88431844/myMicroByte/reports/battery_2026-10-20/电池选购表.md

# v0.10 后盖电池候选（2026-10-20）

淘宝已登录，已查看以下商品详情。后盖电池框52×30 mm，建议电池含保护板、包边的成品包络≤51×29×3.3 mm。下表尺寸顺序均为长×宽×厚。价格为查看时页面显示，不含运费变化或个性化优惠变化。

| 商品图片 | 商家／规格 | 容量 | 商家尺寸依据（mm） | 页面价格 | 商品链接与判断 |
|---|---|---|---|---|---|
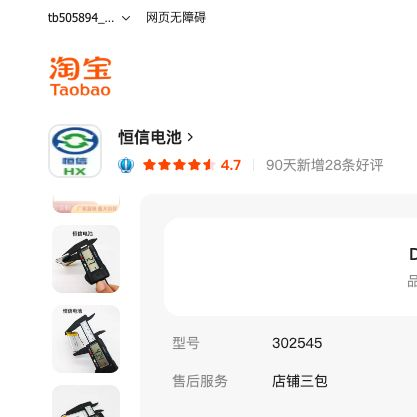
[picture p1: reports/battery_2026-10-20/hengxin.png]
恒信
|  | 恒信电池／302545 | 320 mAh | 标称45×25×3；三张卡尺图约43.4×24.8×2.7 | ¥3.50，页面运费¥6 | [淘宝商品](https://item.taobao.com/item.htm?id=611922672957)。尺寸优先候选；图示样品不代表每批交货尺寸，需确认保护板处最大厚度。 |
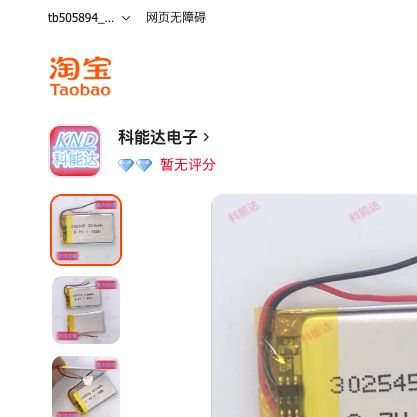
[picture p2: reports/battery_2026-10-20/knd.png]
科能达
|  | 科能达电子／302545 | 320 mAh | 45±0.5 ×25±0.5 ×3.0±0.2；文字说明为带保护板成品 | ¥4.50，页面运费¥6 | [淘宝商品](https://item.taobao.com/item.htm?id=607992859684)。尺寸公差写得较清楚；标题包含其他型号，下单需明确302545。 |
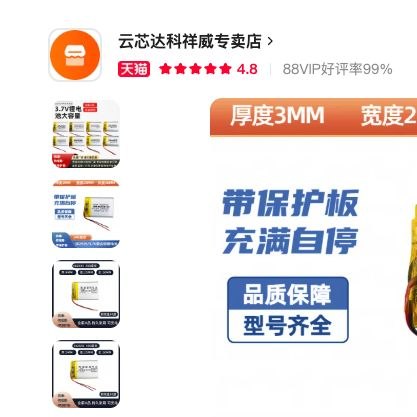
[picture p3: reports/battery_2026-10-20/yunxinda.png]
云芯达
|  | 云芯达科祥威专卖店／302535-240毫安 | 240 mAh | 已选规格图片标36×25×3，带保护板；不是直接按型号推断35 mm长 | ¥9.40，页面免运费 | [淘宝／天猫商品](https://detail.tmall.com/item.htm?id=1014787417174)。空间余量更大、容量较小；只选302535-240毫安。 |

## 选购判断

按机械尺寸优先考虑302545；当前尚不能保证整机电气兼容。恒信和科能达详情均标注最大充、放电1C，即320 mA。其保护板允许2A/3A不等于电芯允许持续输出相同电流。需核对掌机充电设定及ESP32、屏幕、喇叭工作时的峰值电流。云芯达所选240 mAh规格的充放电上限未确认。

PCB参考模型的BAT座标识为HC-1.25-2PWT、2针1.25 mm间距；应核对配套插头外形及正负极，不仅按“1.25插头”名称购买。成品线头、保护板突起不可挤进壳体夹缝。

可复制给卖家的询问（尚未发送）：

> 我要用于ESP32掌机，需要单节3.7V、4.2V充满的锂聚合物电池。请确认含保护板、包边、焊点的最大成品尺寸不超过51×29×3.3 mm，并提供保护板处厚度、持续/峰值放电电流及允许充电电流。需要与HC-1.25-2PWT板端座配套的两针插头，正负极按我提供的PCB接口照片匹配。302545型号能否满足？

本表为尺寸候选清单，不是实测续航或容量认证。未下单、未加入购物车、未联系卖家。
