88431844/myMicroByte/项目文件索引.md

# 项目文件索引

整理日期：2026-10-22。以下均为项目目录内文件，按类型和版本路径排列。

新增移入的装配视图在 `reports/assembly_exports/`，早期在线依赖预览在 `output/assembly-guide-v03-legacy/`。新版交互页面含内嵌模型与脚本。

## 外壳模型与交换文件（31）

- [output/myMicrobyte_FreeCAD_v01_试装包/myMicrobyte_enclosure_v01.FCStd](output/myMicrobyte_FreeCAD_v01_%E8%AF%95%E8%A3%85%E5%8C%85/myMicrobyte_enclosure_v01.FCStd)
- [output/myMicrobyte_FreeCAD_v01_试装包/myMicrobyte_enclosure_v01.step](output/myMicrobyte_FreeCAD_v01_%E8%AF%95%E8%A3%85%E5%8C%85/myMicrobyte_enclosure_v01.step)
- [output/myMicrobyte_FreeCAD_v01_试装包/myMicrobyte_fit_coupons.FCStd](output/myMicrobyte_FreeCAD_v01_%E8%AF%95%E8%A3%85%E5%8C%85/myMicrobyte_fit_coupons.FCStd)
- [output/myMicrobyte_FreeCAD_v01_试装包/myMicrobyte_fit_coupons.step](output/myMicrobyte_FreeCAD_v01_%E8%AF%95%E8%A3%85%E5%8C%85/myMicrobyte_fit_coupons.step)
- [output/myMicrobyte_blackPLA_preview.FCStd](output/myMicrobyte_blackPLA_preview.FCStd)
- [output/myMicrobyte_enclosure_v01.FCStd](output/myMicrobyte_enclosure_v01.FCStd)
- [output/myMicrobyte_enclosure_v01.step](output/myMicrobyte_enclosure_v01.step)
- [output/myMicrobyte_fit_coupons.FCStd](output/myMicrobyte_fit_coupons.FCStd)
- [output/myMicrobyte_fit_coupons.step](output/myMicrobyte_fit_coupons.step)
- [output/v02/myMicrobyte_enclosure_v02.FCStd](output/v02/myMicrobyte_enclosure_v02.FCStd)
- [output/v02/myMicrobyte_enclosure_v02.step](output/v02/myMicrobyte_enclosure_v02.step)
- [output/v03/myMicrobyte_enclosure_v03.FCStd](output/v03/myMicrobyte_enclosure_v03.FCStd)
- [output/v03/myMicrobyte_enclosure_v03.step](output/v03/myMicrobyte_enclosure_v03.step)
- [output/v04/myMicrobyte_enclosure_v04.FCStd](output/v04/myMicrobyte_enclosure_v04.FCStd)
- [output/v04/myMicrobyte_enclosure_v04.step](output/v04/myMicrobyte_enclosure_v04.step)
- [output/v05/myMicrobyte_enclosure_v05.FCStd](output/v05/myMicrobyte_enclosure_v05.FCStd)
- [output/v05/myMicrobyte_enclosure_v05.step](output/v05/myMicrobyte_enclosure_v05.step)
- [output/v06/myMicrobyte_enclosure_v06.FCStd](output/v06/myMicrobyte_enclosure_v06.FCStd)
- [output/v06/myMicrobyte_enclosure_v06.step](output/v06/myMicrobyte_enclosure_v06.step)
- [output/v07/myMicrobyte_enclosure_v07.FCStd](output/v07/myMicrobyte_enclosure_v07.FCStd)
- [output/v07/myMicrobyte_enclosure_v07.step](output/v07/myMicrobyte_enclosure_v07.step)
- [output/v08/myMicrobyte_enclosure_v08.FCStd](output/v08/myMicrobyte_enclosure_v08.FCStd)
- [output/v08/myMicrobyte_v08_A_raised.step](output/v08/myMicrobyte_v08_A_raised.step)
- [output/v08/myMicrobyte_v08_B_flat.step](output/v08/myMicrobyte_v08_B_flat.step)
- [output/v08_trials/myMicrobyte_v08_trials.FCStd](output/v08_trials/myMicrobyte_v08_trials.FCStd)
- [output/v09/myMicrobyte_enclosure_v09.FCStd](output/v09/myMicrobyte_enclosure_v09.FCStd)
- [output/v09/myMicrobyte_enclosure_v09.step](output/v09/myMicrobyte_enclosure_v09.step)
- [output/v10/myMicrobyte_enclosure_v10.FCStd](output/v10/myMicrobyte_enclosure_v10.FCStd)
- [output/v10/myMicrobyte_enclosure_v10.step](output/v10/myMicrobyte_enclosure_v10.step)
- [reference/pcb-current.step](reference/pcb-current.step)
- [reports/battery_expansion/enlarged_frame_study.FCStd](reports/battery_expansion/enlarged_frame_study.FCStd)

## STL 打印模型（127）

- [output/Cap_A_print.stl](output/Cap_A_print.stl)
- [output/Cap_B_print.stl](output/Cap_B_print.stl)
- [output/Cap_DOWN_print.stl](output/Cap_DOWN_print.stl)
- [output/Cap_LEFT_print.stl](output/Cap_LEFT_print.stl)
- [output/Cap_MENU_print.stl](output/Cap_MENU_print.stl)
- [output/Cap_RIGHT_print.stl](output/Cap_RIGHT_print.stl)
- [output/Cap_SELECT_print.stl](output/Cap_SELECT_print.stl)
- [output/Cap_START_print.stl](output/Cap_START_print.stl)
- [output/Cap_UP_print.stl](output/Cap_UP_print.stl)
- [output/Fit_ButtonGuide.stl](output/Fit_ButtonGuide.stl)
- [output/Fit_FrontReceiver.stl](output/Fit_FrontReceiver.stl)
- [output/Fit_RearTongue.stl](output/Fit_RearTongue.stl)
- [output/Fit_ScrewPilot.stl](output/Fit_ScrewPilot.stl)
- [output/FrontShell_print.stl](output/FrontShell_print.stl)
- [output/RearShell_print.stl](output/RearShell_print.stl)
- [output/myMicrobyte_FreeCAD_v01_试装包/Cap_A_print.stl](output/myMicrobyte_FreeCAD_v01_%E8%AF%95%E8%A3%85%E5%8C%85/Cap_A_print.stl)
- [output/myMicrobyte_FreeCAD_v01_试装包/Cap_B_print.stl](output/myMicrobyte_FreeCAD_v01_%E8%AF%95%E8%A3%85%E5%8C%85/Cap_B_print.stl)
- [output/myMicrobyte_FreeCAD_v01_试装包/Cap_DOWN_print.stl](output/myMicrobyte_FreeCAD_v01_%E8%AF%95%E8%A3%85%E5%8C%85/Cap_DOWN_print.stl)
- [output/myMicrobyte_FreeCAD_v01_试装包/Cap_LEFT_print.stl](output/myMicrobyte_FreeCAD_v01_%E8%AF%95%E8%A3%85%E5%8C%85/Cap_LEFT_print.stl)
- [output/myMicrobyte_FreeCAD_v01_试装包/Cap_MENU_print.stl](output/myMicrobyte_FreeCAD_v01_%E8%AF%95%E8%A3%85%E5%8C%85/Cap_MENU_print.stl)
- [output/myMicrobyte_FreeCAD_v01_试装包/Cap_RIGHT_print.stl](output/myMicrobyte_FreeCAD_v01_%E8%AF%95%E8%A3%85%E5%8C%85/Cap_RIGHT_print.stl)
- [output/myMicrobyte_FreeCAD_v01_试装包/Cap_SELECT_print.stl](output/myMicrobyte_FreeCAD_v01_%E8%AF%95%E8%A3%85%E5%8C%85/Cap_SELECT_print.stl)
- [output/myMicrobyte_FreeCAD_v01_试装包/Cap_START_print.stl](output/myMicrobyte_FreeCAD_v01_%E8%AF%95%E8%A3%85%E5%8C%85/Cap_START_print.stl)
- [output/myMicrobyte_FreeCAD_v01_试装包/Cap_UP_print.stl](output/myMicrobyte_FreeCAD_v01_%E8%AF%95%E8%A3%85%E5%8C%85/Cap_UP_print.stl)
- [output/myMicrobyte_FreeCAD_v01_试装包/Fit_ButtonGuide.stl](output/myMicrobyte_FreeCAD_v01_%E8%AF%95%E8%A3%85%E5%8C%85/Fit_ButtonGuide.stl)
- [output/myMicrobyte_FreeCAD_v01_试装包/Fit_FrontReceiver.stl](output/myMicrobyte_FreeCAD_v01_%E8%AF%95%E8%A3%85%E5%8C%85/Fit_FrontReceiver.stl)
- [output/myMicrobyte_FreeCAD_v01_试装包/Fit_RearTongue.stl](output/myMicrobyte_FreeCAD_v01_%E8%AF%95%E8%A3%85%E5%8C%85/Fit_RearTongue.stl)
- [output/myMicrobyte_FreeCAD_v01_试装包/Fit_ScrewPilot.stl](output/myMicrobyte_FreeCAD_v01_%E8%AF%95%E8%A3%85%E5%8C%85/Fit_ScrewPilot.stl)
- [output/myMicrobyte_FreeCAD_v01_试装包/FrontShell_print.stl](output/myMicrobyte_FreeCAD_v01_%E8%AF%95%E8%A3%85%E5%8C%85/FrontShell_print.stl)
- [output/myMicrobyte_FreeCAD_v01_试装包/RearShell_print.stl](output/myMicrobyte_FreeCAD_v01_%E8%AF%95%E8%A3%85%E5%8C%85/RearShell_print.stl)
- [output/v02/Cap_A_print.stl](output/v02/Cap_A_print.stl)
- [output/v02/Cap_B_print.stl](output/v02/Cap_B_print.stl)
- [output/v02/Cap_DOWN_print.stl](output/v02/Cap_DOWN_print.stl)
- [output/v02/Cap_LEFT_print.stl](output/v02/Cap_LEFT_print.stl)
- [output/v02/Cap_MENU_print.stl](output/v02/Cap_MENU_print.stl)
- [output/v02/Cap_RIGHT_print.stl](output/v02/Cap_RIGHT_print.stl)
- [output/v02/Cap_SELECT_print.stl](output/v02/Cap_SELECT_print.stl)
- [output/v02/Cap_START_print.stl](output/v02/Cap_START_print.stl)
- [output/v02/Cap_UP_print.stl](output/v02/Cap_UP_print.stl)
- [output/v02/FrontShell_print.stl](output/v02/FrontShell_print.stl)
- [output/v02/RearShell_print.stl](output/v02/RearShell_print.stl)
- [output/v03/Cap_A_print.stl](output/v03/Cap_A_print.stl)
- [output/v03/Cap_B_print.stl](output/v03/Cap_B_print.stl)
- [output/v03/Cap_DOWN_print.stl](output/v03/Cap_DOWN_print.stl)
- [output/v03/Cap_LEFT_print.stl](output/v03/Cap_LEFT_print.stl)
- [output/v03/Cap_MENU_print.stl](output/v03/Cap_MENU_print.stl)
- [output/v03/Cap_RIGHT_print.stl](output/v03/Cap_RIGHT_print.stl)
- [output/v03/Cap_SELECT_print.stl](output/v03/Cap_SELECT_print.stl)
- [output/v03/Cap_START_print.stl](output/v03/Cap_START_print.stl)
- [output/v03/Cap_UP_print.stl](output/v03/Cap_UP_print.stl)
- [output/v03/FrontShell_print.stl](output/v03/FrontShell_print.stl)
- [output/v03/PowerSlider_print.stl](output/v03/PowerSlider_print.stl)
- [output/v03/RearShell_print.stl](output/v03/RearShell_print.stl)
- [output/v04/FrontShell_print.stl](output/v04/FrontShell_print.stl)
- [output/v04/PowerSlider_print.stl](output/v04/PowerSlider_print.stl)
- [output/v04/RearShell_print.stl](output/v04/RearShell_print.stl)
- [output/v05/FrontShell_print.stl](output/v05/FrontShell_print.stl)
- [output/v05/PowerSlider_print.stl](output/v05/PowerSlider_print.stl)
- [output/v05/RearShell_print.stl](output/v05/RearShell_print.stl)
- [output/v06/AcousticLid_print.stl](output/v06/AcousticLid_print.stl)
- [output/v06/FrontShell_print.stl](output/v06/FrontShell_print.stl)
- [output/v06/PowerSlider_print.stl](output/v06/PowerSlider_print.stl)
- [output/v06/RearShell_print.stl](output/v06/RearShell_print.stl)
- [output/v07/AcousticLid_print.stl](output/v07/AcousticLid_print.stl)
- [output/v07/FrontShell_print.stl](output/v07/FrontShell_print.stl)
- [output/v07/PowerSlider_print.stl](output/v07/PowerSlider_print.stl)
- [output/v07/RearShell_print.stl](output/v07/RearShell_print.stl)
- [output/v08/AcousticLid_print.stl](output/v08/AcousticLid_print.stl)
- [output/v08/FrontShell_A_raised_print.stl](output/v08/FrontShell_A_raised_print.stl)
- [output/v08/FrontShell_B_flat_print.stl](output/v08/FrontShell_B_flat_print.stl)
- [output/v08/PowerSlider_print.stl](output/v08/PowerSlider_print.stl)
- [output/v08/RearShell_print.stl](output/v08/RearShell_print.stl)
- [output/v08_trials/F1_print.stl](output/v08_trials/F1_print.stl)
- [output/v08_trials/F2_print.stl](output/v08_trials/F2_print.stl)
- [output/v08_trials/F3_print.stl](output/v08_trials/F3_print.stl)
- [output/v08_trials/F4_print.stl](output/v08_trials/F4_print.stl)
- [output/v08_trials/L1_print.stl](output/v08_trials/L1_print.stl)
- [output/v08_trials/L2_print.stl](output/v08_trials/L2_print.stl)
- [output/v08_trials/R1_print.stl](output/v08_trials/R1_print.stl)
- [output/v08_trials/R2_print.stl](output/v08_trials/R2_print.stl)
- [output/v08_trials/S1_print.stl](output/v08_trials/S1_print.stl)
- [output/v08_trials/S2_print.stl](output/v08_trials/S2_print.stl)
- [output/v08_trials/S3_print.stl](output/v08_trials/S3_print.stl)
- [output/v09/FrontShell_print.stl](output/v09/FrontShell_print.stl)
- [output/v09/PowerSlider_print.stl](output/v09/PowerSlider_print.stl)
- [output/v09/RearShell_print.stl](output/v09/RearShell_print.stl)
- [output/v09/SliderKeeper_print.stl](output/v09/SliderKeeper_print.stl)
- [output/v10/FrontShell_print.stl](output/v10/FrontShell_print.stl)
- [output/v10/PowerSlider_print.stl](output/v10/PowerSlider_print.stl)
- [output/v10/RearShell_print.stl](output/v10/RearShell_print.stl)
- [printing/A1_black_PLA_v08_trials/F1_print.stl](printing/A1_black_PLA_v08_trials/F1_print.stl)
- [printing/A1_black_PLA_v08_trials/F2_print.stl](printing/A1_black_PLA_v08_trials/F2_print.stl)
- [printing/A1_black_PLA_v08_trials/F3_print.stl](printing/A1_black_PLA_v08_trials/F3_print.stl)
- [printing/A1_black_PLA_v08_trials/F4_print.stl](printing/A1_black_PLA_v08_trials/F4_print.stl)
- [printing/A1_black_PLA_v08_trials/L1_print.stl](printing/A1_black_PLA_v08_trials/L1_print.stl)
- [printing/A1_black_PLA_v08_trials/L2_print.stl](printing/A1_black_PLA_v08_trials/L2_print.stl)
- [printing/A1_black_PLA_v08_trials/R1_print.stl](printing/A1_black_PLA_v08_trials/R1_print.stl)
- [printing/A1_black_PLA_v08_trials/R2_print.stl](printing/A1_black_PLA_v08_trials/R2_print.stl)
- [printing/A1_black_PLA_v08_trials/S1_print.stl](printing/A1_black_PLA_v08_trials/S1_print.stl)
- [printing/A1_black_PLA_v08_trials/S2_print.stl](printing/A1_black_PLA_v08_trials/S2_print.stl)
- [printing/A1_black_PLA_v08_trials/S3_print.stl](printing/A1_black_PLA_v08_trials/S3_print.stl)
- [printing/A1_black_PLA_v10/FrontShell_print.stl](printing/A1_black_PLA_v10/FrontShell_print.stl)
- [printing/A1_black_PLA_v10/PowerSlider_print.stl](printing/A1_black_PLA_v10/PowerSlider_print.stl)
- [printing/A1_black_PLA_v10/RearShell_print.stl](printing/A1_black_PLA_v10/RearShell_print.stl)
- [printing/A1_black_PLA_v10_4sets/FrontShell_set1.stl](printing/A1_black_PLA_v10_4sets/FrontShell_set1.stl)
- [printing/A1_black_PLA_v10_4sets/FrontShell_set2.stl](printing/A1_black_PLA_v10_4sets/FrontShell_set2.stl)
- [printing/A1_black_PLA_v10_4sets/FrontShell_set3.stl](printing/A1_black_PLA_v10_4sets/FrontShell_set3.stl)
- [printing/A1_black_PLA_v10_4sets/FrontShell_set4.stl](printing/A1_black_PLA_v10_4sets/FrontShell_set4.stl)
- [printing/A1_black_PLA_v10_4sets/PowerSlider_set1.stl](printing/A1_black_PLA_v10_4sets/PowerSlider_set1.stl)
- [printing/A1_black_PLA_v10_4sets/PowerSlider_set2.stl](printing/A1_black_PLA_v10_4sets/PowerSlider_set2.stl)
- [printing/A1_black_PLA_v10_4sets/PowerSlider_set3.stl](printing/A1_black_PLA_v10_4sets/PowerSlider_set3.stl)
- [printing/A1_black_PLA_v10_4sets/PowerSlider_set4.stl](printing/A1_black_PLA_v10_4sets/PowerSlider_set4.stl)
- [printing/A1_black_PLA_v10_4sets/RearShell_set1.stl](printing/A1_black_PLA_v10_4sets/RearShell_set1.stl)
- [printing/A1_black_PLA_v10_4sets/RearShell_set2.stl](printing/A1_black_PLA_v10_4sets/RearShell_set2.stl)
- [printing/A1_black_PLA_v10_4sets/RearShell_set3.stl](printing/A1_black_PLA_v10_4sets/RearShell_set3.stl)
- [printing/A1_black_PLA_v10_4sets/RearShell_set4.stl](printing/A1_black_PLA_v10_4sets/RearShell_set4.stl)
- [printing/A1_black_green_blue_PLA_v07/AcousticLid_print.stl](printing/A1_black_green_blue_PLA_v07/AcousticLid_print.stl)
- [printing/A1_black_green_blue_PLA_v07/FrontShell_print.stl](printing/A1_black_green_blue_PLA_v07/FrontShell_print.stl)
- [printing/A1_black_green_blue_PLA_v07/PowerSlider_black_1.stl](printing/A1_black_green_blue_PLA_v07/PowerSlider_black_1.stl)
- [printing/A1_black_green_blue_PLA_v07/PowerSlider_black_2.stl](printing/A1_black_green_blue_PLA_v07/PowerSlider_black_2.stl)
- [printing/A1_black_green_blue_PLA_v07/PowerSlider_blue_1.stl](printing/A1_black_green_blue_PLA_v07/PowerSlider_blue_1.stl)
- [printing/A1_black_green_blue_PLA_v07/PowerSlider_blue_2.stl](printing/A1_black_green_blue_PLA_v07/PowerSlider_blue_2.stl)
- [printing/A1_black_green_blue_PLA_v07/PowerSlider_green_1.stl](printing/A1_black_green_blue_PLA_v07/PowerSlider_green_1.stl)
- [printing/A1_black_green_blue_PLA_v07/PowerSlider_green_2.stl](printing/A1_black_green_blue_PLA_v07/PowerSlider_green_2.stl)
- [printing/A1_black_green_blue_PLA_v07/RearShell_print.stl](printing/A1_black_green_blue_PLA_v07/RearShell_print.stl)
- [printing/A1_blue_PLA_expanded_rear_2/RearExpanded_1.stl](printing/A1_blue_PLA_expanded_rear_2/RearExpanded_1.stl)
- [printing/A1_blue_PLA_expanded_rear_2/RearExpanded_2.stl](printing/A1_blue_PLA_expanded_rear_2/RearExpanded_2.stl)

## 拓竹打印工程与切片（14）

- [printing/A1_black_PLA/myMicrobyte_A1_black_PLA_sliced.3mf](printing/A1_black_PLA/myMicrobyte_A1_black_PLA_sliced.3mf)
- [printing/A1_black_PLA_v02/myMicrobyte_v02_A1_black_PLA_sliced.3mf](printing/A1_black_PLA_v02/myMicrobyte_v02_A1_black_PLA_sliced.3mf)
- [printing/A1_black_PLA_v03/myMicrobyte_v03_A1_black_PLA_sliced.3mf](printing/A1_black_PLA_v03/myMicrobyte_v03_A1_black_PLA_sliced.3mf)
- [printing/A1_black_PLA_v04/myMicrobyte_v04_A1_black_PLA_sliced.3mf](printing/A1_black_PLA_v04/myMicrobyte_v04_A1_black_PLA_sliced.3mf)
- [printing/A1_black_PLA_v08_trials/myMicrobyte_v08_trials_black.3mf](printing/A1_black_PLA_v08_trials/myMicrobyte_v08_trials_black.3mf)
- [printing/A1_black_PLA_v08_trials/myMicrobyte_v08_trials_black.gcode.3mf](printing/A1_black_PLA_v08_trials/myMicrobyte_v08_trials_black.gcode.3mf)
- [printing/A1_black_PLA_v10/myMicrobyte_v10_black.3mf](printing/A1_black_PLA_v10/myMicrobyte_v10_black.3mf)
- [printing/A1_black_PLA_v10/myMicrobyte_v10_black.gcode.3mf](printing/A1_black_PLA_v10/myMicrobyte_v10_black.gcode.3mf)
- [printing/A1_black_PLA_v10_4sets/myMicrobyte_v10_4sets_black.3mf](printing/A1_black_PLA_v10_4sets/myMicrobyte_v10_4sets_black.3mf)
- [printing/A1_black_PLA_v10_4sets/myMicrobyte_v10_4sets_black.gcode.3mf](printing/A1_black_PLA_v10_4sets/myMicrobyte_v10_4sets_black.gcode.3mf)
- [printing/A1_black_green_blue_PLA_v07/myMicrobyte_v07_A1_black_green_blue.3mf](printing/A1_black_green_blue_PLA_v07/myMicrobyte_v07_A1_black_green_blue.3mf)
- [printing/A1_black_green_blue_PLA_v07/myMicrobyte_v07_A1_black_green_blue.gcode.3mf](printing/A1_black_green_blue_PLA_v07/myMicrobyte_v07_A1_black_green_blue.gcode.3mf)
- [printing/A1_blue_PLA_expanded_rear_2/myMicrobyte_expanded_rear_2_blue.3mf](printing/A1_blue_PLA_expanded_rear_2/myMicrobyte_expanded_rear_2_blue.3mf)
- [printing/A1_blue_PLA_expanded_rear_2/myMicrobyte_expanded_rear_2_blue.gcode.3mf](printing/A1_blue_PLA_expanded_rear_2/myMicrobyte_expanded_rear_2_blue.gcode.3mf)

## 3D 交互装配与爆炸图页面（9）

- [output/assembly-guide/index.html](output/assembly-guide/index.html)
- [output/assembly-guide-v03-legacy/index.html](output/assembly-guide-v03-legacy/index.html)
- [output/assembly-guide-v04/index.html](output/assembly-guide-v04/index.html)
- [output/assembly-guide-v05/index.html](output/assembly-guide-v05/index.html)
- [output/assembly-guide-v06/index.html](output/assembly-guide-v06/index.html)
- [output/assembly-guide-v07/index.html](output/assembly-guide-v07/index.html)
- [output/assembly-guide-v08/index.html](output/assembly-guide-v08/index.html)
- [output/assembly-guide-v09/index.html](output/assembly-guide-v09/index.html)
- [output/assembly-guide-v10/index.html](output/assembly-guide-v10/index.html)

## 图片与对比图（253）

- [output/myMicrobyte_FreeCAD_v01_试装包/reports/assembly.png](output/myMicrobyte_FreeCAD_v01_%E8%AF%95%E8%A3%85%E5%8C%85/reports/assembly.png)
- [output/myMicrobyte_FreeCAD_v01_试装包/reports/freecad_preview.png](output/myMicrobyte_FreeCAD_v01_%E8%AF%95%E8%A3%85%E5%8C%85/reports/freecad_preview.png)
- [output/myMicrobyte_FreeCAD_v01_试装包/reports/front_inside.png](output/myMicrobyte_FreeCAD_v01_%E8%AF%95%E8%A3%85%E5%8C%85/reports/front_inside.png)
- [output/myMicrobyte_FreeCAD_v01_试装包/reports/rear_inside.png](output/myMicrobyte_FreeCAD_v01_%E8%AF%95%E8%A3%85%E5%8C%85/reports/rear_inside.png)
- [output/v08/v08_acoustic_slider_details.png](output/v08/v08_acoustic_slider_details.png)
- [output/v08/v08_exploded_comparison.png](output/v08/v08_exploded_comparison.png)
- [output/v08/v08_front_comparison.png](output/v08/v08_front_comparison.png)
- [output/v09/v09_assembly_review.png](output/v09/v09_assembly_review.png)
- [output/v09/v09_rear_slider_review.png](output/v09/v09_rear_slider_review.png)
- [output/v09/v09_screen_review.png](output/v09/v09_screen_review.png)
- [output/v10/v10_assembly_review.png](output/v10/v10_assembly_review.png)
- [output/v10/v10_gba_slider_review.png](output/v10/v10_gba_slider_review.png)
- [reference/eda_backup/IMAGE/464badd25d2691be.webp](reference/eda_backup/IMAGE/464badd25d2691be.webp)
- [reference/eda_backup/IMAGE/5a8d8aaf7cc2b85a.webp](reference/eda_backup/IMAGE/5a8d8aaf7cc2b85a.webp)
- [reference/filaments_20261017/loaded_slots.jpg](reference/filaments_20261017/loaded_slots.jpg)
- [reference/filaments_20261017/stock.jpg](reference/filaments_20261017/stock.jpg)
- [reference/user_dimensions/LCD_1p9mm.png](reference/user_dimensions/LCD_1p9mm.png)
- [reference/user_dimensions/Speaker_1510.png](reference/user_dimensions/Speaker_1510.png)
- [reference/v03_feedback/MSK12C02_dimensions.png](reference/v03_feedback/MSK12C02_dimensions.png)
- [reference/v04_feedback/lcd_dimensions.png](reference/v04_feedback/lcd_dimensions.png)
- [reference/v04_feedback/photo_01.jpg](reference/v04_feedback/photo_01.jpg)
- [reference/v04_feedback/photo_02.jpg](reference/v04_feedback/photo_02.jpg)
- [reference/v04_feedback/photo_03.jpg](reference/v04_feedback/photo_03.jpg)
- [reference/v04_feedback/photo_04.jpg](reference/v04_feedback/photo_04.jpg)
- [reference/v04_feedback/photo_05.jpg](reference/v04_feedback/photo_05.jpg)
- [reference/v04_feedback/photo_06.jpg](reference/v04_feedback/photo_06.jpg)
- [reference/v04_feedback/photo_07.jpg](reference/v04_feedback/photo_07.jpg)
- [reference/v04_feedback/photo_08.jpg](reference/v04_feedback/photo_08.jpg)
- [reference/v04_feedback/photo_09.jpg](reference/v04_feedback/photo_09.jpg)
- [reference/v04_feedback/photo_10.jpg](reference/v04_feedback/photo_10.jpg)
- [reference/v04_feedback/photo_11.jpg](reference/v04_feedback/photo_11.jpg)
- [reference/v04_feedback/photo_12.jpg](reference/v04_feedback/photo_12.jpg)
- [reference/v04_feedback/photo_13.jpg](reference/v04_feedback/photo_13.jpg)
- [reference/v04_feedback/photo_14.jpg](reference/v04_feedback/photo_14.jpg)
- [reference/v05_feedback/attachment_01.jpg](reference/v05_feedback/attachment_01.jpg)
- [reference/v05_feedback/attachment_02.jpg](reference/v05_feedback/attachment_02.jpg)
- [reference/v05_feedback/attachment_03.jpg](reference/v05_feedback/attachment_03.jpg)
- [reference/v05_feedback/attachment_04.jpg](reference/v05_feedback/attachment_04.jpg)
- [reference/v05_feedback/attachment_05.jpg](reference/v05_feedback/attachment_05.jpg)
- [reference/v05_feedback/attachment_06.jpg](reference/v05_feedback/attachment_06.jpg)
- [reference/v05_feedback/attachment_07.jpg](reference/v05_feedback/attachment_07.jpg)
- [reference/v05_feedback/attachment_08.jpg](reference/v05_feedback/attachment_08.jpg)
- [reference/v05_feedback/attachment_09.jpg](reference/v05_feedback/attachment_09.jpg)
- [reference/v05_feedback/contact_sheet.jpg](reference/v05_feedback/contact_sheet.jpg)
- [reference/v08_feedback/photo_01.jpg](reference/v08_feedback/photo_01.jpg)
- [reference/v08_feedback/photo_02.jpg](reference/v08_feedback/photo_02.jpg)
- [reference/v08_feedback/photo_03.jpg](reference/v08_feedback/photo_03.jpg)
- [reference/v08_feedback/photo_04.jpg](reference/v08_feedback/photo_04.jpg)
- [reference/v08_feedback/photo_05.jpg](reference/v08_feedback/photo_05.jpg)
- [reference/v08_feedback/photo_06.jpg](reference/v08_feedback/photo_06.jpg)
- [reference/v09_feedback/IMG_8476.jpg](reference/v09_feedback/IMG_8476.jpg)
- [reference/v09_feedback/IMG_8477.jpg](reference/v09_feedback/IMG_8477.jpg)
- [reference/v09_feedback/IMG_8478.jpg](reference/v09_feedback/IMG_8478.jpg)
- [reference/v09_feedback/IMG_8479.jpg](reference/v09_feedback/IMG_8479.jpg)
- [reference/v09_feedback/IMG_8480.jpg](reference/v09_feedback/IMG_8480.jpg)
- [reference/v09_feedback/contact_sheet.jpg](reference/v09_feedback/contact_sheet.jpg)
- [reference/v09_feedback/weak_slider_tabs.png](reference/v09_feedback/weak_slider_tabs.png)
- [reference/v10_gba/gba_slider_removed.png](reference/v10_gba/gba_slider_removed.png)
- [reference/v10_gba/gba_slider_seated.png](reference/v10_gba/gba_slider_seated.png)
- [reports/Bambu_A1_preview.png](reports/Bambu_A1_preview.png)
- [reports/assembly.png](reports/assembly.png)
- [reports/assembly_exports/v03/myMicrobyte-v03-装配视图.png](reports/assembly_exports/v03/myMicrobyte-v03-%E8%A3%85%E9%85%8D%E8%A7%86%E5%9B%BE.png)
- [reports/assembly_exports/v06/myMicrobyte-v06-装配视图 (1).png](reports/assembly_exports/v06/myMicrobyte-v06-%E8%A3%85%E9%85%8D%E8%A7%86%E5%9B%BE%20%281%29.png)
- [reports/assembly_exports/v06/myMicrobyte-v06-装配视图 (2).png](reports/assembly_exports/v06/myMicrobyte-v06-%E8%A3%85%E9%85%8D%E8%A7%86%E5%9B%BE%20%282%29.png)
- [reports/assembly_exports/v06/myMicrobyte-v06-装配视图 (3).png](reports/assembly_exports/v06/myMicrobyte-v06-%E8%A3%85%E9%85%8D%E8%A7%86%E5%9B%BE%20%283%29.png)
- [reports/assembly_exports/v06/myMicrobyte-v06-装配视图 (4).png](reports/assembly_exports/v06/myMicrobyte-v06-%E8%A3%85%E9%85%8D%E8%A7%86%E5%9B%BE%20%284%29.png)
- [reports/assembly_exports/v06/myMicrobyte-v06-装配视图.png](reports/assembly_exports/v06/myMicrobyte-v06-%E8%A3%85%E9%85%8D%E8%A7%86%E5%9B%BE.png)
- [reports/assembly_exports/v07/myMicrobyte-v07-装配视图 (1).png](reports/assembly_exports/v07/myMicrobyte-v07-%E8%A3%85%E9%85%8D%E8%A7%86%E5%9B%BE%20%281%29.png)
- [reports/assembly_exports/v07/myMicrobyte-v07-装配视图 (2).png](reports/assembly_exports/v07/myMicrobyte-v07-%E8%A3%85%E9%85%8D%E8%A7%86%E5%9B%BE%20%282%29.png)
- [reports/assembly_exports/v07/myMicrobyte-v07-装配视图 (3).png](reports/assembly_exports/v07/myMicrobyte-v07-%E8%A3%85%E9%85%8D%E8%A7%86%E5%9B%BE%20%283%29.png)
- [reports/assembly_exports/v07/myMicrobyte-v07-装配视图 (4).png](reports/assembly_exports/v07/myMicrobyte-v07-%E8%A3%85%E9%85%8D%E8%A7%86%E5%9B%BE%20%284%29.png)
- [reports/assembly_exports/v07/myMicrobyte-v07-装配视图 (5).png](reports/assembly_exports/v07/myMicrobyte-v07-%E8%A3%85%E9%85%8D%E8%A7%86%E5%9B%BE%20%285%29.png)
- [reports/assembly_exports/v07/myMicrobyte-v07-装配视图 (6).png](reports/assembly_exports/v07/myMicrobyte-v07-%E8%A3%85%E9%85%8D%E8%A7%86%E5%9B%BE%20%286%29.png)
- [reports/assembly_exports/v07/myMicrobyte-v07-装配视图 (7).png](reports/assembly_exports/v07/myMicrobyte-v07-%E8%A3%85%E9%85%8D%E8%A7%86%E5%9B%BE%20%287%29.png)
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
- [reports/assembly_exports/v10/myMicrobyte-v10-装配视图 (8).png](reports/assembly_exports/v10/myMicrobyte-v10-%E8%A3%85%E9%85%8D%E8%A7%86%E5%9B%BE%20%288%29.png)
- [reports/assembly_exports/v10/myMicrobyte-v10-装配视图 (9).png](reports/assembly_exports/v10/myMicrobyte-v10-%E8%A3%85%E9%85%8D%E8%A7%86%E5%9B%BE%20%289%29.png)
- [reports/assembly_exports/v10/myMicrobyte-v10-装配视图.png](reports/assembly_exports/v10/myMicrobyte-v10-%E8%A3%85%E9%85%8D%E8%A7%86%E5%9B%BE.png)
- [reports/battery_2026-10-20/hengxin.png](reports/battery_2026-10-20/hengxin.png)
- [reports/battery_2026-10-20/knd.png](reports/battery_2026-10-20/knd.png)
- [reports/battery_2026-10-20/yunxinda.png](reports/battery_2026-10-20/yunxinda.png)
- [reports/battery_expansion/taobao_400_length.png](reports/battery_expansion/taobao_400_length.png)
- [reports/battery_expansion/taobao_400_width.png](reports/battery_expansion/taobao_400_width.png)
- [reports/battery_expansion/taobao_400_with_plug.png](reports/battery_expansion/taobao_400_with_plug.png)
- [reports/battery_expansion/taobao_500.png](reports/battery_expansion/taobao_500.png)
- [reports/battery_expansion/电池扩容前后对比.pdf](reports/battery_expansion/%E7%94%B5%E6%B1%A0%E6%89%A9%E5%AE%B9%E5%89%8D%E5%90%8E%E5%AF%B9%E6%AF%94.pdf)
- [reports/battery_expansion/电池扩容前后对比.png](reports/battery_expansion/%E7%94%B5%E6%B1%A0%E6%89%A9%E5%AE%B9%E5%89%8D%E5%90%8E%E5%AF%B9%E6%AF%94.png)
- [reports/blackPLA_assembly.png](reports/blackPLA_assembly.png)
- [reports/blackPLA_exploded.png](reports/blackPLA_exploded.png)
- [reports/expanded_rear_2/plate_1.png](reports/expanded_rear_2/plate_1.png)
- [reports/expanded_rear_2/print_started.png](reports/expanded_rear_2/print_started.png)
- [reports/expanded_rear_2/send_mapping.png](reports/expanded_rear_2/send_mapping.png)
- [reports/expanded_rear_2/send_mapping_large.png](reports/expanded_rear_2/send_mapping_large.png)
- [reports/expanded_rear_2/top_1.png](reports/expanded_rear_2/top_1.png)
- [reports/freecad_preview.png](reports/freecad_preview.png)
- [reports/front_inside.png](reports/front_inside.png)
- [reports/plate_1.png](reports/plate_1.png)
- [reports/rear_inside.png](reports/rear_inside.png)
- [reports/top_1.png](reports/top_1.png)
- [reports/v02/blackPLA_assembly.png](reports/v02/blackPLA_assembly.png)
- [reports/v02/blackPLA_exploded.png](reports/v02/blackPLA_exploded.png)
- [reports/v02/layout_annotated.png](reports/v02/layout_annotated.png)
- [reports/v02/plate_1.png](reports/v02/plate_1.png)
- [reports/v02/print_started_status.png](reports/v02/print_started_status.png)
- [reports/v02/rear_frame.png](reports/v02/rear_frame.png)
- [reports/v02/rear_layout.png](reports/v02/rear_layout.png)
- [reports/v02/top_1.png](reports/v02/top_1.png)
- [reports/v03/A1_v03_completed.png](reports/v03/A1_v03_completed.png)
- [reports/v03/A1_v03_job_started.png](reports/v03/A1_v03_job_started.png)
- [reports/v03/A1_v03_printing.png](reports/v03/A1_v03_printing.png)
- [reports/v03/assembly-guide-desktop.png](reports/v03/assembly-guide-desktop.png)
- [reports/v03/assembly-guide-ready.png](reports/v03/assembly-guide-ready.png)
- [reports/v03/blackPLA_assembly.png](reports/v03/blackPLA_assembly.png)
- [reports/v03/blackPLA_exploded.png](reports/v03/blackPLA_exploded.png)
- [reports/v03/plate_1.png](reports/v03/plate_1.png)
- [reports/v03/rear_frame.png](reports/v03/rear_frame.png)
- [reports/v03/rear_layout.png](reports/v03/rear_layout.png)
- [reports/v03/top_1.png](reports/v03/top_1.png)
- [reports/v04/A1_v04_completed.png](reports/v04/A1_v04_completed.png)
- [reports/v04/A1_v04_completed_status.png](reports/v04/A1_v04_completed_status.png)
- [reports/v04/A1_v04_job_started.png](reports/v04/A1_v04_job_started.png)
- [reports/v04/A1_v04_printing.png](reports/v04/A1_v04_printing.png)
- [reports/v04/assembly-guide-ready.png](reports/v04/assembly-guide-ready.png)
- [reports/v04/blackPLA_assembly.png](reports/v04/blackPLA_assembly.png)
- [reports/v04/blackPLA_exploded.png](reports/v04/blackPLA_exploded.png)
- [reports/v04/rear_frame.png](reports/v04/rear_frame.png)
- [reports/v04/rear_layout.png](reports/v04/rear_layout.png)
- [reports/v04/slicer/Metadata/plate_1.png](reports/v04/slicer/Metadata/plate_1.png)
- [reports/v04/slicer/Metadata/plate_1_small.png](reports/v04/slicer/Metadata/plate_1_small.png)
- [reports/v04/slicer/Metadata/top_1.png](reports/v04/slicer/Metadata/top_1.png)
- [reports/v05/blackPLA_assembly.png](reports/v05/blackPLA_assembly.png)
- [reports/v05/blackPLA_exploded.png](reports/v05/blackPLA_exploded.png)
- [reports/v05/preview_RUN_closed.png](reports/v05/preview_RUN_closed.png)
- [reports/v05/rear_frame.png](reports/v05/rear_frame.png)
- [reports/v05/rear_layout.png](reports/v05/rear_layout.png)
- [reports/v06/acoustic_exploded_ui.png](reports/v06/acoustic_exploded_ui.png)
- [reports/v06/blackPLA_assembly.png](reports/v06/blackPLA_assembly.png)
- [reports/v06/blackPLA_exploded.png](reports/v06/blackPLA_exploded.png)
- [reports/v06/color_black.png](reports/v06/color_black.png)
- [reports/v06/color_comparison.png](reports/v06/color_comparison.png)
- [reports/v06/color_cream.png](reports/v06/color_cream.png)
- [reports/v06/color_gb.png](reports/v06/color_gb.png)
- [reports/v06/color_mint.png](reports/v06/color_mint.png)
- [reports/v06/color_orange.png](reports/v06/color_orange.png)
- [reports/v06/cream_exploded_ui.png](reports/v06/cream_exploded_ui.png)
- [reports/v06/rear_frame.png](reports/v06/rear_frame.png)
- [reports/v06/rear_layout.png](reports/v06/rear_layout.png)
- [reports/v07/A1_bed_clear.png](reports/v07/A1_bed_clear.png)
- [reports/v07/A1_v07_send_mapping.png](reports/v07/A1_v07_send_mapping.png)
- [reports/v07/A1_v07_send_mapping_crop.png](reports/v07/A1_v07_send_mapping_crop.png)
- [reports/v07/A1_v07_sliced.png](reports/v07/A1_v07_sliced.png)
- [reports/v07/A1_v07_started.png](reports/v07/A1_v07_started.png)
- [reports/v07/acoustic_sliced_layers.png](reports/v07/acoustic_sliced_layers.png)
- [reports/v07/color_black_green.png](reports/v07/color_black_green.png)
- [reports/v07/color_blue_green.png](reports/v07/color_blue_green.png)
- [reports/v07/color_clear_back.png](reports/v07/color_clear_back.png)
- [reports/v07/color_gray_black.png](reports/v07/color_gray_black.png)
- [reports/v07/color_green_blue.png](reports/v07/color_green_blue.png)
- [reports/v07/color_red_yellow.png](reports/v07/color_red_yellow.png)
- [reports/v07/color_silver_red.png](reports/v07/color_silver_red.png)
- [reports/v07/color_white_gray.png](reports/v07/color_white_gray.png)
- [reports/v07/color_yellow_red.png](reports/v07/color_yellow_red.png)
- [reports/v07/dry_acoustic_exploded_ui.png](reports/v07/dry_acoustic_exploded_ui.png)
- [reports/v07/stock_color_comparison.png](reports/v07/stock_color_comparison.png)
- [reports/v07/stock_color_comparison_printing.png](reports/v07/stock_color_comparison_printing.png)
- [reports/v07/stock_exploded_ui.png](reports/v07/stock_exploded_ui.png)
- [reports/v08/acoustic_exploded.png](reports/v08/acoustic_exploded.png)
- [reports/v08/desk_sound_path.png](reports/v08/desk_sound_path.png)
- [reports/v08/front_A_assembled.png](reports/v08/front_A_assembled.png)
- [reports/v08/front_A_exploded.png](reports/v08/front_A_exploded.png)
- [reports/v08/front_A_height.png](reports/v08/front_A_height.png)
- [reports/v08/front_B_assembled.png](reports/v08/front_B_assembled.png)
- [reports/v08/front_B_exploded.png](reports/v08/front_B_exploded.png)
- [reports/v08/front_B_height.png](reports/v08/front_B_height.png)
- [reports/v08/interactive_page_final.png](reports/v08/interactive_page_final.png)
- [reports/v08/slider_closeup.png](reports/v08/slider_closeup.png)
- [reports/v08_trials/A1_bed_clear.png](reports/v08_trials/A1_bed_clear.png)
- [reports/v08_trials/A1_first_layer.png](reports/v08_trials/A1_first_layer.png)
- [reports/v08_trials/A1_job_started.png](reports/v08_trials/A1_job_started.png)
- [reports/v08_trials/A1_plate_preview.png](reports/v08_trials/A1_plate_preview.png)
- [reports/v08_trials/A1_send_mapping.png](reports/v08_trials/A1_send_mapping.png)
- [reports/v08_trials/A1_send_mapping_crop.png](reports/v08_trials/A1_send_mapping_crop.png)
- [reports/v08_trials/engraved_ids_toolpaths.png](reports/v08_trials/engraved_ids_toolpaths.png)
- [reports/v08_trials/keeper_acoustic_toolpaths.png](reports/v08_trials/keeper_acoustic_toolpaths.png)
- [reports/v08_trials/plate_1.png](reports/v08_trials/plate_1.png)
- [reports/v08_trials/plate_id_map.png](reports/v08_trials/plate_id_map.png)
- [reports/v08_trials/top_1.png](reports/v08_trials/top_1.png)
- [reports/v09/front_assembled.png](reports/v09/front_assembled.png)
- [reports/v09/front_inside.png](reports/v09/front_inside.png)
- [reports/v09/interactive_black_exploded.png](reports/v09/interactive_black_exploded.png)
- [reports/v09/interactive_final.png](reports/v09/interactive_final.png)
- [reports/v09/keeper_install.png](reports/v09/keeper_install.png)
- [reports/v09/keeper_seated.png](reports/v09/keeper_seated.png)
- [reports/v09/rear_exterior.png](reports/v09/rear_exterior.png)
- [reports/v09/screen_clearance_section.png](reports/v09/screen_clearance_section.png)
- [reports/v09/speaker_exploded.png](reports/v09/speaker_exploded.png)
- [reports/v09/whole_exploded.png](reports/v09/whole_exploded.png)
- [reports/v10/A1_bed_clear.png](reports/v10/A1_bed_clear.png)
- [reports/v10/A1_v10_send_mapping.png](reports/v10/A1_v10_send_mapping.png)
- [reports/v10/A1_v10_send_mapping_crop.png](reports/v10/A1_v10_send_mapping_crop.png)
- [reports/v10/A1_v10_sliced.png](reports/v10/A1_v10_sliced.png)
- [reports/v10/A1_v10_started.png](reports/v10/A1_v10_started.png)
- [reports/v10/front_roof_closed.png](reports/v10/front_roof_closed.png)
- [reports/v10/front_roof_install.png](reports/v10/front_roof_install.png)
- [reports/v10/guide_transparent.png](reports/v10/guide_transparent.png)
- [reports/v10/interactive_final.png](reports/v10/interactive_final.png)
- [reports/v10/plate_1.png](reports/v10/plate_1.png)
- [reports/v10/slider_drop_in.png](reports/v10/slider_drop_in.png)
- [reports/v10/slider_guide_section.png](reports/v10/slider_guide_section.png)
- [reports/v10/slider_inner.png](reports/v10/slider_inner.png)
- [reports/v10/slider_max.png](reports/v10/slider_max.png)
- [reports/v10/slider_min.png](reports/v10/slider_min.png)
- [reports/v10/slider_outer.png](reports/v10/slider_outer.png)
- [reports/v10/slider_seated.png](reports/v10/slider_seated.png)
- [reports/v10/top_1.png](reports/v10/top_1.png)
- [reports/v10/whole_assembled.png](reports/v10/whole_assembled.png)
- [reports/v10/whole_exploded.png](reports/v10/whole_exploded.png)
- [reports/v10_4sets/A1_4sets_started.png](reports/v10_4sets/A1_4sets_started.png)
- [reports/v10_4sets/ams_refill_A3_A4.png](reports/v10_4sets/ams_refill_A3_A4.png)
- [reports/v10_4sets/ams_refill_crop.png](reports/v10_4sets/ams_refill_crop.png)
- [reports/v10_4sets/ams_refill_raw.png](reports/v10_4sets/ams_refill_raw.png)
- [reports/v10_4sets/bed_clear.png](reports/v10_4sets/bed_clear.png)
- [reports/v10_4sets/plate_1.png](reports/v10_4sets/plate_1.png)
- [reports/v10_4sets/plate_sliced.png](reports/v10_4sets/plate_sliced.png)
- [reports/v10_4sets/send_mapping.png](reports/v10_4sets/send_mapping.png)
- [reports/v10_4sets/top_1.png](reports/v10_4sets/top_1.png)

## 说明、校核与参数文件（148）

- [output/README_试装说明.md](output/README_%E8%AF%95%E8%A3%85%E8%AF%B4%E6%98%8E.md)
- [output/assembly-guide/使用说明.md](output/assembly-guide/%E4%BD%BF%E7%94%A8%E8%AF%B4%E6%98%8E.md)
- [output/myMicrobyte_FreeCAD_v01_试装包/README_试装说明.md](output/myMicrobyte_FreeCAD_v01_%E8%AF%95%E8%A3%85%E5%8C%85/README_%E8%AF%95%E8%A3%85%E8%AF%B4%E6%98%8E.md)
- [output/myMicrobyte_FreeCAD_v01_试装包/reports/export_validation.json](output/myMicrobyte_FreeCAD_v01_%E8%AF%95%E8%A3%85%E5%8C%85/reports/export_validation.json)
- [output/myMicrobyte_FreeCAD_v01_试装包/reports/fit_check.json](output/myMicrobyte_FreeCAD_v01_%E8%AF%95%E8%A3%85%E5%8C%85/reports/fit_check.json)
- [output/myMicrobyte_FreeCAD_v01_试装包/reports/motion_and_coupons.json](output/myMicrobyte_FreeCAD_v01_%E8%AF%95%E8%A3%85%E5%8C%85/reports/motion_and_coupons.json)
- [output/v02/README_v02.md](output/v02/README_v02.md)
- [output/v03/README_v03.md](output/v03/README_v03.md)
- [output/v04/README_v04.md](output/v04/README_v04.md)
- [output/v05/README_v05.md](output/v05/README_v05.md)
- [output/v06/README_v06.md](output/v06/README_v06.md)
- [output/v07/README_v07.md](output/v07/README_v07.md)
- [output/v08/README_v08.md](output/v08/README_v08.md)
- [output/v08_trials/configurations.json](output/v08_trials/configurations.json)
- [output/v08_trials/试装说明与记录表.md](output/v08_trials/%E8%AF%95%E8%A3%85%E8%AF%B4%E6%98%8E%E4%B8%8E%E8%AE%B0%E5%BD%95%E8%A1%A8.md)
- [output/v09/README_v09.md](output/v09/README_v09.md)
- [output/v10/README_v10.md](output/v10/README_v10.md)
- [printing/A1_black_PLA/filament.json](printing/A1_black_PLA/filament.json)
- [printing/A1_black_PLA/machine.json](printing/A1_black_PLA/machine.json)
- [printing/A1_black_PLA/process.json](printing/A1_black_PLA/process.json)
- [printing/A1_black_PLA/resolved_settings.json](printing/A1_black_PLA/resolved_settings.json)
- [printing/A1_black_PLA/result.json](printing/A1_black_PLA/result.json)
- [printing/A1_black_PLA/打印说明.md](printing/A1_black_PLA/%E6%89%93%E5%8D%B0%E8%AF%B4%E6%98%8E.md)
- [printing/A1_black_PLA_v02/filament.json](printing/A1_black_PLA_v02/filament.json)
- [printing/A1_black_PLA_v02/machine.json](printing/A1_black_PLA_v02/machine.json)
- [printing/A1_black_PLA_v02/process.json](printing/A1_black_PLA_v02/process.json)
- [printing/A1_black_PLA_v02/resolved_settings.json](printing/A1_black_PLA_v02/resolved_settings.json)
- [printing/A1_black_PLA_v02/result.json](printing/A1_black_PLA_v02/result.json)
- [printing/A1_black_PLA_v02/打印说明_v02.md](printing/A1_black_PLA_v02/%E6%89%93%E5%8D%B0%E8%AF%B4%E6%98%8E_v02.md)
- [printing/A1_black_PLA_v03/filament.json](printing/A1_black_PLA_v03/filament.json)
- [printing/A1_black_PLA_v03/machine.json](printing/A1_black_PLA_v03/machine.json)
- [printing/A1_black_PLA_v03/print_followup_state.json](printing/A1_black_PLA_v03/print_followup_state.json)
- [printing/A1_black_PLA_v03/process.json](printing/A1_black_PLA_v03/process.json)
- [printing/A1_black_PLA_v03/resolved_settings.json](printing/A1_black_PLA_v03/resolved_settings.json)
- [printing/A1_black_PLA_v03/result.json](printing/A1_black_PLA_v03/result.json)
- [printing/A1_black_PLA_v03/打印跟进.md](printing/A1_black_PLA_v03/%E6%89%93%E5%8D%B0%E8%B7%9F%E8%BF%9B.md)
- [printing/A1_black_PLA_v04/filament.json](printing/A1_black_PLA_v04/filament.json)
- [printing/A1_black_PLA_v04/machine.json](printing/A1_black_PLA_v04/machine.json)
- [printing/A1_black_PLA_v04/print_followup_state.json](printing/A1_black_PLA_v04/print_followup_state.json)
- [printing/A1_black_PLA_v04/process.json](printing/A1_black_PLA_v04/process.json)
- [printing/A1_black_PLA_v04/resolved_settings.json](printing/A1_black_PLA_v04/resolved_settings.json)
- [printing/A1_black_PLA_v04/result.json](printing/A1_black_PLA_v04/result.json)
- [printing/A1_black_PLA_v04/打印跟进.md](printing/A1_black_PLA_v04/%E6%89%93%E5%8D%B0%E8%B7%9F%E8%BF%9B.md)
- [printing/A1_black_PLA_v08_trials/command.json](printing/A1_black_PLA_v08_trials/command.json)
- [printing/A1_black_PLA_v08_trials/filament.json](printing/A1_black_PLA_v08_trials/filament.json)
- [printing/A1_black_PLA_v08_trials/machine.json](printing/A1_black_PLA_v08_trials/machine.json)
- [printing/A1_black_PLA_v08_trials/print_followup_state.json](printing/A1_black_PLA_v08_trials/print_followup_state.json)
- [printing/A1_black_PLA_v08_trials/process.json](printing/A1_black_PLA_v08_trials/process.json)
- [printing/A1_black_PLA_v08_trials/resolved_settings.json](printing/A1_black_PLA_v08_trials/resolved_settings.json)
- [printing/A1_black_PLA_v08_trials/result.json](printing/A1_black_PLA_v08_trials/result.json)
- [printing/A1_black_PLA_v10/command.json](printing/A1_black_PLA_v10/command.json)
- [printing/A1_black_PLA_v10/filament.json](printing/A1_black_PLA_v10/filament.json)
- [printing/A1_black_PLA_v10/machine.json](printing/A1_black_PLA_v10/machine.json)
- [printing/A1_black_PLA_v10/print_followup_state.json](printing/A1_black_PLA_v10/print_followup_state.json)
- [printing/A1_black_PLA_v10/process.json](printing/A1_black_PLA_v10/process.json)
- [printing/A1_black_PLA_v10/resolved_settings.json](printing/A1_black_PLA_v10/resolved_settings.json)
- [printing/A1_black_PLA_v10/result.json](printing/A1_black_PLA_v10/result.json)
- [printing/A1_black_PLA_v10_4sets/README.md](printing/A1_black_PLA_v10_4sets/README.md)
- [printing/A1_black_PLA_v10_4sets/command.json](printing/A1_black_PLA_v10_4sets/command.json)
- [printing/A1_black_PLA_v10_4sets/filament.json](printing/A1_black_PLA_v10_4sets/filament.json)
- [printing/A1_black_PLA_v10_4sets/machine.json](printing/A1_black_PLA_v10_4sets/machine.json)
- [printing/A1_black_PLA_v10_4sets/print_followup_state.json](printing/A1_black_PLA_v10_4sets/print_followup_state.json)
- [printing/A1_black_PLA_v10_4sets/process.json](printing/A1_black_PLA_v10_4sets/process.json)
- [printing/A1_black_PLA_v10_4sets/resolved_settings.json](printing/A1_black_PLA_v10_4sets/resolved_settings.json)
- [printing/A1_black_PLA_v10_4sets/result.json](printing/A1_black_PLA_v10_4sets/result.json)
- [printing/A1_black_green_blue_PLA_v07/command.json](printing/A1_black_green_blue_PLA_v07/command.json)
- [printing/A1_black_green_blue_PLA_v07/filament_black.json](printing/A1_black_green_blue_PLA_v07/filament_black.json)
- [printing/A1_black_green_blue_PLA_v07/filament_blue.json](printing/A1_black_green_blue_PLA_v07/filament_blue.json)
- [printing/A1_black_green_blue_PLA_v07/filament_green.json](printing/A1_black_green_blue_PLA_v07/filament_green.json)
- [printing/A1_black_green_blue_PLA_v07/machine.json](printing/A1_black_green_blue_PLA_v07/machine.json)
- [printing/A1_black_green_blue_PLA_v07/objects.json](printing/A1_black_green_blue_PLA_v07/objects.json)
- [printing/A1_black_green_blue_PLA_v07/print_followup_state.json](printing/A1_black_green_blue_PLA_v07/print_followup_state.json)
- [printing/A1_black_green_blue_PLA_v07/process.json](printing/A1_black_green_blue_PLA_v07/process.json)
- [printing/A1_black_green_blue_PLA_v07/resolved_settings.json](printing/A1_black_green_blue_PLA_v07/resolved_settings.json)
- [printing/A1_black_green_blue_PLA_v07/result.json](printing/A1_black_green_blue_PLA_v07/result.json)
- [printing/A1_black_green_blue_PLA_v07/打印跟进.md](printing/A1_black_green_blue_PLA_v07/%E6%89%93%E5%8D%B0%E8%B7%9F%E8%BF%9B.md)
- [printing/A1_blue_PLA_expanded_rear_2/README.md](printing/A1_blue_PLA_expanded_rear_2/README.md)
- [printing/A1_blue_PLA_expanded_rear_2/command.json](printing/A1_blue_PLA_expanded_rear_2/command.json)
- [printing/A1_blue_PLA_expanded_rear_2/filament.json](printing/A1_blue_PLA_expanded_rear_2/filament.json)
- [printing/A1_blue_PLA_expanded_rear_2/machine.json](printing/A1_blue_PLA_expanded_rear_2/machine.json)
- [printing/A1_blue_PLA_expanded_rear_2/print_followup_state.json](printing/A1_blue_PLA_expanded_rear_2/print_followup_state.json)
- [printing/A1_blue_PLA_expanded_rear_2/process.json](printing/A1_blue_PLA_expanded_rear_2/process.json)
- [printing/A1_blue_PLA_expanded_rear_2/resolved_settings.json](printing/A1_blue_PLA_expanded_rear_2/resolved_settings.json)
- [printing/A1_blue_PLA_expanded_rear_2/result.json](printing/A1_blue_PLA_expanded_rear_2/result.json)
- [reference/eda_backup/project2.json](reference/eda_backup/project2.json)
- [reference/gerber/FlyingProbeTesting.json](reference/gerber/FlyingProbeTesting.json)
- [reference/v05_feedback/README.md](reference/v05_feedback/README.md)
- [reference/v09_feedback/README.md](reference/v09_feedback/README.md)
- [reference/v10_gba/research.md](reference/v10_gba/research.md)
- [reports/acoustic-study/feasibility.json](reports/acoustic-study/feasibility.json)
- [reports/assembly_exports/v03/myMicrobyte-v03-装配调整.json](reports/assembly_exports/v03/myMicrobyte-v03-%E8%A3%85%E9%85%8D%E8%B0%83%E6%95%B4.json)
- [reports/battery_2026-10-20/sources.json](reports/battery_2026-10-20/sources.json)
- [reports/battery_2026-10-20/电池选购表.md](reports/battery_2026-10-20/%E7%94%B5%E6%B1%A0%E9%80%89%E8%B4%AD%E8%A1%A8.md)
- [reports/battery_expansion/space_check.json](reports/battery_expansion/space_check.json)
- [reports/battery_expansion/电池扩容与插头选购.md](reports/battery_expansion/%E7%94%B5%E6%B1%A0%E6%89%A9%E5%AE%B9%E4%B8%8E%E6%8F%92%E5%A4%B4%E9%80%89%E8%B4%AD.md)
- [reports/expanded_rear_2/model_validation.json](reports/expanded_rear_2/model_validation.json)
- [reports/expanded_rear_2/slice_validation.json](reports/expanded_rear_2/slice_validation.json)
- [reports/export_validation.json](reports/export_validation.json)
- [reports/fit_check.json](reports/fit_check.json)
- [reports/motion_and_coupons.json](reports/motion_and_coupons.json)
- [reports/print_project_validation.json](reports/print_project_validation.json)
- [reports/step_audit.json](reports/step_audit.json)
- [reports/v02/export_validation_v02.json](reports/v02/export_validation_v02.json)
- [reports/v02/fit_check_v02.json](reports/v02/fit_check_v02.json)
- [reports/v02/print_project_validation_v02.json](reports/v02/print_project_validation_v02.json)
- [reports/v03/assembly-guide-test-record.json](reports/v03/assembly-guide-test-record.json)
- [reports/v03/assembly-guide-validation.md](reports/v03/assembly-guide-validation.md)
- [reports/v03/completion_audit.md](reports/v03/completion_audit.md)
- [reports/v03/export_validation_v03.json](reports/v03/export_validation_v03.json)
- [reports/v03/fit_check_v03.json](reports/v03/fit_check_v03.json)
- [reports/v03/print_project_validation_v03.json](reports/v03/print_project_validation_v03.json)
- [reports/v04/completion_audit.json](reports/v04/completion_audit.json)
- [reports/v04/export_validation_v04.json](reports/v04/export_validation_v04.json)
- [reports/v04/fit_check_v04.json](reports/v04/fit_check_v04.json)
- [reports/v04/print_project_validation_v04.json](reports/v04/print_project_validation_v04.json)
- [reports/v05/completion_audit.json](reports/v05/completion_audit.json)
- [reports/v05/export_validation_v05.json](reports/v05/export_validation_v05.json)
- [reports/v05/fit_check_v05.json](reports/v05/fit_check_v05.json)
- [reports/v05/tolerance_validation_v05.json](reports/v05/tolerance_validation_v05.json)
- [reports/v06/completion_audit.json](reports/v06/completion_audit.json)
- [reports/v06/export_validation_v06.json](reports/v06/export_validation_v06.json)
- [reports/v06/fit_check_v06.json](reports/v06/fit_check_v06.json)
- [reports/v06/tolerance_validation_v06.json](reports/v06/tolerance_validation_v06.json)
- [reports/v07/acoustic_motion_v07.json](reports/v07/acoustic_motion_v07.json)
- [reports/v07/acoustic_toolpath_check.json](reports/v07/acoustic_toolpath_check.json)
- [reports/v07/completion_audit.json](reports/v07/completion_audit.json)
- [reports/v07/export_validation_v07.json](reports/v07/export_validation_v07.json)
- [reports/v07/filament_inventory.json](reports/v07/filament_inventory.json)
- [reports/v07/fit_check_v07.json](reports/v07/fit_check_v07.json)
- [reports/v07/print_project_validation_v07.json](reports/v07/print_project_validation_v07.json)
- [reports/v08/acoustic_motion_v08.json](reports/v08/acoustic_motion_v08.json)
- [reports/v08/export_validation_v08.json](reports/v08/export_validation_v08.json)
- [reports/v08/fit_check_v08.json](reports/v08/fit_check_v08.json)
- [reports/v08/preview-server.json](reports/v08/preview-server.json)
- [reports/v08/review_status.json](reports/v08/review_status.json)
- [reports/v08/slider_install_validation.json](reports/v08/slider_install_validation.json)
- [reports/v08_trials/print_project_validation.json](reports/v08_trials/print_project_validation.json)
- [reports/v08_trials/trial_geometry_validation.json](reports/v08_trials/trial_geometry_validation.json)
- [reports/v09/export_validation_v09.json](reports/v09/export_validation_v09.json)
- [reports/v09/fit_check_v09.json](reports/v09/fit_check_v09.json)
- [reports/v09/preview-server.json](reports/v09/preview-server.json)
- [reports/v09/review_status.json](reports/v09/review_status.json)
- [reports/v10/export_validation_v10.json](reports/v10/export_validation_v10.json)
- [reports/v10/fit_check_v10.json](reports/v10/fit_check_v10.json)
- [reports/v10/preview-server.json](reports/v10/preview-server.json)
- [reports/v10/print_project_validation.json](reports/v10/print_project_validation.json)
- [reports/v10/review_status.json](reports/v10/review_status.json)
- [reports/v10_4sets/print_project_validation.json](reports/v10_4sets/print_project_validation.json)
