88431844/myMicroByte/output/README_试装说明.md

# myMicrobyte 外壳 v0.1 — FreeCAD 试装版

此版本用于核对装配和小批试打印。实物电池、屏幕安装高度、扬声器及线材插头尺寸尚未提供，相关占位和接口开口仍须校准。

## 文件

- `myMicrobyte_enclosure_v01.FCStd`：FreeCAD 1.1.4 原生模型，含尺寸参数表、Part 原生基本体/布尔建模树、前后壳、九个独立按键帽和 PCB 参考。
- `myMicrobyte_enclosure_v01.step`：11 个可打印零件的装配 STEP，不含 PCB、屏幕、电池占位。
- `RearShell_print.stl`：后壳，已按背面朝下、内腔朝上放置。
- `FrontShell_print.stl`：前壳，已按外观面朝下、内腔朝上放置。
- `Cap_*_print.stl`：九个按键帽，已按手指接触面朝下放置，凸缘悬空部分需少量支撑。

## 已确定的机械基准

| 项目 | 尺寸（mm） |
|---|---:|
| PCB 外形 | 80 × 40，R3 |
| PCB 板厚 | 1.60005（EDA 标称，需考虑实物公差） |
| PCB 固定孔 | 四个 Ø2.5 非金属化孔 |
| 固定孔中心 | 距相邻板边各 2.54 |
| 壳体外形 | 85 × 45 × 24.5 |
| 壳体外圆角 | R5.5 |
| 侧壁 / 后底 / 前面板 | 2 / 2 / 1.6 |
| PCB 单边间隙 | 0.5 |
| 两壳分缝 | 0.2 |
| 定位止口单边间隙 | 0.2 |
| 屏幕窗口 | 28.52 × 28.52 |
| 按键帽直径 / 导孔直径 | 5.4 / 5.9 |
| 按键防脱凸缘直径 | 6.8 |
| 螺柱直径 | 6 |
| 后壳螺丝通孔 / 前壳预孔 | Ø2.3 / Ø1.7 |

屏幕窗口按 PCB 封装标注的 27.72 × 27.72 显示区域增加每边 0.4 mm。板的按键位于底面，外壳正视坐标使用 X=40−PCB_X，Y=PCB_Y−20，已正确翻到物理正面。按键名称取自当前 STEP 中的设计标注。

## 装配堆叠与假定

以后壳最底面为 Z=0：底板 Z0～2；PCB 元件面 Z15，按键/屏幕面 Z16.60005；前面板内侧 Z22.9，外侧 Z24.5；按键最高 Z25.1。

电池暂按 **50 × 30 × 6 mm**，放在 PCB 下方 Z3～9。它只是占位，未设置依赖未知电池型号的固定卡扣。实际电池须用合适软垫/可移除胶固定，避免接触焊点；导线和插头必须计入尺寸。

LCD 暂按 PCB 封装外形 **31.52 × 33.72 mm**，从按键侧 PCB 表面起 **5 mm** 高，占位不是精确屏幕 STEP。可用的屏幕堆叠高度约 6.3 mm；当前玻璃面到前面板内侧还有 1.3 mm 的假定距离，需要按实际焊接高度调整。

九个按键帽采用推杆、防脱凸缘和圆形导向柱。推杆与绑定开关模型约留 0.16～0.35 mm 间隙；实际开关高度、行程及打印误差需试装校准。优先试打印一个按键帽与局部导孔。没有增加依赖未知屏幕高度的压紧卡扣。

USB 开口 12.4 × 6.5 mm；TF 侧开口 17.4 × 5.5 mm；右侧拨杆开口沿侧壁 10.2 × 6 mm。它们根据封装及可信模型定位，但仍须试插实际 USB 线、TF 卡并确认拨杆可触及。后壳有四条声音出孔；扬声器型号未知，尚无专用固定座。LED 导光和防尘屏幕盖片尚未设计。

固定方案暂定从后壳拧入四颗 **M2 塑料用自攻螺钉，约 20 mm 长**，穿过 PCB 孔并进入前壳预孔。需按实际头部尺寸、螺纹和打印材料选型；Ø1.7 预孔不是标准金属 M2 内螺纹，也未使用热熔螺母。拧紧程度以固定板和闭合壳体为准，避免使 PCB 弯曲。

装配顺序：将按键帽从前壳内部穿入；安装焊好屏幕的 PCB；安放电池、扬声器和导线；对齐止口；从后面拧紧四个螺钉。先不装电池检查所有按键自由回弹，再检查线材是否被夹住。

## 模型来源与验证范围

参考当前已登录立创 EDA 项目的源文件和 2026-10-15 导出的 STEP，并使用现有打样 Gerber 核对板外形与钻孔。原始参考保存在工作区 `reference/` 中。

STEP 的多项绑定模型存在异常单位/缩放（包括 USB、连接器、多项电阻、LED 和部分 IC）；已从装配参考中剔除，完整名单见 `reports/fit_check.json`。保留 PCB、九个开关、ESP32 模块、TF 卡座、拨杆及其他尺寸可信元件；USB 使用保守长方体占位。没有把异常巨大模型缩小后当作精确实物模型。

前后壳及九个帽均为有效的单一实体。与保留 PCB 模型、假定 LCD/电池/USB 占位以及两壳之间，未检测到正体积干涉。该结果不覆盖被剔除模型的实物、插头外壳、焊锡、导线、按键按下状态和电池实际尺寸。

原生文件重新打开并重计算通过，11 个 STL 均检查为闭合网格；改变壁厚参数后的重计算也通过。详见 `reports/export_validation.json`。所有长度按 mm 解释；参数表 B 列填写不带单位的数值。

## 打印与修改

建议先用 PLA/PETG 做试装，0.2 mm 层高、至少四圈外壁；前后壳使用上述已摆放 STL，接口桥接位置视打印机情况加支撑。按键帽最好用更小层高并启用凸缘支撑。切片后检查螺丝孔、止口和窗口边缘，不要用统一缩放补偿某个局部间隙。

在 FreeCAD 双击“尺寸参数（mm） / Parameters”编辑 B 列，重计算后再导出 STL。壁厚、板边间隙、帽直径和导孔间隙有原生表达式关联。改变整个装配厚度时，需要同时协调 PCB 高度、前面板内侧高度和三个按键 Z 参数；参考 PCB 高度与侧面接口高度随 PCB 基准更新。显示窗口和 LCD 占位单独调整。已有 STEP/STL 不会在编辑原生文件后自动更新。

下一版必须提供：电池长宽厚（含保护板/出线）、PCB 按键面到屏幕玻璃面的高度、扬声器长宽厚或直径厚度，并确认是否接受独立圆形按键帽。

## 小型试打印件与按键运动检查

新增 `myMicrobyte_fit_coupons.FCStd`、对应 STEP 和四个 `Fit_*.stl`。它们从当前外壳的实际几何中截取，不改变完整外壳：`Fit_ButtonGuide.stl` 是 10 × 10 mm 的前面板导孔试片，可搭配已有 `Cap_A_print.stl` 检查滑动及防脱；`Fit_ScrewPilot.stl` 是实际 Ø1.7 预孔螺柱；`Fit_RearTongue.stl` 和 `Fit_FrontReceiver.stl` 是相配的 15 mm 长直线止口片。止口片的两个长外侧面应对齐后试合，按设计保留 0.2 mm 分缝。试片只能验证打印尺寸与手感，不能替代完整板的实物试装。独立螺柱用于验证孔径，不能用于测试整壳螺柱连接强度。

九个按键帽在向下 0～0.8 mm 的连续运动扫掠范围内，与前后壳、相邻静止帽、LCD 占位以及保留的其他固定 PCB 元件模型均没有正体积干涉。此检查排除对应的可动开关；不能证明实际触发行程、触发力或回弹可靠性。

电池占位顶面 Z9，最低覆盖其区域的参考占位底面 Z11.4，模型垂直间隙为 2.4 mm。按同一 50 × 30 mm 位置且保留 0.5 mm 顶部余量，电池厚度上限约 7.9 mm；该上限只覆盖保留模型及假定占位，未计入被剔除的实物、焊点和导线。完整报告见 `reports/motion_and_coupons.json`。
