88431844/myMicroByte/output/v10/README_v10.md

# myMicrobyte v0.10 / GBA 式电源拨帽

使用本机 FreeCAD 建模。2026-10-18/19。用户审阅后已授权打印；2026-10-19 已发送到拓竹 A1，任务 myMicrobyte_v10_black。前盖、后盖、拨帽同盘，A4 黑色 PLA，0.16 mm 层高，预计耗材 23.18 g。设备已接收，目前进入动态流量校准，尚未确认首层或打印完成。打印工程与实际发送的切片文件见 ../../printing/A1_black_PLA_v10/。

## 查看与文件

- 交互装配页：../assembly-guide-v10/index.html；本地服务地址见 ../../reports/v10/preview-server.json。
- v10_gba_slider_review.png：拨帽内外侧、前盖落下、合盖近景。
- v10_assembly_review.png：整机合拢与爆炸图。
- ../../reports/v10/slider_guide_section.png：实际CAD剖面与间隙。
- myMicrobyte_enclosure_v10.FCStd：可编辑原生布尔树及尺寸记录。
- myMicrobyte_enclosure_v10.step：三件打印实体。
- FrontShell_print.stl、RearShell_print.stl、PowerSlider_print.stl：按打印方向导出的候选网格。

## 结构

借鉴用户GBA照片及iFixit步骤8所示的独立拨帽/开关摆臂装配关系，按当前MSK-12C02与PCB空间重新设计。不是原厂GBA零件的照尺寸复制。

取消v0.9独立压条及其短插脚/插槽，改为后盖敞口导轨与前盖一体限位面。前后盖均需配套使用v0.10；新拨帽不能视为与旧壳无条件兼容。

- 内挡边长14.0、高4.2、厚1.6 mm；此前长10.4、厚1.3 mm。
- 中央通高叉槽宽1.8 mm；开关图纸拨杆截面1.3×1.1 mm。叉口后方连接根部厚1.6 mm，颈部高3.0 mm。没有需要掰开的细长弹片。
- 前盖一体限位面厚1.7 mm，随合盖落下，限制挡边上浮。后盖下导轨顶端Z7.05，避开开关固定本体。
- 导轨左右各0.20 mm、顶部和底部各0.20 mm名义间隙。总间隙0.40 mm/轴，需以PLA实际试装验证，不宣称零晃动。
- 外侧导轨局部向外加厚0.55 mm，留下至少约1.0 mm外挡墙；壳体最大宽度85.55 mm。拨帽拇指面另突出壳体。
- 机械预留滑动范围−0.55～+3.05 mm，共3.6 mm。两端为实体止挡；这不是已确认的开关电气行程。
- 外侧五条圆角防滑纹，纹路朝上打印。内挡边着底，通槽在前几层形成两脚，颈部连接；正式切片需看小桥接和首层粘附。

装配：后盖平放 → 喇叭、电池、PCB就位 → 拨帽纹路朝外、从上方放下、叉口套住白拨杆 → 合前盖 → 交叉轻拧螺丝。合盖前拨帽仍可取出，应保持平放；合盖后由壳体限制脱出。无需胶、无需剪断横杠、无需额外压条。

本版保留v0.9前盖F3按键孔、29.72 mm显示窗、整圈玻璃限位、约1.05 mm名义玻璃上方留空，以及平整后盖、喇叭自带胶椭圆座、开放矩形围壁。电池框仍为52×30 mm，建议成品包络≤51×29×3.3 mm。前盖正面朝上打印。

## 验证结果与局限

三个打印件均有效单实体。STL封闭、无非流形边/自交，网格体积误差小于0.01%。原生文档重开重算后生成真实网格预览。

检查PCB及电子元件、LCD公差包络、喇叭、电池、接口和壳体间的交叠；37个滑动位置另叠加X/Z各±0.15 mm偏移，共333个间隙姿态；49个拨帽垂直装入位置、33个前盖合拢位置与33个喇叭装入位置。全行程检查向上/下0.5 mm、内外0.6 mm的阻挡，以及两端超程0.3 mm止挡，均有实体阻挡重叠。刚体几何检查无未解释碰撞。详见fit_check_v10.json与export_validation_v10.json。

这些是几何检查，不是PLA强度、疲劳、摩擦或屏幕受压实测。实际开关两档位置、打印毛边/收缩、装配手感仍需验证；不应靠外壳强行推动超过电气开关自身的端点。屏幕原胶层厚度和排线仍按此前假定。恢复平整后盖仍可能在桌面上堵声；开放围壁不是密闭调谐音腔。

交互页提供“拨帽单件”“拨帽装入”“合盖限位”“导轨剖视”；行程条带动白拨杆作示意，不代表实测电气开关状态。局部视图裁去远处壳体，未改动原生模型。网页偏移/备注只用于沟通，不会重建CAD或更新打印件。

## 来源与生成

参考：[iFixit GBA按钮更换步骤8](https://zh.ifixit.com/Guide/Nintendo+Game+Boy+Advance+%E6%8C%89%E9%92%AE%E6%9B%B4%E6%8D%A2/2011#s401485)，以及用户两张清晰照片。来源证据与推断范围记录在 ../../reference/v10_gba/research.md。

脚本：freecad/update_enclosure_v10.py、save_v10_view_metadata.py、export_v10_preview.py、draw_v10_slider_section.py、make_v10_review_images.py，以及output/assembly-guide-v10/build.py。脚本为几何生成来源；表格是尺寸记录，网页不是CAD参数编辑器。
