88431844/myMicroByte/reference/v10_gba/research.md

# GBA 电源拨帽参考

本轮用户提供两张拆机照片，已保存在本目录。2026-10-18/19 浏览核实 iFixit《Nintendo Game Boy Advance 按钮更换》步骤8：
https://zh.ifixit.com/Guide/Nintendo+Game+Boy+Advance+%E6%8C%89%E9%92%AE%E6%9B%B4%E6%8D%A2/2011#s401485

该步骤明确说明可拆下电源开关盖板，重新装配时应正确安装在开关机构摆臂上。用户照片可见独立的长内挡边、中央叉口以及装在板边开关处的状态。网站图片当时未成功加载，机械外形判断主要基于用户清晰照片；文字用于确认拆装关系。

采用的设计原则：外部拇指面传力至中央叉口；内侧长挡边在外壳导轨中滑动；前后壳合拢后限制拨帽脱出。这个结构分析及FDM尺寸是本项目的工程设计，不是任天堂原厂尺寸。未将3D打印PLA视为原厂注塑材料。

MSK-12C02尺寸继续使用用户之前给出的图纸 reference/v03_feedback/MSK12C02_dimensions.png，未另行搜索。图纸拨杆截面1.3×1.1 mm、伸出约1.5 mm；本版通高叉槽1.8 mm。3.6 mm是外壳的机械预留范围，不是从该图纸确证的开关电气行程。
