88431844/myMicroByte/reference/v09_feedback/README.md

# 本轮实物参考

按照片内容对应用户图号：

1. weak_slider_tabs.png：红箭头指出拨帽两条细弹片。
2. IMG_8478.jpg：对比两件后盖外表面。
3. IMG_8476.jpg：喜欢的凸框前盖、按键孔和正面朝上打印效果（对应F3）。
4. IMG_8480.jpg：期望恢复的平整后盖。
5. IMG_8477.jpg：前盖内侧屏幕定位框参考。
6. IMG_8479.jpg：喇叭座、矩形围壁和需取消的三个爪。

HEIC原件位于用户Downloads，本目录JPEG仅用于查看，不修改原件。
