88431844/myMicroByte/reference/v05_feedback/README.md

# v0.5 实物反馈

照片按本次上传附件顺序保留。用户正文的图片编号与附件呈现顺序存在差异，按内容对照：

1. attachment_01：装 PCB 后 Type-C 一侧接缝。
2. attachment_02：TF 开口暴露 PCB 边缘。
3. attachment_03：屏幕下陷、按钮较平。
4. attachment_04：前盖内侧屏幕定位框、热熔螺母、十字键中心开口。
5. attachment_05：后盖橡皮泥试装空间与电池框。
6. attachment_06：拨帽、后盖横杠和装入路径。
7. attachment_07：装 PCB 后合缝与按钮高度。
8. attachment_08：空壳可正常合缝。
9. attachment_09：正面十字键细节。

本轮要求：先交付可交互的 3D 爆炸预览，再由用户确认打印。不沿用旧版自动打印授权。

补充：用户确认 RUN 灯光无法透出，要求去掉前盖左下角观察孔。v0.5 删除该孔和内侧漏斗。
