88431844/myMicroByte/output/v02/README_v02.md

# myMicrobyte 外壳 v0.2 — 屏幕、1510 喇叭与电池框

此版按用户提供的屏幕和扬声器图纸更新。电池按可用空间选型，放在后壳**内侧**、PCB 下方，用胶粘在平整底面上；四周低矮矩形框用于定位。外壳外形仍为 85×45×24.5 mm。v0.1 文件保留，试打印应使用本目录或标有 v02 的 3MF。

## 电池选型与定位框

推荐电池**成品总外形不超过 56×36×6 mm**，包含保护板、包边及标签；不代表某种标称电芯型号，也不能据此确定容量。长边沿 PCB 的 80 mm 方向。电池中心在装配坐标 X=-4，Y=0，底面为 Z=2.3（后壳底板2 mm，加0.3 mm胶层）。

定位框内净空为 **57×37 mm**，单边余量0.5 mm，框壁1.2 mm，高2.4 mm；外形59.4×39.4 mm。它只约束平面位置，不压紧电池，不设置上方扣钩，使用可移除、适合电池包材的薄胶片粘接。

在所比较的平面布局中，将喇叭长边沿 PCB 短边布置在侧边，能保留约56×36 mm的连续电池轮廓。若喇叭直接放在 TF 正下方，矩形电池面积明显减小。这里的“可用空间”已扣除四个螺柱、壳壁、定位框及喇叭座间隙，并非将80×40 mm板面积直接作为电池尺寸。

当前6 mm电池到ESP32参考模型约3.38 mm、到USB占位约3.10 mm、到喇叭端子/插头保守包络约1.20 mm。**6.5 mm只是当前包络和0.7 mm余量下的条件性厚度上限，建议按6 mm选型**。端子与实物插头厚度没有可靠STEP，实际选定电池后仍须核对；电池出线没有作为选型边界，也没有锁定出线方向。

## 屏幕

按图1的31.52×33.72 mm LCM，厚1.9±0.1 mm，胶层标称0.1 mm，PCB面到玻璃标称2.0 mm。验证时额外计入0.1 mm安装叠高，使用2.2 mm最坏包络；窗口内圈底面Z=19.20005，距该最坏玻璃面0.4 mm，距标称面0.6 mm。

窗口为28.52×28.52 mm，保留原PCB对显示有效区域的定位。新增向内延伸的遮光内圈。现有约5 mm高按键开关决定了前壳高度，因此屏幕较深；此次没有通过整体降低前壳造成按键挤压，也不使用窗口压住玻璃。

## 喇叭与端子

采用图2的 **1510，15×10×3.5 mm，8Ω/1W**；图下方“1810”是下一项产品标题，没有按18×10 mm建模。平面尺寸正公差0.2 mm、厚度正公差0.3 mm计入包络。

喇叭中心X=33、Y=4.5，长边沿Y，位于TF一侧的侧边区域；振膜朝向后壳外侧。后壳新增五条出声槽和胶粘支承环。支承环只承接喇叭边缘，中央13×8 mm胶囊形开口避开振膜；座内净空15.8×10.8 mm，定位框壁1.2 mm，框高3.2 mm。预留0.3 mm薄泡棉胶层，不能让胶覆盖振膜。

喇叭出线朝TF/喇叭端子方向，设置出线缺口；另一端对图纸未标尺寸的小凸耳设置避让槽，按3×2.5×1 mm保守包络检查，需要用实物确认。图示50±3 mm喇叭线的平面路线加端部余量估算约42 mm；实际插头、压接和上下弯折仍需试装。

从当前PCB源文件核对：BAT原点为X=35.428、Y=8.702，SPEAKER为X=-11.689、Y=15.433；TF原点X≈4.851、Y≈10.261；Type-C原点X≈0、Y≈-15.925。上述XY是装配坐标（从后壳内侧看），不是元件外壳中心。

BAT和SPEAKER的封装XY用于建立保守端子/插头包络，向PCB背面预留5.5 mm深度，未使用异常缩放STEP冒充精确模型。BAT插接方向附近的后壳螺柱上部增加局部避让，孔周剩余壁需试打印确认。喇叭最坏包络与BAT包络之间约2.9 mm，电池定位框与喇叭座之间约0.7 mm。

## 文件与验证

- `myMicrobyte_enclosure_v02.FCStd`：原生参数表、布尔特征树、11个可打印零件、PCB及尺寸参考；可编辑。
- `myMicrobyte_enclosure_v02.step`：前后壳及九个帽的装配STEP。
- `RearShell_print.stl`：底面向下、内腔向上。
- `FrontShell_print.stl`：外观面向下、内腔与屏幕内圈向上。
- `Cap_*_print.stl`：手指面向下，凸缘下需支撑。
- 工作区 `printing/A1_black_PLA_v02/myMicrobyte_v02_A1_black_PLA_sliced.3mf`：A1、0.4 mm、黑色PLA的试打印项目。
- 工作区 `reports/v02/`：装配图、内侧布局图、带PCB投影的说明图与检查报告。

11件均为有效单一实体，导出的STL为闭合网格。前后壳、保留的PCB模型、屏幕公差包络、喇叭公差包络、电池包络和端子占位之间没有正体积干涉；九帽0～0.8 mm连续运动扫掠检查通过，排除对应可变形开关，不能替代实际触发行程和回弹试验。

固定方式沿用v0.1的四颗M2塑料自攻螺钉方案，约20 mm长度须按实物螺钉选择。先空壳试装PCB和按键，再装喇叭、电池及线材，检查接头可插拔、按键回弹和PCB没有弯曲。当前没有启动打印机。
