88431844/myMicroByte/output/v03/README_v03.md

# myMicrobyte v0.3 试装版

根据 v0.2 实物试装照片修改，使用本机 FreeCAD 建模。最终打印件为前盖、后盖、九个弧面按键帽、一个侧边电源拨帽，共 12 件。

## 本版尺寸

- 主体 85 × 45 × 21.9 mm；原版 24.5 mm，减薄 2.6 mm。PCB 背面高度由 15 降至 13 mm；后壳底板由 2 降至 1.6 mm。
- 电池选用用户指定的 503550，标称 50 × 35 × 5 mm。按用户要求保留原定位框内净空 57 × 37 mm，给保护板和包边留空间；0.3 mm 胶层。选购成品外形不超过 56 × 36 × 5 mm；商家的实际成品尺寸尚未提供。
- 电池到 ESP32 参考模型约 2.78 mm；到 USB 保守包络 2.5 mm；到喇叭端子及插头保守包络最小 0.6 mm。这些端子的真实插头尺寸仍须实物核对。
- 屏幕玻璃标称距 PCB 正面 2.0 mm。中央面板下沉，窗口边缘高出玻璃 1.6 mm；最坏玻璃包络到面板底仍保留 0.4 mm。左右按键区保持较高，避免压住约 5 mm 高轻触开关。
- 弧面帽高出按键面板 1.8 mm；中央球冠高 0.8 mm。每个帽增加两个长条定位耳，前盖内有匹配导槽。帽触头按每个参考开关的高度单独定位，初始间隙 0.03 mm；装上 PCB 后限制脱出，定位耳不依赖 PLA 弹性卡扣。
- TF 窄口 11.6 × 1.9 mm，按 11 mm 宽 microSD 卡留横向余量；外侧有 0.8 mm 深外扩倒角。开口只切后壳及后壳止口，前盖提供上边缘。
- Type-C 窄口 10.4 × 4.6 mm，比原 9.4 × 3.6 mm 保守金属接口包络总尺寸大约 1 mm；外扩倒角位于后盖，前盖不再留 Type-C 缺口。电缆塑料外壳外形没有实测。

## 电源拨帽

独立 GB 风格拨帽，外侧防滑纹、内部捕获凸缘及叉槽。用户的 MSK-12C02 图给出拨杆 1.3 × 1.1 mm、伸出 1.5 mm；本版叉槽为 1.8 × 1.5 mm。由前后盖合拢后捕获，沿 PCB 短边方向滑动。

图纸没有明确标注电气开关的总行程，导轨提供 2.3 mm 可用运动范围；扣除 0.5 mm 叉槽总间隙可容纳约 1.8 mm 拨杆行程。需要在空壳试装时确认两个电气档位都能到位，不能仅以预览中的运动认定已验证电气切换。参考 STEP 的开关本体及白色拨杆外形已用于检查；其尺寸与用户图有少量差别，按图尺寸加装配余量处理。

## 螺丝与热熔螺母

- 使用四颗用户已有的 **M2×5** 机牙螺丝，头径约 4 mm、头厚约 0.8 mm。
- 前盖使用四个 **M2×2×3** 热熔螺母：M2 内螺纹、长度 2 mm、外径 3 mm、螺距 0.4 mm。
- 前盖热熔预孔直径 2.8 mm、深 2.15 mm，入口有导入面，并留有螺丝尖端余量。螺母从 PCB 侧装入，先热熔再装 PCB。
- 后盖四个柱内有直径 4.6 mm 的深沉孔，孔底距 PCB 背面 1.4 mm。5 mm 螺丝经过 1.4 mm 承力台阶和约 1.6 mm PCB，剩约 2 mm 与螺母啮合。
- M2×10 不用于本版相同沉孔，避免螺丝过长顶到前盖。

## 打印与装配

打印项目：`printing/A1_black_PLA_v03/myMicrobyte_v03_A1_black_PLA_sliced.3mf`。A1、0.4 mm 标准喷嘴、黑色 Generic PLA、纹理 PEI、0.2 mm 层高、4 圈墙、20% 螺旋体填充、普通自动支撑（仅打印板）、自动 4 mm 裙边。12 件排在同一盘，CLI 估计模型打印约 65 分钟、26.92 g，设备校准和准备会增加时间。

后盖底面向下，前盖外侧向下；中央下沉屏幕区有支撑。弧面按键手指面朝上，使弧面不接触支撑，定位耳下有必要支撑。拨帽外侧朝下，仔细清除叉槽内支撑及毛边。

装配顺序：清理支撑和孔边 → 热熔四个螺母 → 帽从前盖内侧装入导槽 → 对准 PCB 检查九键行程 → 拨帽叉槽对准白色拨杆 → 装喇叭和电池 → 合盖 → 四颗 M2×5 均匀拧紧。不要用螺丝强拉未对齐的前后盖。

## 验证与文件

FreeCAD 原生文件重新打开、重算通过；12 个打印实体均有效且各含一个实体；STL 闭合，体积与 CAD 误差低于 1%。前后壳、PCB 保留模型、LCD 最坏包络、电池、喇叭和端子包络未发现正体积干涉。九帽连续 0～0.6 mm 保守扫掠及拨帽连续 0～2.3 mm 保守扫掠通过；对应可变形开关单独排除，固定开关本体另行检查。

热熔螺母齿与预孔的过盈是设计需要，不按普通干涉处理。没有将缺少可靠模型的端子、线材、USB 电缆塑壳声称为精确几何。预览是实际 CAD 网格，网页预览为显示效率进行粗化；打印 STL 保持更细精度。

- `myMicrobyte_enclosure_v03.FCStd`：FreeCAD 源文件、参数表、可编辑零件与布尔树、PCB 参考。
- `myMicrobyte_enclosure_v03.step`：12 个打印件的装配 STEP。
- `*_print.stl`：已定向打印件。
- `freecad/update_enclosure_v03.py`：建模脚本（重建所需的 v0.2 原生输入及旧版视图模板随包保留）。普通尺寸主要由参数表控制；屋顶轮廓、倒角放样、球冠等构造由脚本生成，改动关联尺寸后应运行脚本重建。
- `reports/v03/`：装配图、分解图、原生/网格/切片检查报告。

本版已于 2026-10-16 用本机 Bambu Studio 和拓竹 A1 的 A4 黑色 PLA 完成单盘试打印。先展示交互预览并等待超过一小时，再按用户授权发送；发送前核实板面清空和设备空闲。设备显示 v0.3 作业 100% 完成、122/122 层，GUI 估计耗材 26.90 g；成品照片与完成状态保存在 `reports/v03/A1_v03_completed.png`。自动跟进已暂停。打印完成不代表已做实物装配；清理支撑后按上面的装配顺序检查。
