88431844/myMicroByte/output/v04/README_v04.md

# myMicrobyte v0.4 薄壳试装版

使用本机 FreeCAD 原生几何内核生成，依据 v0.3 实物反馈修订。主体 85 × 45 × 14.9 mm；静音开关高出前面板约 0.7 mm。相较 v0.3 主体减少 7 mm，其中 PCB 背面支承高度从 13 降到 9 mm。

- 前后盖外缘 R1.8 圆角；九个打印按键帽取消，孔内台阶让开原装静音开关。
- TFT 显示区 27.72 × 27.72 mm，窗口 29.72 × 29.72 mm；玻璃轮廓 31.52 × 33.72 mm，内侧四角限位净空 32.22 × 34.42 mm。最坏玻璃与前盖间隙约 0.20 mm。
- TF 内通道 14.2 × 3.8 mm，Type-C 10.4 × 4.6 mm，均有向外扩口。
- PCB CAD 厚度 1.60005 mm；支柱间预留 1.75 mm，设计接缝 0.1 mm。热熔螺母 M2×2×3、螺丝 M2×5。
- 后盖电池框净空 52 × 27 mm。电池尚未选定，图中仅为 50 × 25 × 3 mm 占位。选型需含包边及保护板，建议成品不超过 51 × 26 × 3.3 mm；胶层预留 0.3 mm。最坏电池与 ESP32 约 0.68 mm、与 Type-C 约 0.40 mm 间隙。
- 喇叭 15 × 10 × 3.5 mm，发声面朝后。电池端子及插头仍按保守 5.5 mm 深度检查，后盖对应螺柱有局部让位。
- 红色充电 LED 后孔 Ø2 mm；RUN 前孔 Ø2 mm 对准背面 LED，但铜层/FR4 可能遮光，实际透光需试装。本设计不要求钻 PCB。

`myMicrobyte_enclosure_v04.FCStd` 为原生 FreeCAD 文档；保留构造布尔树。Parameters 表记录生成参数，批量改尺寸请修改 `freecad/update_enclosure_v04.py` 的 VALUES 后重建，表格不是自动驱动全部特征。

检查见 `reports/v04/fit_check_v04.json`、`export_validation_v04.json`。三件打印网格均封闭、无非流形边或自相交，并贴齐 Z=0。保留元件、保守端子包络、TF 插入路径、拨帽连续行程检查通过；线束弯曲、热熔孔打印公差和 LED 透光需实物试装。

拓竹 A1：0.4 mm 喷嘴、纹理 PEI、黑色 PLA、0.2 mm 层高、4 圈墙、20% gyroid，支撑仅打印平台，自动 4 mm brim；三件同盘。已切片项目在 `printing/A1_black_PLA_v04`。

交互预览：`output/assembly-guide-v04/index.html`（独立离线页面）；页面偏移用于记录调整意图，不会直接改动 CAD 或打印文件。
