88431844/myMicroByte/output/v06/README_v06.md

# myMicrobyte v0.6 音腔与配色预览

使用本机 FreeCAD 内核建模。基于 v0.5 新增喇叭后腔，旧版保留。本版仅供审阅，尚未切片或发送打印。

## 音腔结构

- 后盖一体围壁，外轮廓 13.2 × 20.1 mm，墙厚 1 mm，墙顶 Z=5.9 mm。
- 独立可拆腔盖厚 0.8 mm，连底面定位凸台总厚 1.6 mm；外表面朝打印平台，凸台朝上。
- 两处非打印软密封圈：喇叭发声面边缘与连续承台之间、围壁与腔盖之间，各按压合后 0.3 mm 建模。腔盖用双面密封圈固定，可拆换。
- 靠 USB 一侧留 2.2 mm 宽上开口走线槽。导线放好后需以可移除软密封胶封严。这个槽不是倒相孔。
- 喇叭比 v0.5 向内移 1.6 mm、向 USB 侧移 0.5 mm。名义尺寸 15×10×3.5 mm，最坏包络采用 10.2×15.2×3.9 mm。
- 净后腔体积约 0.412 cm³，按外部包络减去喇叭、凸耳、承台、定位凸台估算，未包含未知的喇叭内部气腔和实际线束。
- 五条出声孔总开口约 41.6 mm²，孔间筋约 1 mm。

这是可进行有盖/无盖对比的结构样件，不是声学仿真结果。尚无 Fs/Vas/Qts 或实测声压，不能保证更响；小密闭腔也可能减弱低频。两处边缘和线槽需要密封，胶不得进入振膜或喇叭透气孔。

## 厚度与装配

整机主体仍为 85 × 45 × 14.4 mm。电池框净空 52 × 30 mm，名义占位 50 × 28 × 3 mm，成品含保护板、包边建议不超过 51 × 29 × 3.3 mm。音腔不扩大电池选型包络。

按顺序贴前密封圈、放喇叭、安排走线、贴腔盖密封圈并压盖、封导线空隙，再装电池、PCB、拨帽、前盖和螺丝。腔盖需要在 PCB 放入之前安装。

已检查四件打印实体及 STL 的闭合、非流形、自交、体积和零平面；静态干涉、喇叭与腔盖装入路径、拨帽运动与装入、TF 进卡路径均通过当前包络检查。腔盖到开关约 0.316 mm、到喇叭最大包络 0.20 mm，音腔到电池端子约 0.552 mm、到电池框 0.60 mm。实际打印毛边、线径与喇叭焊点仍需试装。

v0.5 的短屏幕限位框、PCB 公差、裸静音开关、TF 唇边、拨帽纹路和前盖 RUN 孔封闭状态均保留。详细装配假设见 `../../reports/v06/fit_check_v06.json`。

## 交互页与配色

打开 `../assembly-guide-v06/index.html`，或运行本地服务后访问 http://127.0.0.1:8769/ 。

- “音腔爆炸图”：显示局部五层关系。绿色密封圈为非打印耗材。
- “整机爆炸图”与“合拢模型”：对照整体结构和配色。
- 五套配色：黑色、经典 GB 灰紫、奶油白×酒红、薄荷绿×墨绿、橙色×石墨黑。
- 可独立更改前盖、后盖、拨帽、音腔盖颜色，导出调整 JSON 保存。页面颜色不修改 FreeCAD/STL，也不代表耗材的精确色差或光泽。
- 零件平移只用于表达调整意图，不重建 CAD 或执行干涉检查。
- 多色零件可以换料分批打印；现有单卷黑色 PLA 可做全黑版，不需要多色系统。

## 文件

- `myMicrobyte_enclosure_v06.FCStd`：原生 FreeCAD 装配、布尔构造树与尺寸记录表。
- `myMicrobyte_enclosure_v06.step`：四件打印实体，装配坐标。
- `RearShell_print.stl`、`FrontShell_print.stl`、`PowerSlider_print.stl`、`AcousticLid_print.stl`：打印姿态，Z 最低处已归零。
- `../../reports/v06/color_comparison.png`：五套配色对照。
- `../../freecad/update_enclosure_v06.py`：重建脚本；修改 VALUES 后运行。记录表未表达式驱动所有特征。

未执行打印。需要先审阅本版音腔结构及配色效果。
