88431844/myMicroByte/output/v07/README_v07.md

# myMicrobyte v0.7：现有耗材配色与无胶音腔

本机 FreeCAD 建模，旧版 v0.6 保留。本版已于 2026-10-17 经用户授权切片并发送到拓竹 A1，设备已进入换料准备阶段。用户要求音腔不用胶，已取消两处软密封圈和粘接固定。

## 库存与推荐

依据用户 2026-10-17 的文字库存和两张照片：备用红、黄、银 PLA 各一卷；当前槽 1 蓝 PLA、槽 2 绿 PLA、槽 3 透明 PETG、槽 4 黑 PLA；灰、白、黑 PETG 各两卷，透明 PETG 三卷。库存数量不根据照片重复加算，剩余重量未知。

所有预设内的四件打印件使用同一种材料。音腔盖默认跟随后盖。配色仅为近似显示，银色 PLA 不是真金属，透明 PETG 按 FDM 磨砂透光表现，不承诺玻璃般透明。

| 方案 | 前盖 | 后盖 | 拨帽 | 换卷说明 |
|---|---|---|---|---|
|银黑红 · 推荐|银色 PLA|黑色 PLA|红色 PLA|需换入银色、红色 PLA；黑色沿用槽 4。|
|黑绿 · 无需换卷|黑色 PLA|黑色 PLA|绿色 PLA|当前槽 2 绿色、槽 4 黑色 PLA 即可。|
|蓝黑绿 · 无需换卷|蓝色 PLA|黑色 PLA|绿色 PLA|当前槽 1 蓝色、槽 2 绿色、槽 4 黑色 PLA 即可。|
|黄黑红 · 明亮|黄色 PLA|黑色 PLA|红色 PLA|需换入黄色、红色 PLA；黑色沿用槽 4。|
|红黑黄 · 复古|红色 PLA|黑色 PLA|黄色 PLA|需换入红色、黄色 PLA；黑色沿用槽 4。|
|绿黑蓝 · 无需换卷|绿色 PLA|黑色 PLA|蓝色 PLA|当前槽 1 蓝色、槽 2 绿色、槽 4 黑色 PLA 即可。|
|白灰黑 · 全 PETG|白色 PETG|灰色 PETG|黑色 PETG|需换入白、灰、黑 PETG，并使用对应 PETG 配置。|
|灰黑白 · 全 PETG|灰色 PETG|黑色 PETG|白色 PETG|需换入灰、黑、白 PETG，并使用对应 PETG 配置。|
|黑透白 · 全 PETG|黑色 PETG|透明 PETG|白色 PETG|透明 PETG 在槽 3；另需黑、白 PETG。后盖为磨砂透光示意。|

首推银黑红 PLA（成品感更强），无需换卷可选黑绿 PLA。若优先卡扣韧性和反复拆装，白灰黑或灰黑白 PETG 更合适。PLA 适合先试装，卡扣寿命仍取决于打印质量。混选 PLA/PETG 零件时建议分盘，不在同一个零件中互相叠印；不同材料的收缩、流量和孔位补偿也需要各自试装。

## 不用胶的音腔

- 后盖一体打印围壁，外轮廓 13.2 × 20.1 mm，主墙厚 0.8 mm。弹片后局部让位 0.2 mm，局部壁厚 0.6 mm。
- 喇叭发声面朝后盖，硬边框直接坐在连续承台上；两侧倾斜弹片夹住硬侧壁。名义开口 9.7 mm，适配标注宽度 9.8～10.2 mm，每侧名义让位 0.15 mm、最大约 0.25 mm。
- 音腔盖板厚 0.8 mm，连定位凸台最大厚 1.7 mm。先以约 6° 斜角滑入后方固定挂钩，再压下前边，由两个卡扣捕获。卡扣名义扣合量 0.15 mm、上方活动间隙 0.15 mm。
- 装配/拆卸时，前卡扣约向外让 0.25 mm；喇叭弹片可轻向外让约 0.3 mm。不用胶、不用胶带、不用软圈、不增加金属紧固件。
- 两根线从 2.2 mm 槽引出。线槽保持未密封；实际线径、焊点和走线未获得精确尺寸，仍需实物检查。
- 仍为四件打印件：前盖、后盖、拨帽、音腔盖。卡扣和喇叭弹片均属于后盖。

这是**无胶的非气密试验结构**。硬质承台、拼缝和线槽都会漏气，不能将几何改进等同于声压增加。出声孔较旧设计增加，前后声路径的隔离有改善意图，但是否更响、是否出现杂音、低频是否下降，必须用同一信号与音量对比有盖/无盖。并不保证比原版更响。

只允许弹片接触实际喇叭的硬边框；供应图没有完整边框/背部孔位，装配前需检查，不得夹压振膜或遮住透气孔。如果出现松动、明显应力发白或卡死，应先修改弹片尺寸，不强行装入。

## 装配和验证

先装喇叭与腔盖，再放 PCB。拆腔盖前先取出 PCB，轻拨前卡扣，抬起前边后退出后方挂钩。电池继续沿用用户先前的安装方案；这里的免胶要求适用于音腔结构。

主体尺寸仍为 85 × 45 × 14.4 mm。电池框净空 52 × 30 mm，名义占位 50 × 28 × 3 mm，成品含保护板和包边建议 ≤51 × 29 × 3.3 mm。前盖、拨帽打印几何与 v0.6 相同。

验证包括四件实体/网格、静态刚性干涉、原拨帽及 TF 路径。喇叭弹片对喇叭包络的相交是刻意预压，单独记录，不作为刚体无干涉通过。弹片张开按近似剪切形变检查；腔盖路径按滑动 0.2 mm、旋转 0.5° 步长采样。上述几何检查不等于 FEA、疲劳验证或实测夹持力。

前盖和拨帽与 v0.6 的 STL SHA256 一致；其既有公差验证可沿用。本版未重复执行与本次更改无关的全套前盖公差计算。

## 文件与预览

- `myMicrobyte_enclosure_v07.FCStd`：原生 FreeCAD 模型与布尔树。
- `myMicrobyte_enclosure_v07.step`：四件实体。
- 四个 `*_print.stl`：打印姿态，最低 Z=0；音腔盖外面朝下，拨帽纹路朝上。切片时需检查细弹片和挂钩形成情况，不应让支撑把活动间隙焊死。
- `../assembly-guide-v07/index.html`：离线交互页；当前服务地址 http://127.0.0.1:55215/ 。可切换 9 套库存方案、单独选每个零件耗材、查看音腔爆炸图和挂扣动画。
- `../../reports/v07/`：几何/装配检查、库存表、配色和音腔截图。

页面配色不自动更改打印机槽位或材料参数；零件偏移不重建 CAD 或执行干涉检查。需要修改几何时编辑 `../../freecad/update_enclosure_v07.py` 并重建，尺寸表并非全部特征的表达式驱动源。

当前几何估算后腔剩余空气空间约 0.455 cm³，出声开孔约 41.6 mm²。该数值不包含未知喇叭内部气腔和线束，且腔体不气密。

## 本次打印任务

同盘 9 件：黑色 PLA 前盖、后盖、音腔盖各 1 件；拨帽为黑色、绿色、蓝色 PLA 各 2 件。AMS 映射：黑 A4、绿 A2、蓝 A1。使用 0.4 mm 喷嘴、0.16 mm 层高、4 壁、20% gyroid、Arachne 墙生成、仅热床支撑。模型原有打印姿态保留，拨帽纹路朝上。

最终切片文件：`../../printing/A1_black_green_blue_PLA_v07/myMicrobyte_v07_A1_black_green_blue.gcode.3mf`；可编辑排版项目为同目录 `.3mf` 文件。软件估时 3 小时 16 分 52 秒，总用料 41.33 g（含支撑、清料和擦料塔）。最终状态以同目录 `print_followup_state.json` 和打印机为准；已发送不代表已打印完成。
