88431844/myMicroByte/output/v08/README_v08.md

# myMicrobyte v0.8 设计审阅包

状态：2026-10-17，模型与交互预览完成。本轮未切片、未发送打印，等用户看过 A/B 前盖后选择。以前版本的自动打印授权不延用到本轮新改动。

## 查看文件

- 交互页：`../assembly-guide-v08/index.html`，包含离线 Three.js 与真实 FreeCAD 网格；可直接打开。当前本机服务见 `../../reports/v08/preview-server.json`。
- 外观与高度：`v08_front_comparison.png`
- 双版爆炸图：`v08_exploded_comparison.png`
- 喇叭、桌面声道与拨帽：`v08_acoustic_slider_details.png`
- FreeCAD 原生文件：`myMicrobyte_enclosure_v08.FCStd`。内含两件备选前盖，默认显示 A。一次装配只使用一件前盖。
- STEP：`myMicrobyte_v08_A_raised.step` / `myMicrobyte_v08_B_flat.step`。
- 打印候选网格：`FrontShell_A_raised_print.stl`、`FrontShell_B_flat_print.stl`、`RearShell_print.stl`、`PowerSlider_print.stl`、`AcousticLid_print.stl`。尚未做本轮打印方向与支撑审查。

图片采用银色前盖以便分辨形状，局部用不同颜色区分零件；不代表已改变用户的打印配色。交互页保留库存配色，默认黑壳绿拨帽。

## 设计依据与前盖比较

用户确认取下前盖后，裸板按 MENU/A/B 没有水波纹。新胶层约 1 mm，旧外壳让位基于约 0.1 mm；与旧前盖压住屏幕的现象吻合，但未进行实物受力测量。

两版玻璃均维持 PCB 上方约 1 mm 胶层＋1.9 mm 玻璃厚度，不额外垫高。改为整个玻璃外形贯通让位，去掉覆盖玻璃边缘的压边，只保留侧面短定位结构。开口会露出玻璃的不显示边框；开口尺寸不等于有效显示尺寸。

| 高度（mm） | A 凸框 | B 平面 |
| --- | ---: | ---: |
| 按键区外表面 Z | 14.20 | 14.20 |
| 屏幕框外表面 Z | 15.40 | 14.20 |
| 玻璃顶面 Z | 13.50 | 13.50 |
| 普通静音开关顶面 Z | 15.60 | 15.60 |
| 框高出按键区 | 1.20 | 0 |
| 玻璃低于框顶 | 1.90 | 0.70 |
| 普通按键露出 | 1.40 | 1.40 |

PCB 后平面 Z9.0，名义厚度1.60005。源 PCB 的 A 键稍有旋转和倾斜，因此其实际包络与名义值不同。

- 全玻璃让位开口32.72×34.92，玻璃31.52×33.72，名义侧隙0.6/边。
- 加大玻璃包络并偏移±0.2 XY、+0.2 Z后，两版最小几何距离均0.3。
- 常规按键孔7.4→6.6；A键因模型略旋转采用6.8。十字区中心开口7.2→5.7，继续连通，避免出现悬空的中心小岛。
- 电池框52×30，选型包络建议成品（含包边、保护板）≤51×29×3.3；尚未购买，50×28×3仅为占位。
- 保留前后外缘圆角、TF遮挡眉沿和倒角、Type-C开口、后盖充电LED孔；前盖RUN孔继续取消。

## 拨帽与装入

内侧横边6.8→10.4，叉槽1.95→1.65；机械范围−0.55～+3.05，总3.6。保留外侧防滑纹，导出打印姿态使纹路朝上。

后盖新增两处防脱弹片。装好 PCB 后，轻向外拨弹片约0.3，让拨帽沿敞口导轨落入、套住白色开关拨杆，再释放弹片。前盖合上后进一步限制上浮。不能强行硬压，动画不模拟弹片变形。

几何检查覆盖竖直装入路径、完整滑动行程及导轨横向游隙的两端；每个姿态至少一处挂扣挡住上浮。弹片强度、打印公差、疲劳寿命与开关电气到档需实物验证。

## 声学改动与对比方法

用户实测围壁比无围壁响，但实心盖装上后变小声。可能原因包括较小后腔限制空气运动、喇叭背部透气路径受限，或盖板/线束压到喇叭；目前没有定量声学测量，不能判定唯一原因。

本版保留围壁与纯打印固定，盖板改成9×14.4大开窗固定框，保留挂钩及双卡扣，线槽扩到3.2。可拆框对照，不需要胶或软密封圈。这不是气密或调谐音箱，不承诺声压提升。

后盖增加四个0.9高的圆角矮脚，声孔外侧有0.45深的浅槽并通向侧边。声孔开口总面积约47.7 mm²。主要通过离桌间隙减轻桌面堵孔，错位条纹仅作辅助。

建议下一轮固定同一音源、音量、测量距离，对比：开窗盖/无盖、手持/桌面平放；同时听杂音并检查线束是否挤压。若围壁＋无盖仍较好，可直接不装可拆固定框，并检查侧弹片是否足够稳定。

## 验证与打印前事项

已通过：

- 5件备选/公共打印实体各为有效单实体；STL封闭、无非流形边、无自交，STL/实体体积误差均<0.01%。
- 原生文件重新打开与重算通过。
- 两版外壳与源PCB元件、LCD公差包络、TF插入路径，无未解释的静态穿模。喇叭侧弹片的设计夹持量单独按弹性让位检查。
- 拨帽37个滑动姿态；以0.1步距检查12 mm竖直装入路径，弹片假定向外让0.3；检查导轨横向游隙两端的防脱重叠。
- 音腔盖挂入与落下24个姿态，卡扣假定外让0.25；喇叭侧弹片让位检查通过。
- 交互页A/B切换、合拢/爆炸、音腔有盖/无盖、拨帽行程、步骤说明及图像导出均检查。无浏览器错误，旧版Three.js有一条弃用提示。

以上为刚体几何与近似弹片让位检查，不模拟壳体弯曲、胶层不均或真实弹性。仍需装机黑屏检查、按MENU/A/B测试、螺丝逐步拧紧检查、开关到档与喇叭试听。

A凸框外表面及后盖矮脚改变了落盘接触面，切片前要审查摆放与支撑，避免将大面积可见外表面直接落在支撑上。B平面前盖更容易获得平整的正面打印效果。不要直接复用v0.7 G-code。

## 生成与审计

FreeCAD自带Python执行：

1. `freecad/update_enclosure_v08.py`
2. `freecad/save_v08_view_metadata.py`（系统Python，保存可见性）
3. `freecad/validate_v08_exports.py`
4. `freecad/validate_v08_slider_install.py`
5. `freecad/validate_v08_acoustic_motion.py`
6. `freecad/export_v08_preview.py`
7. `output/assembly-guide-v08/build.py`（系统Python）

审计结果位于 `reports/v08/fit_check_v08.json`、`export_validation_v08.json`、`slider_install_validation.json`、`acoustic_motion_v08.json`。原生文件为可编辑布尔树；全局尺寸重建使用生成脚本，参数表是尺寸记录。

网页中的位置偏移与备注用于表达修改意图，不会自动修改CAD、开孔或STL；没有实时干涉求解。改变前盖方案只切换显示，不会把两件前盖一起装配。
