88431844/myMicroByte/output/v09/README_v09.md

# myMicrobyte v0.9 · 实物反馈修订

2026-10-18。使用本机 FreeCAD 生成原生 CAD、STEP、打印姿态 STL 和真实网格交互页。本轮按用户要求先审阅爆炸图，未切片、未发送打印。

## 查看

- [交互装配页](../assembly-guide-v09/index.html)：整机爆炸、合拢、屏幕限位框、压条装入、喇叭爆炸、拨帽行程及配色。可离线打开；本机服务地址记录在 ../../reports/v09/preview-server.json。
- [整机与外观](v09_assembly_review.png)
- [屏幕框与剖面](v09_screen_review.png)
- [压条、喇叭与平整背面](v09_rear_slider_review.png)
- 原生文件：myMicrobyte_enclosure_v09.FCStd。
- STEP：myMicrobyte_enclosure_v09.step。
- 候选打印件：FrontShell_print.stl、RearShell_print.stl、PowerSlider_print.stl、SliderKeeper_print.stl。四件各打印一件；本轮没有音腔盖。

## 前盖

以用户照片中正面朝上打印的凸框版 F3 为基础。保留常规按键孔6.6 mm、A孔6.8 mm，按键区表面Z14.2，凸框顶面Z15.4（高出按键区1.2 mm），名义按键露出1.4 mm。

显示窗口从全玻璃开口32.72×34.92缩为29.72×29.72 mm，位于既有显示区中心。用户资料显示有效显示27.72×27.72、玻璃31.52×33.72×1.9 mm，因此窗口名义每边比有效显示区多1 mm。窗口遮住部分非显示黑边；保留外侧凸框。

内侧改为1.2 mm壁厚的整圈限位框，净空32.52×34.72，玻璃每边名义留空0.5 mm。下沿保留12 mm宽、0.65 mm高的浅排线让位，框上部连续。屏幕仍由原胶层固定在PCB；这个框只限制横向移动，不硬夹玻璃。

约1 mm原胶层＋1.9 mm玻璃时，玻璃顶面Z13.50005；遮边底面Z14.55，名义竖向留空1.04995 mm。加大并偏移玻璃检查包络后，最小几何间隙0.2 mm。不能用刚体间隙检查替代按键、螺丝和胶层不均造成的变形测试；仍需黑背景实测水波纹和泛白。

前盖打印姿态继续正面朝上、支撑落在内部。STL姿态已设置，正式打印前需重新切片检查，不能复用v0.8 G-code。

## 拨帽和刚性压条

取消原先0.6 mm薄、1.1 mm宽且高约5.65 mm的两条后盖弹片。新增独立刚性压条：横梁1.8×21.3×1.5 mm，两个1.2×2.8×2.25 mm短插脚，直接插入后盖预留槽。无需掰动后盖或压条。前盖有对应让位和上方限位，合盖后压条不能拔出，横梁限制拨帽上浮。

装配顺序：后盖平放→放PCB→放拨帽→放厚压条→合前盖→拧螺丝。压条采用间隙配合，合前盖之前不是独立锁扣，不应倒置摇晃；其最终锁定依赖前盖。

拨帽沿用10.4 mm内横边、1.65 mm叉槽和外侧防滑纹，机械滑动范围−0.55～+3.05 mm，共3.6 mm。导轨总侧隙0.40 mm；短插脚槽每边留0.15 mm。该尺寸是待试装的设计公差，不是已校准的PLA打印公差。

## 后盖与喇叭

按平整后盖实物照片恢复外表面，去掉四个0.9 mm矮脚及外侧浅声道，保留圆角、TF/Type-C开口和充电LED孔。前盖RUN开孔继续取消。电池框净空52×30 mm，成品电池含包边和保护板仍建议≤51×29×3.3 mm。

取消音腔背部固定框、上面一个固定爪、下面两个卡爪和夹喇叭的左右弹片。改为椭圆定位圈（内尺寸10.6×15.6 mm），用喇叭自带环形双面胶贴在连续承台上。胶厚暂按0.2 mm；最大喇叭检查包络包含胶厚增加0.2 mm的余量。定位圈高度到Z4.2，矩形围壁顶面Z6.0，焊片与线束槽保持开放，不盖住喇叭背面。

椭圆圈中心与原出声孔连通，胶圈若连续贴合，可以减少振膜前后气流从周边相互短路。外矩形围壁继续保留，但取消背盖后它是开放围壁，不能视为密闭、具有确定容积的音腔；椭圆圈也会改变局部空气空间。无声压、失真或频响实测，不能保证比上一版更响。

恢复平整后盖意味着失去离桌间隙，平放桌面时声音衰减可能回来。这是按本轮外观选择保留的取舍。

## 已完成检查

- 四件均有效单实体，导出的STL封闭、无自交或非流形边，体积误差小于0.01%；原生文件重新打开并重算后导出交互网格。
- 前后盖、压条、拨帽与源PCB、电子元件、玻璃及电池/喇叭包络检查无未解释穿模。
- 拨帽全行程37个姿态；检查导轨侧隙两端的防上浮重叠。
- 拨帽从上方装入49个姿态、压条装入41个姿态、喇叭及前盖分别33个装入姿态；本轮无需模拟弹片让位。
- TF卡插入包络检查通过。
- 结果：../../reports/v09/fit_check_v09.json、export_validation_v09.json。

这是几何与装入路径验证，不是受力/疲劳/声学验证。屏幕排线实物形态、自带胶厚度、压条手感、按键回弹、盖缝和声音仍需下一轮实物检查。

## 修改与生成

- freecad/update_enclosure_v09.py：FreeCAD原生布尔建模、干涉/路径检查与导出。
- freecad/save_v09_view_metadata.py：原生文件显示信息。
- freecad/export_v09_preview.py、output/assembly-guide-v09/build.py：真实网格交互页面。
- freecad/draw_v09_screen_section.py：CAD截面图。
- freecad/make_v09_review_images.py：审阅图片拼版。

原生文件中的参数表是尺寸记录；全局重建修改生成脚本，局部布尔特征可在FreeCAD中编辑。网页偏移与备注用于交流，不会修改CAD、打印尺寸，也不会实时求解干涉。
