88431844/myMicroByte/output/myMicrobyte_FreeCAD_v01_试装包/reports/rear_inside.png

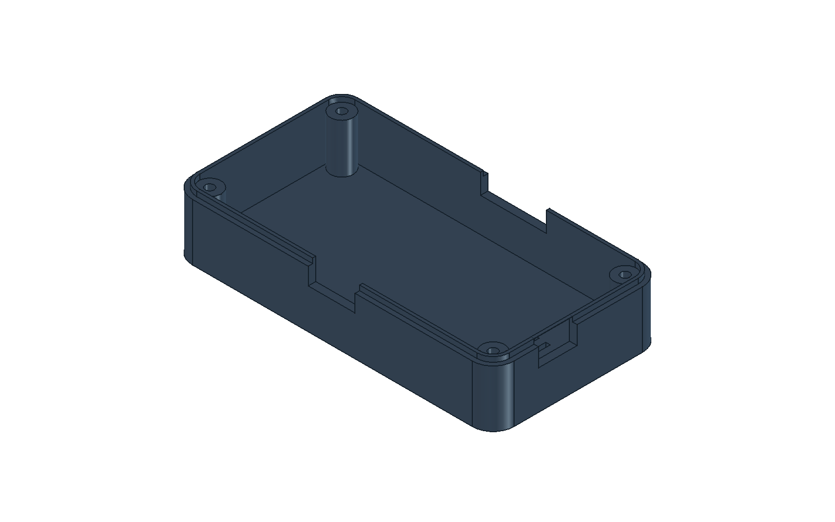
output/myMicrobyte_FreeCAD_v01_试装包/reports/rear_inside.png
