88431844/myMicroByte/output/v10/v10_gba_slider_review.png

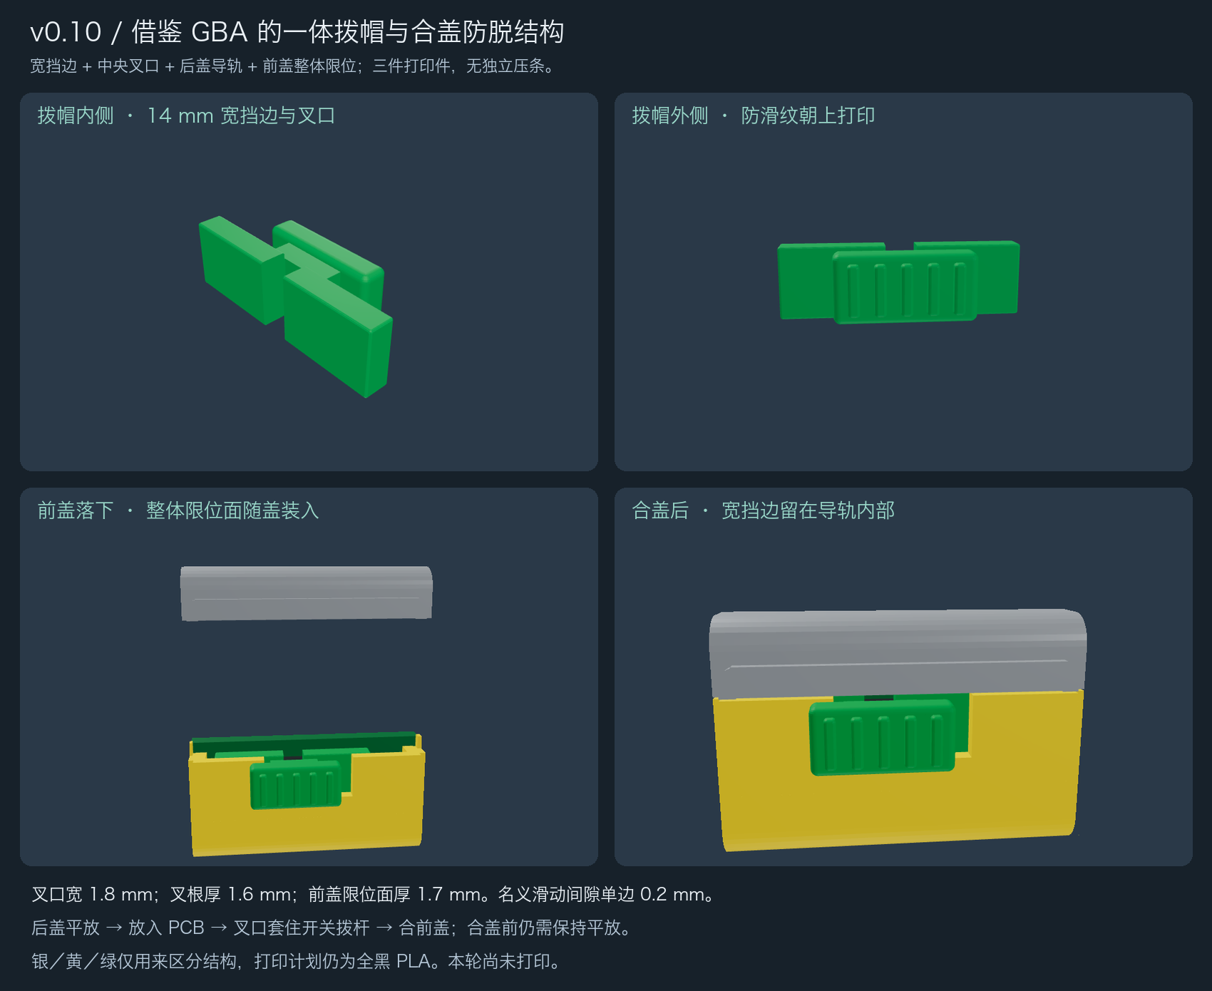
output/v10/v10_gba_slider_review.png
