88431844/myMicroByte/reference/eda_backup/IMAGE/5a8d8aaf7cc2b85a.webp

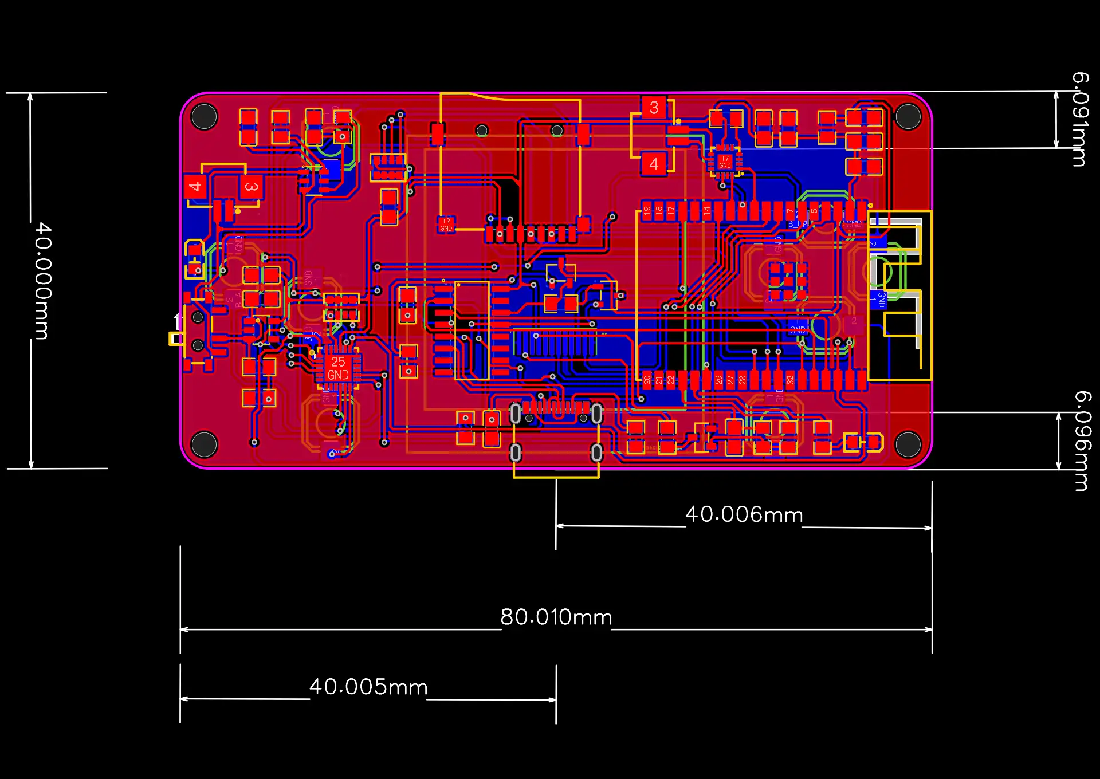
reference/eda_backup/IMAGE/5a8d8aaf7cc2b85a.webp
