88431844/myMicroByte/reference/eda_backup/IMAGE/464badd25d2691be.webp

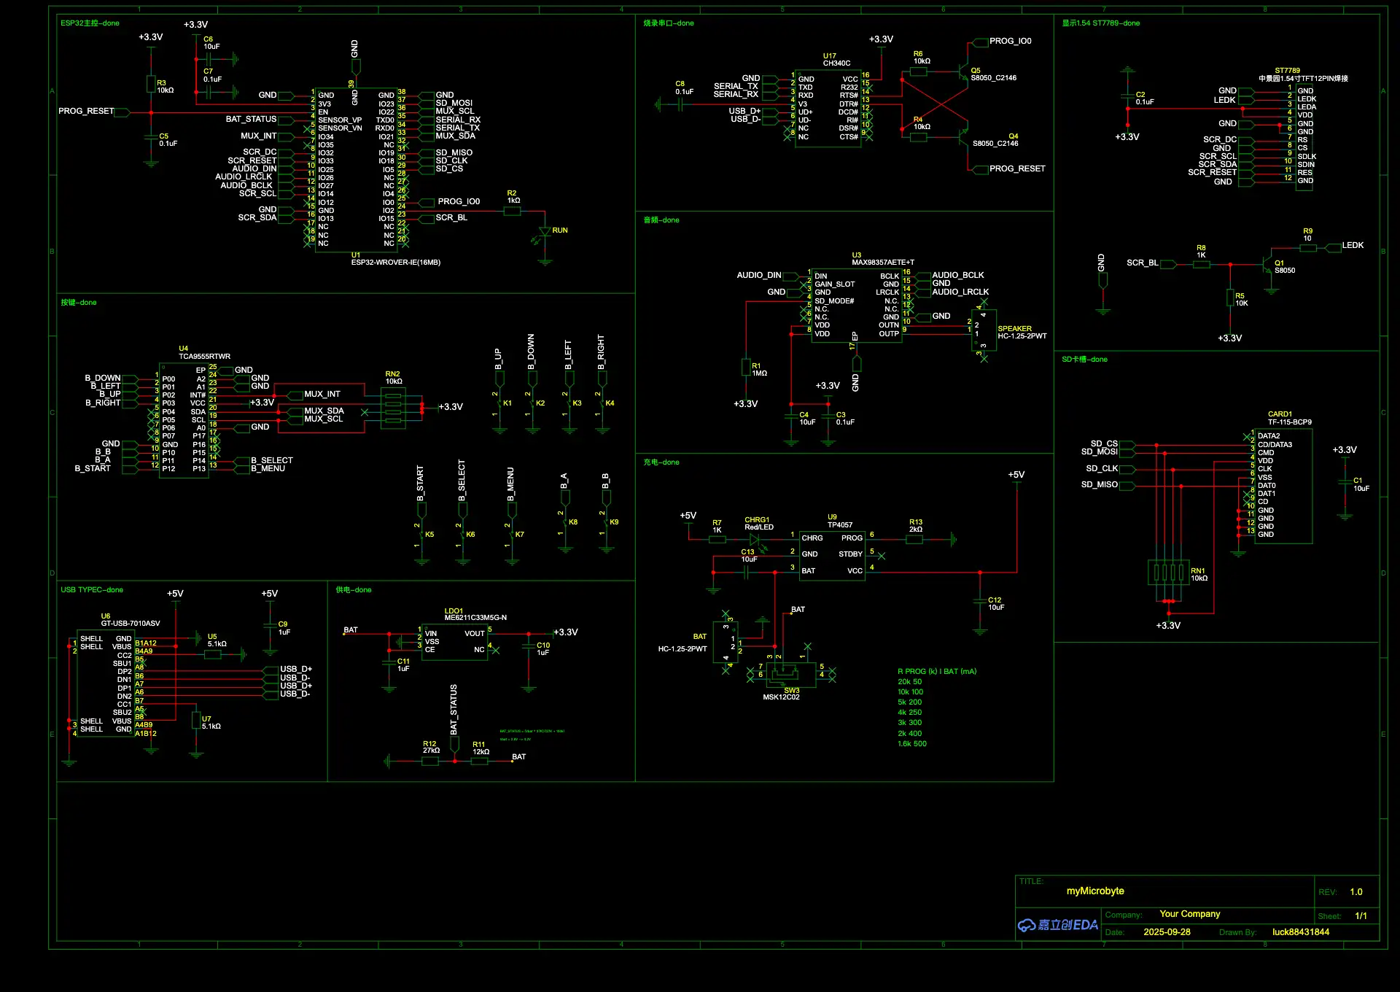
reference/eda_backup/IMAGE/464badd25d2691be.webp
