88431844/myMicroByte/reference/user_dimensions/LCD_1p9mm.png

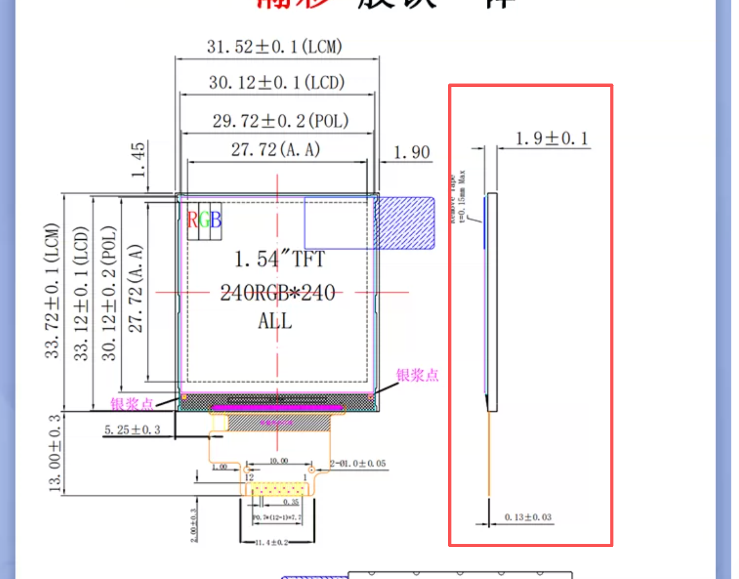
reference/user_dimensions/LCD_1p9mm.png
