88431844/myMicroByte/reference/user_dimensions/Speaker_1510.png

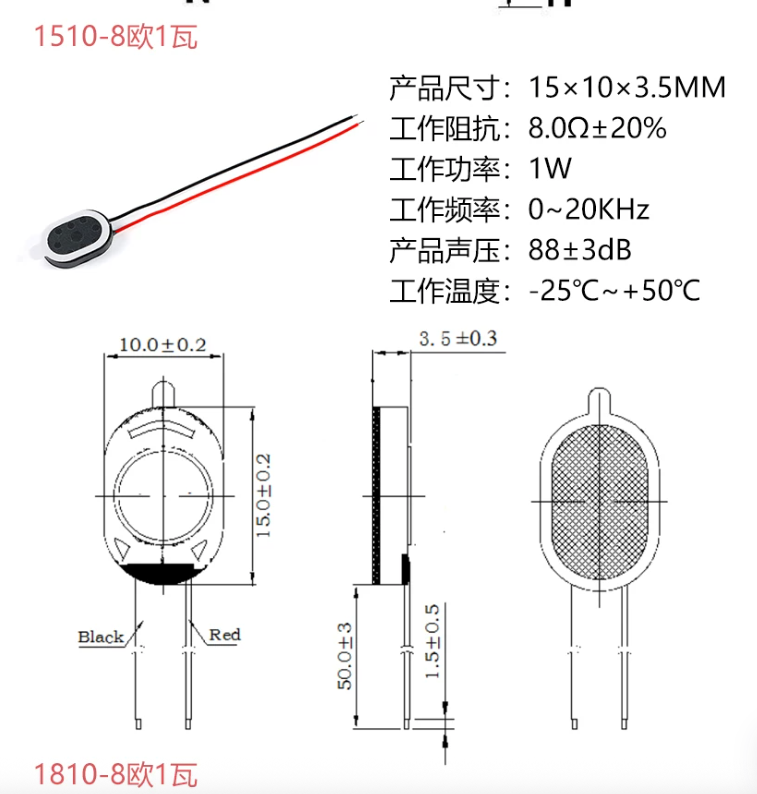
reference/user_dimensions/Speaker_1510.png
