88431844/myMicroByte/reference/v09_feedback/contact_sheet.jpg

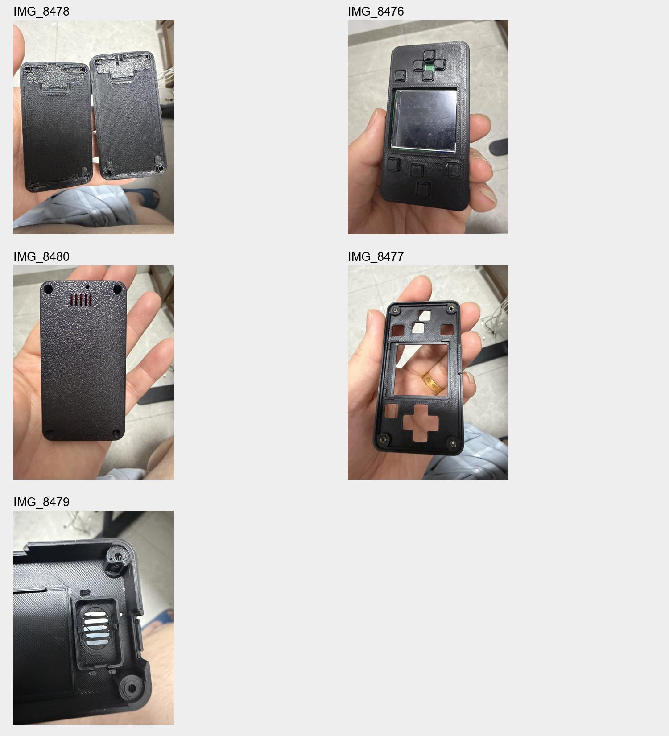
reference/v09_feedback/contact_sheet.jpg
