88431844/myMicroByte/reference/v09_feedback/IMG_8476.jpg

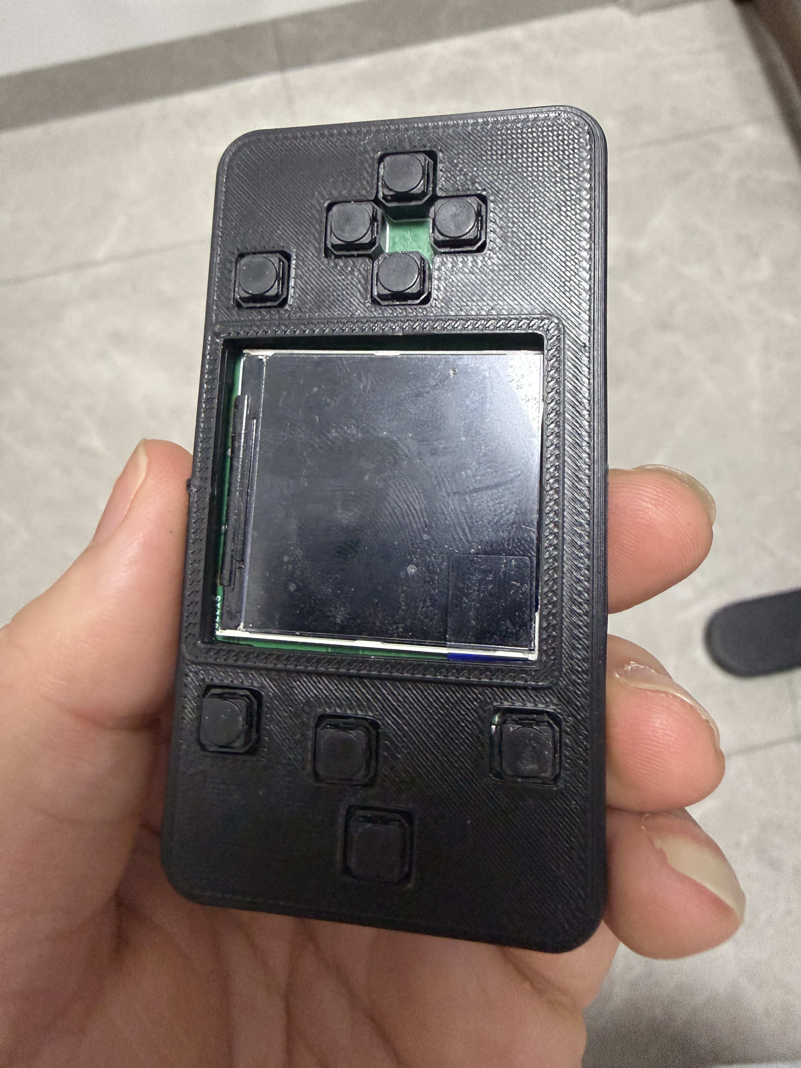
reference/v09_feedback/IMG_8476.jpg
