88431844/myMicroByte/reference/v09_feedback/IMG_8479.jpg

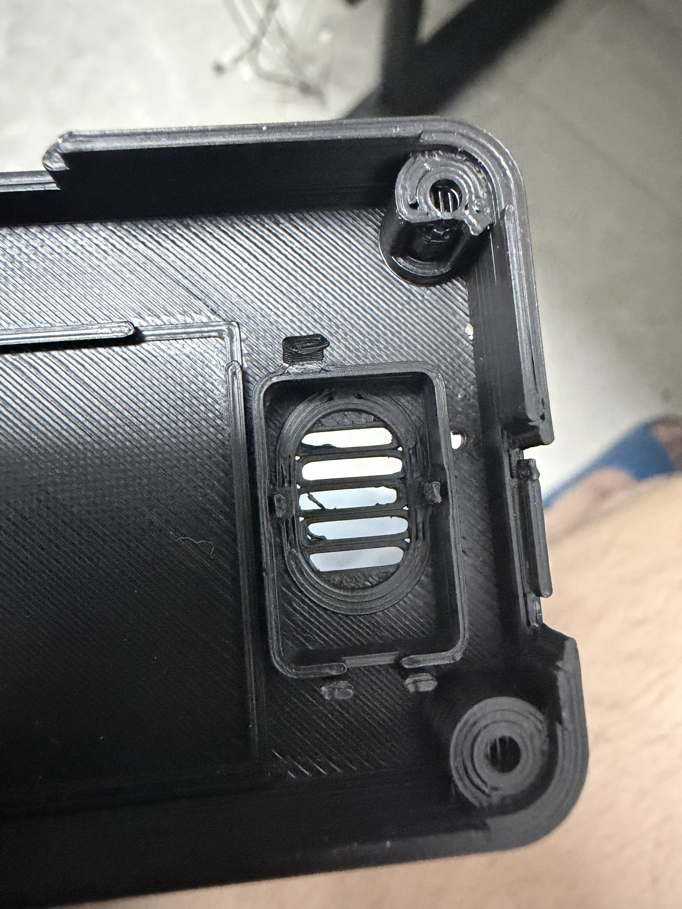
reference/v09_feedback/IMG_8479.jpg
