88431844/myMicroByte/reference/v09_feedback/weak_slider_tabs.png

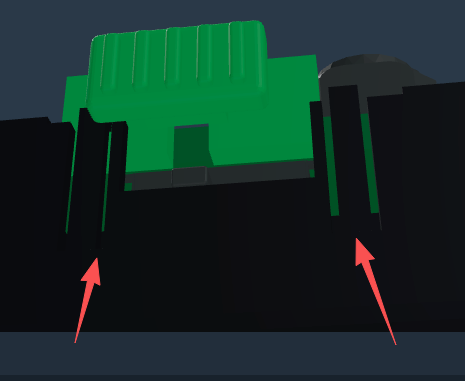
reference/v09_feedback/weak_slider_tabs.png
