88431844/myMicroByte/reference/v10_gba/gba_slider_removed.png

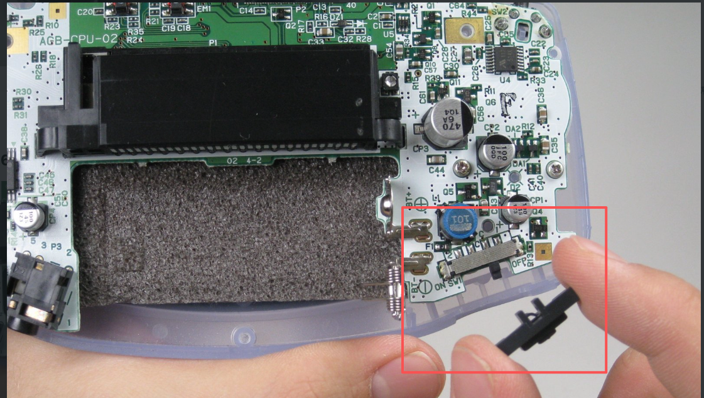
reference/v10_gba/gba_slider_removed.png
