88431844/myMicroByte/reference/v10_gba/gba_slider_seated.png

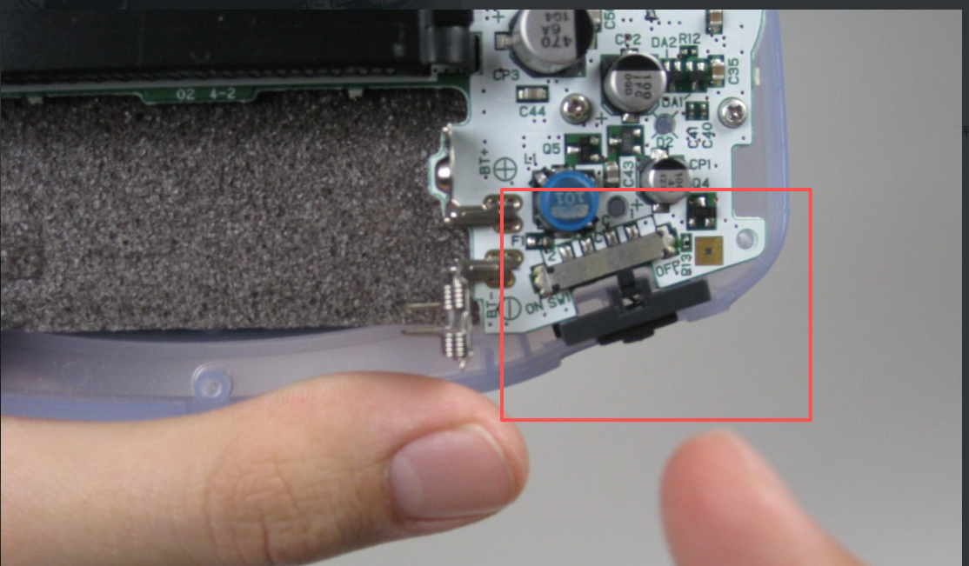
reference/v10_gba/gba_slider_seated.png
