88431844/myMicroByte/reports/Bambu_A1_preview.png

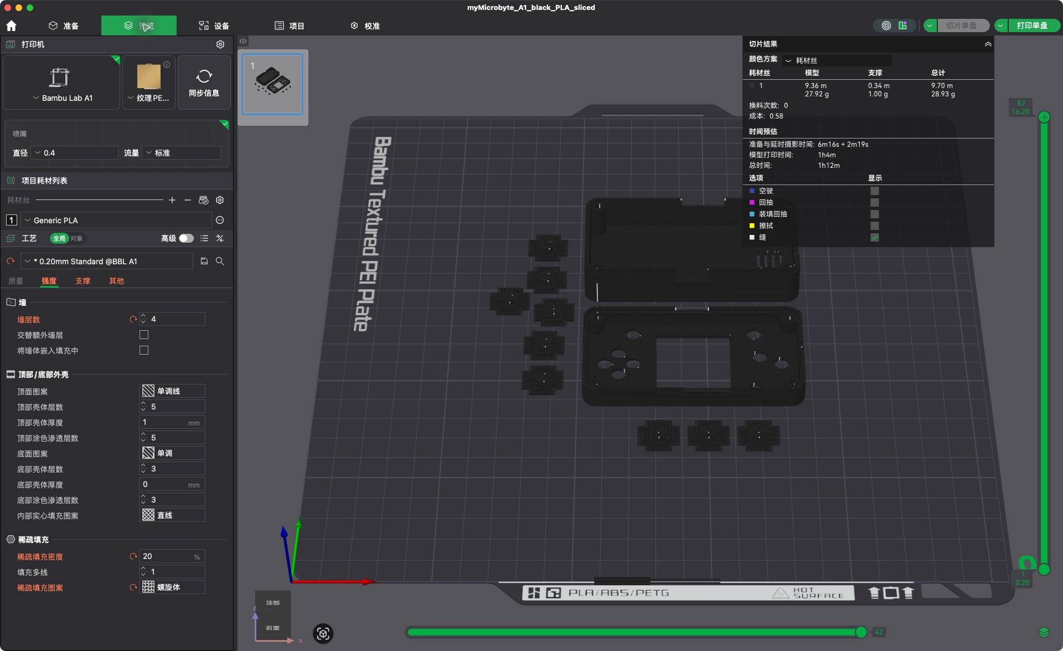
reports/Bambu_A1_preview.png
