88431844/myMicroByte/reports/battery_expansion/电池扩容前后对比.png

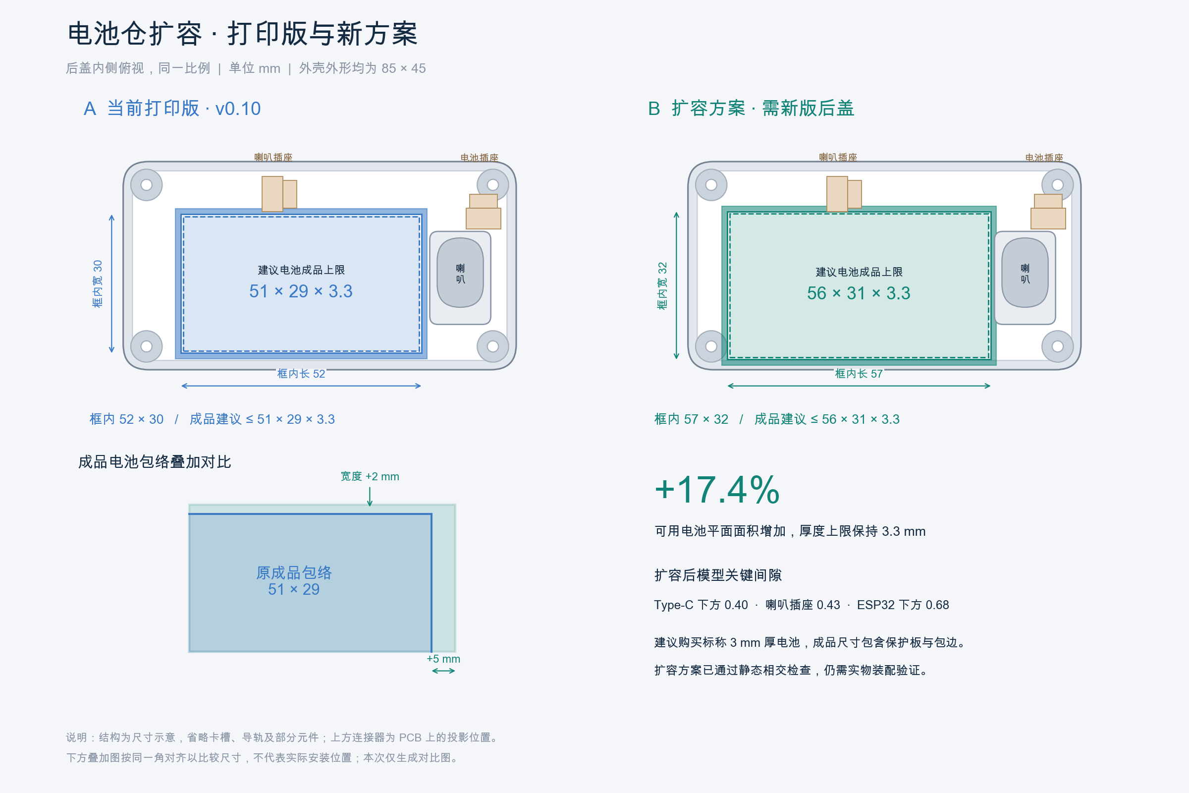
reports/battery_expansion/电池扩容前后对比.png
