88431844/myMicroByte/reports/blackPLA_exploded.png

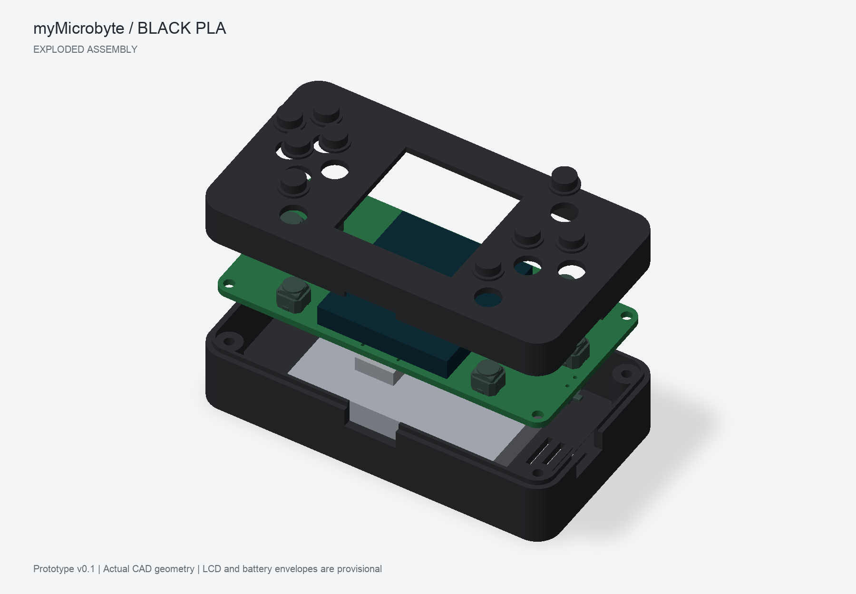
reports/blackPLA_exploded.png
