88431844/myMicroByte/reports/expanded_rear_2/plate_1.png

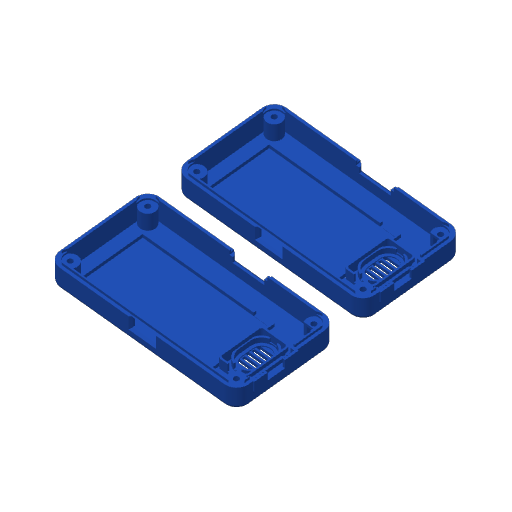
reports/expanded_rear_2/plate_1.png
