88431844/myMicroByte/reports/expanded_rear_2/send_mapping.png

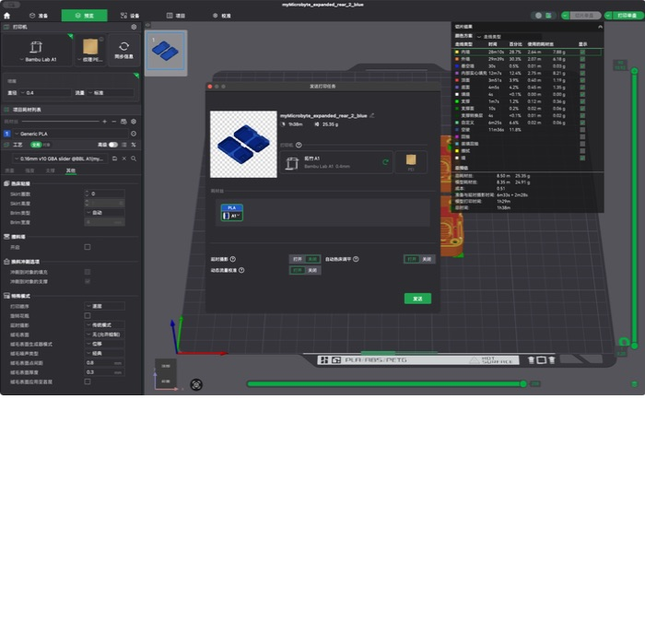
reports/expanded_rear_2/send_mapping.png
