88431844/myMicroByte/reports/expanded_rear_2/top_1.png

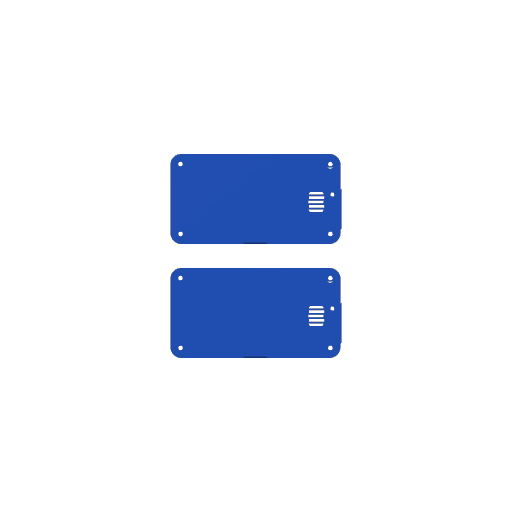
reports/expanded_rear_2/top_1.png
