88431844/myMicroByte/reports/freecad_preview.png

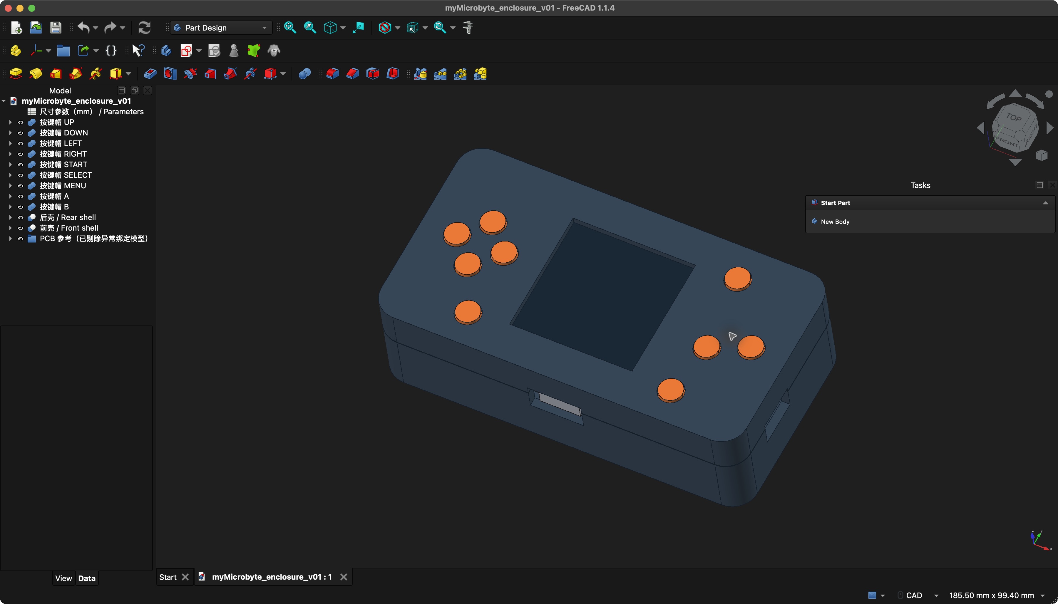
reports/freecad_preview.png
