88431844/myMicroByte/reports/plate_1.png

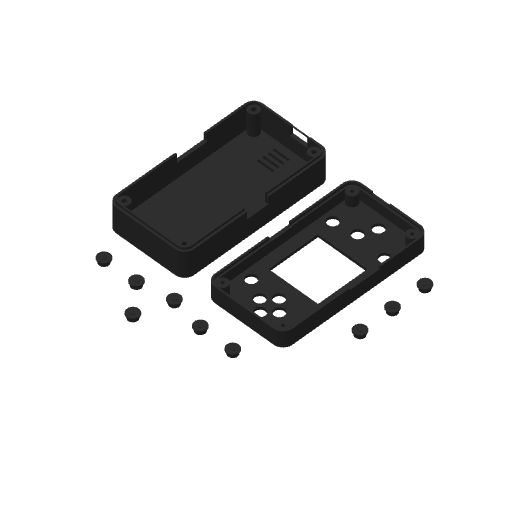
reports/plate_1.png
