88431844/myMicroByte/reports/top_1.png

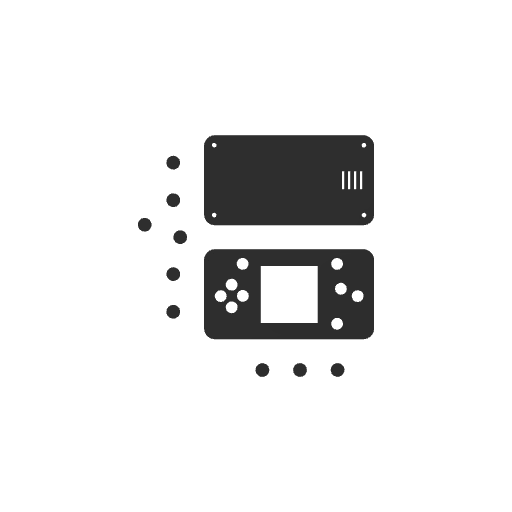
reports/top_1.png
