88431844/myMicroByte/reports/v08_trials/A1_bed_clear.png

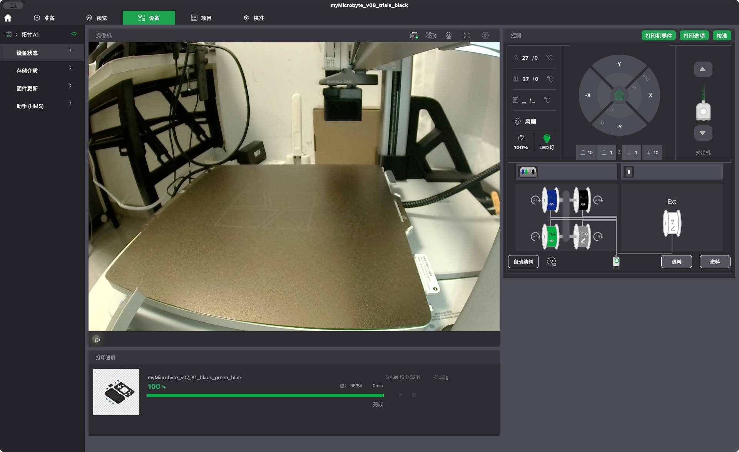
reports/v08_trials/A1_bed_clear.png
