88431844/myMicroByte/reports/v08_trials/A1_first_layer.png

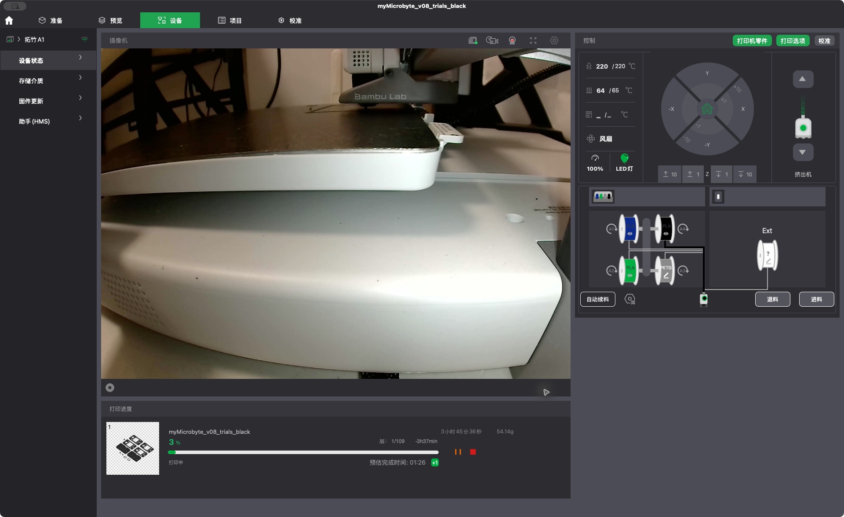
reports/v08_trials/A1_first_layer.png
