88431844/myMicroByte/reports/v08_trials/A1_plate_preview.png

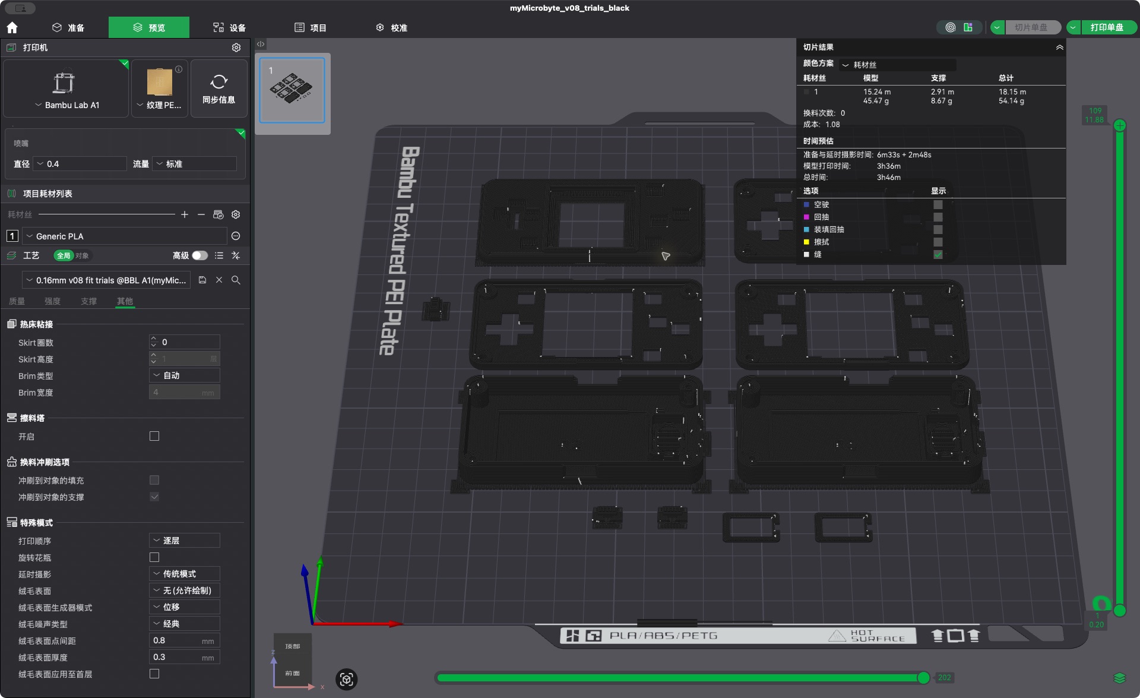
reports/v08_trials/A1_plate_preview.png
