88431844/myMicroByte/reports/v08_trials/A1_send_mapping_crop.png

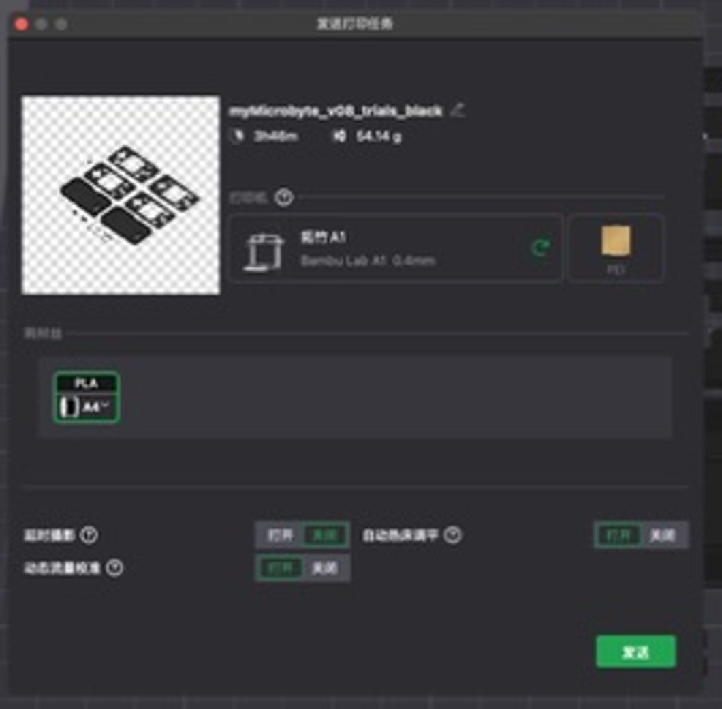
reports/v08_trials/A1_send_mapping_crop.png
