88431844/myMicroByte/reports/v08_trials/engraved_ids_toolpaths.png

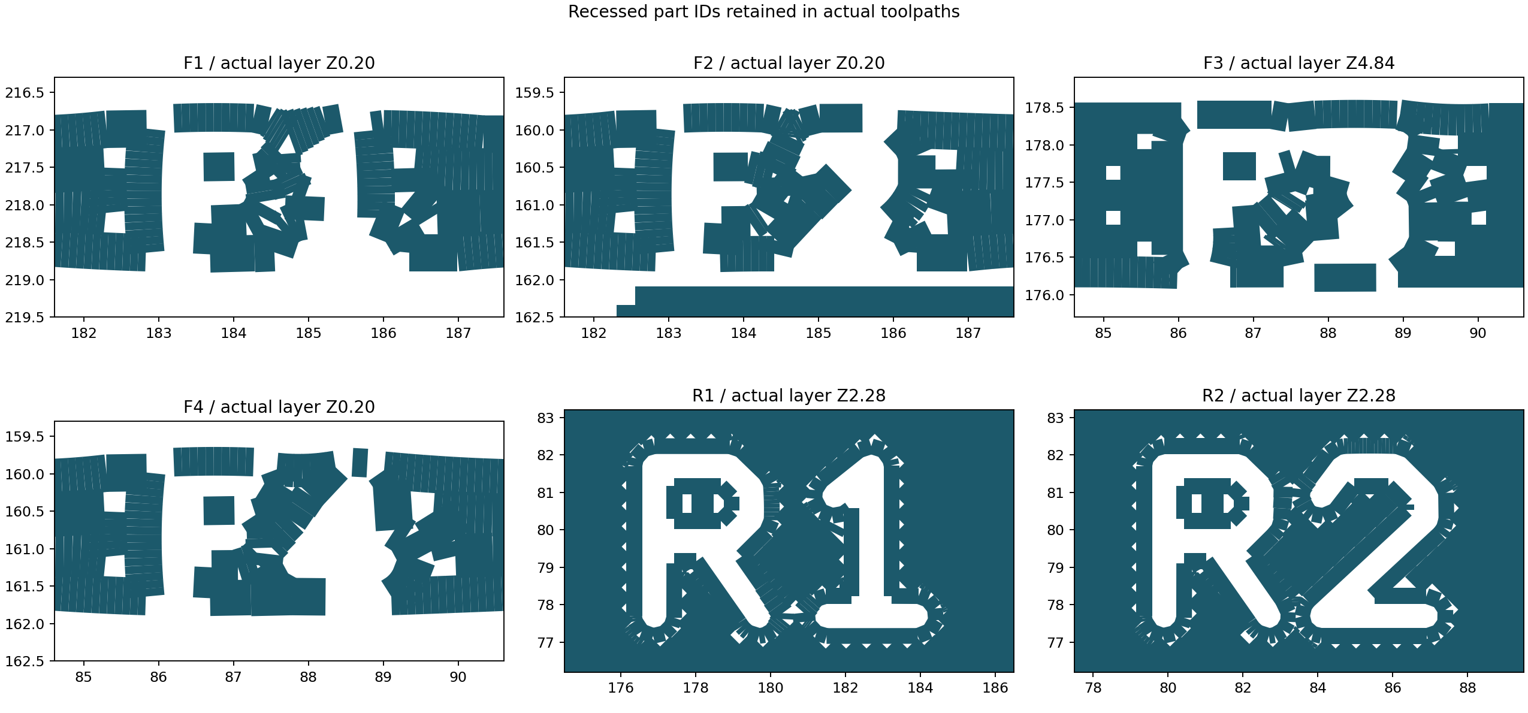
reports/v08_trials/engraved_ids_toolpaths.png
