88431844/myMicroByte/reports/v08_trials/keeper_acoustic_toolpaths.png

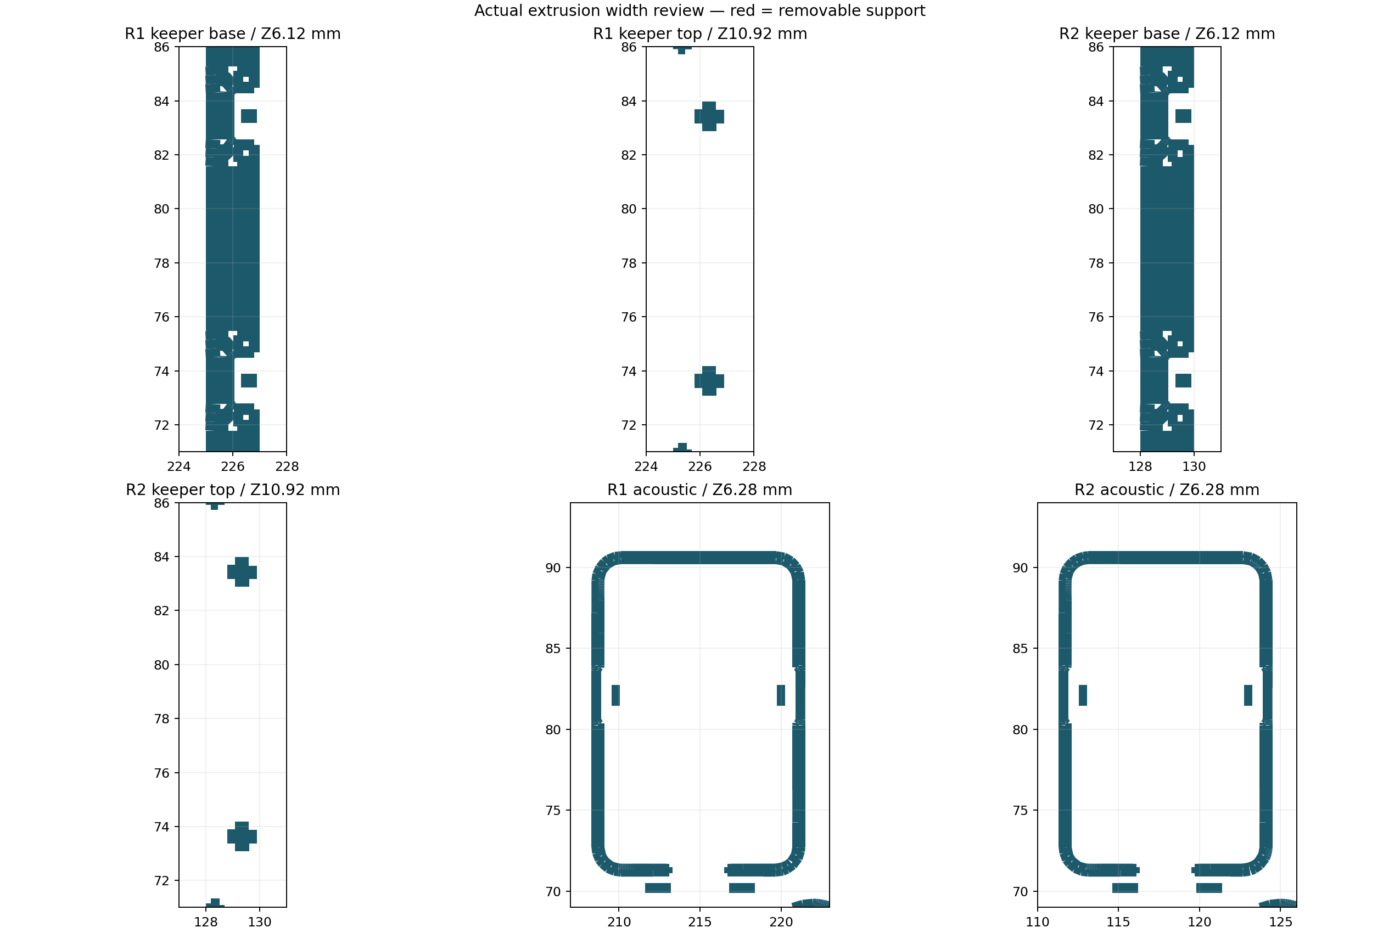
reports/v08_trials/keeper_acoustic_toolpaths.png
