88431844/myMicroByte/reports/v08_trials/plate_1.png

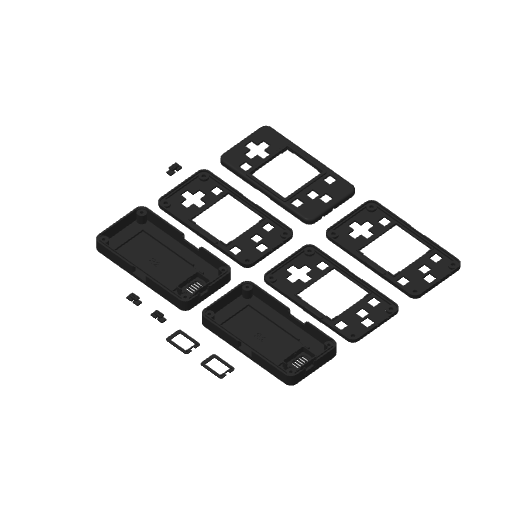
reports/v08_trials/plate_1.png
