88431844/myMicroByte/reports/v08_trials/top_1.png

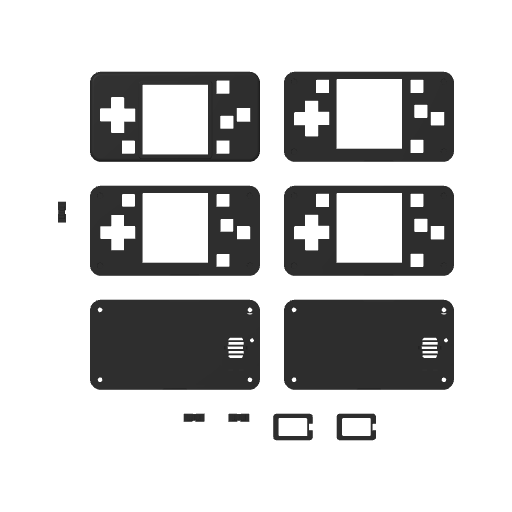
reports/v08_trials/top_1.png
