88431844/myMicroByte/reports/v10/A1_bed_clear.png

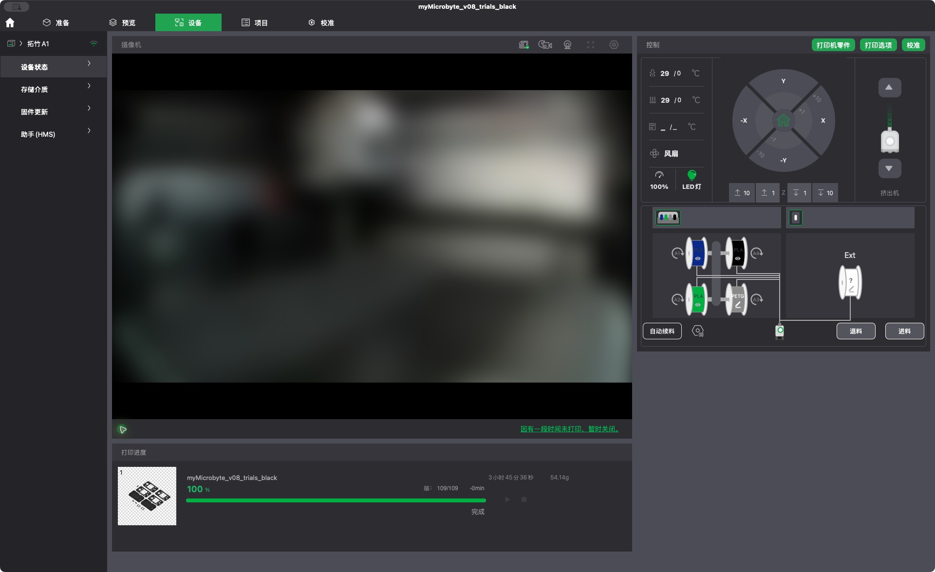
reports/v10/A1_bed_clear.png
