88431844/myMicroByte/reports/v10/A1_v10_send_mapping.png

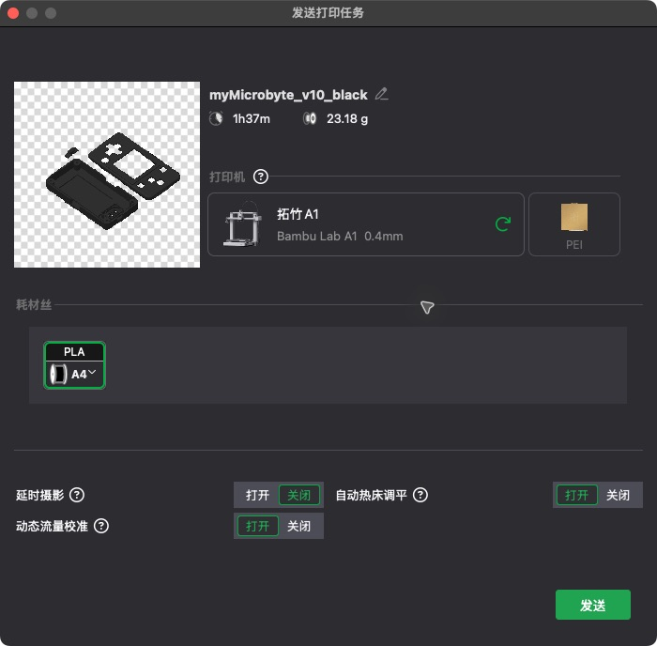
reports/v10/A1_v10_send_mapping.png
