88431844/myMicroByte/reports/v10/A1_v10_send_mapping_crop.png

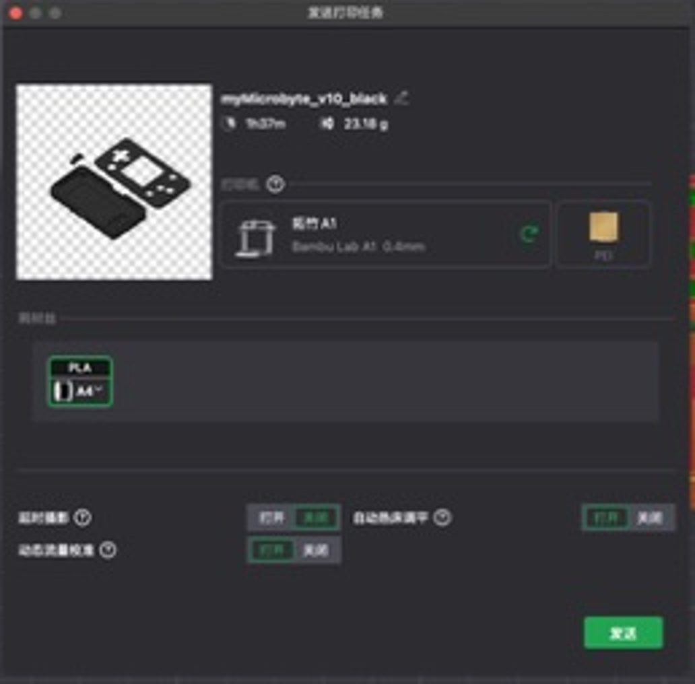
reports/v10/A1_v10_send_mapping_crop.png
