88431844/myMicroByte/reports/v10/A1_v10_sliced.png

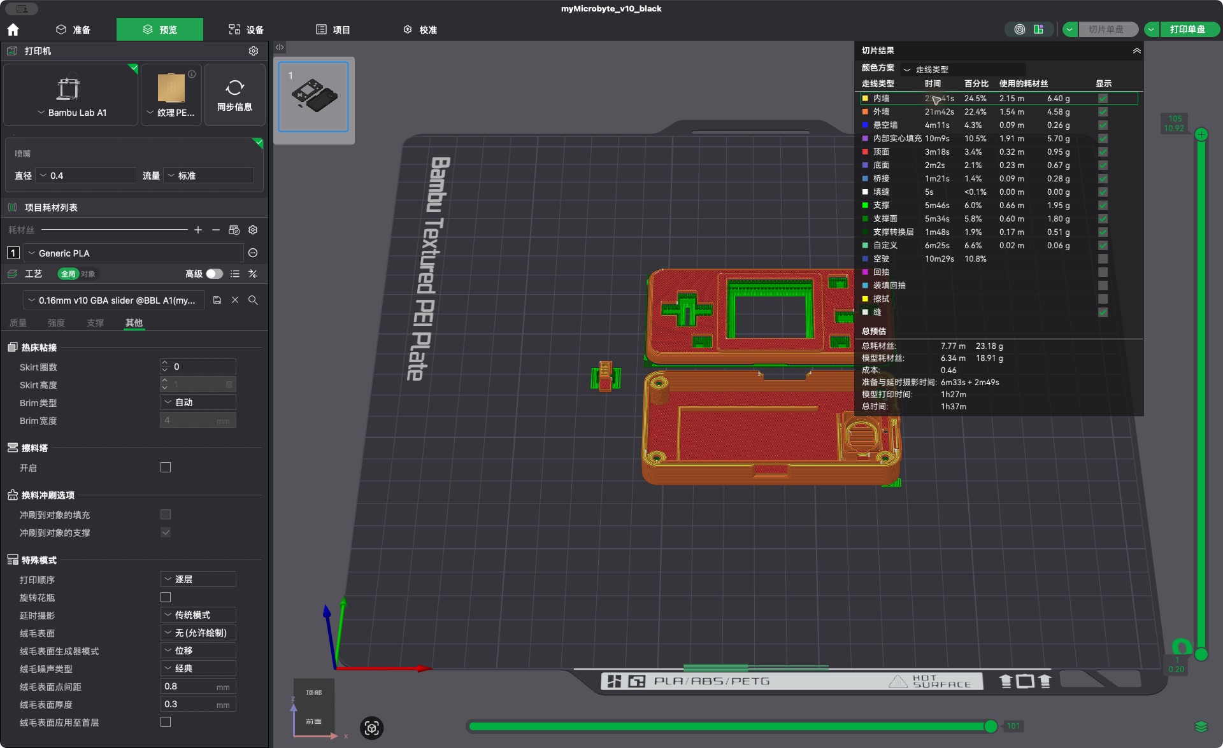
reports/v10/A1_v10_sliced.png
