88431844/myMicroByte/reports/v10/A1_v10_started.png

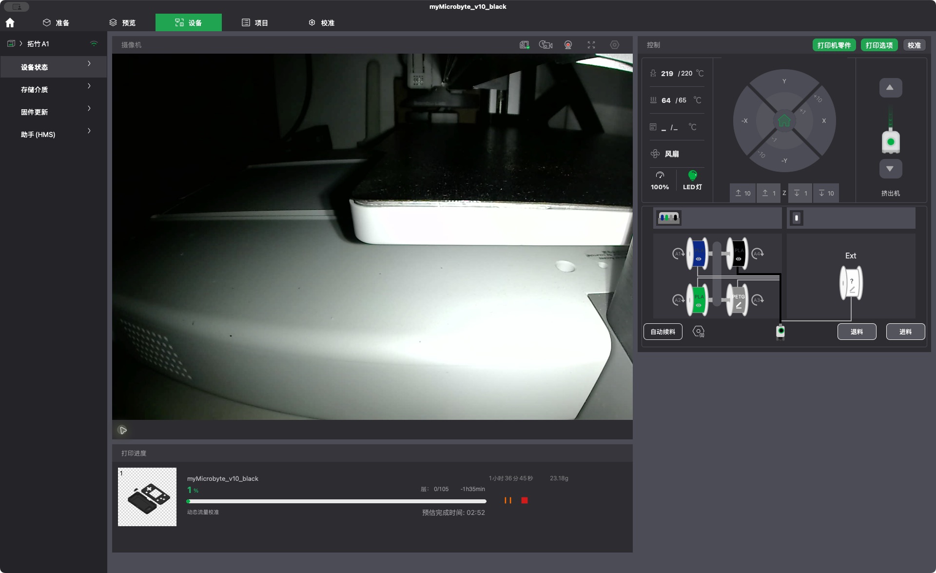
reports/v10/A1_v10_started.png
