88431844/myMicroByte/reports/v10/front_roof_closed.png

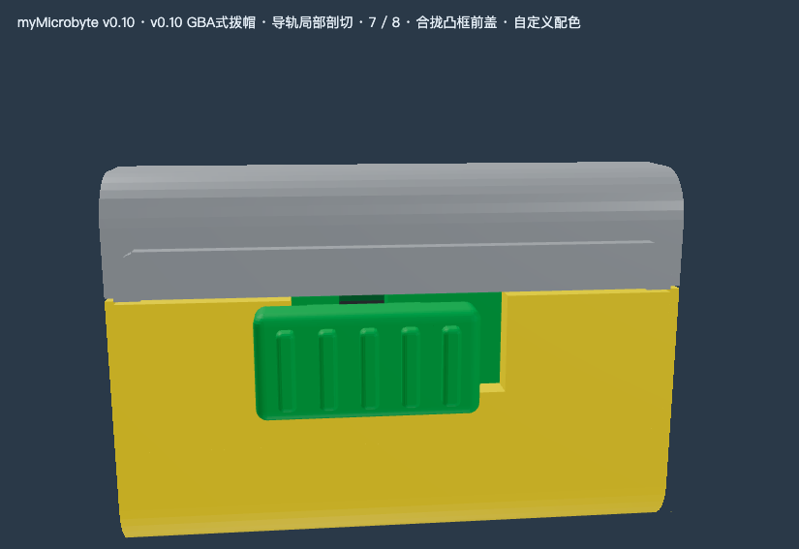
reports/v10/front_roof_closed.png
