88431844/myMicroByte/reports/v10/interactive_final.png

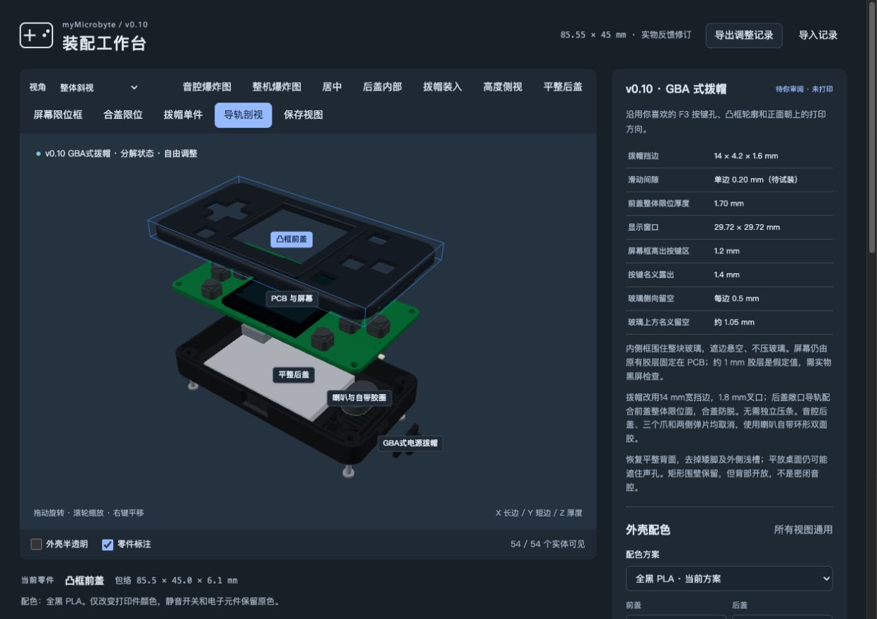
reports/v10/interactive_final.png
