88431844/myMicroByte/reports/v10/plate_1.png

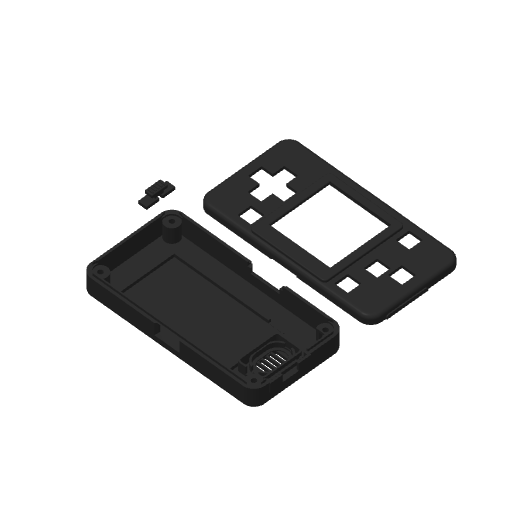
reports/v10/plate_1.png
