88431844/myMicroByte/reports/v10/slider_drop_in.png

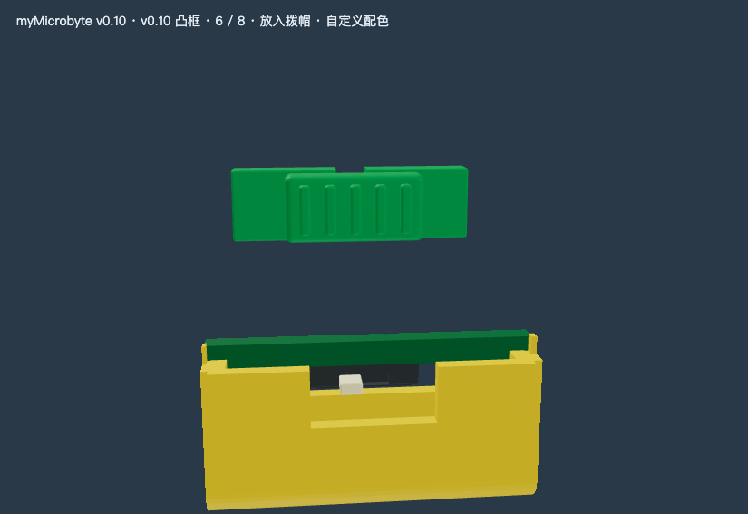
reports/v10/slider_drop_in.png
