88431844/myMicroByte/reports/v10/slider_max.png

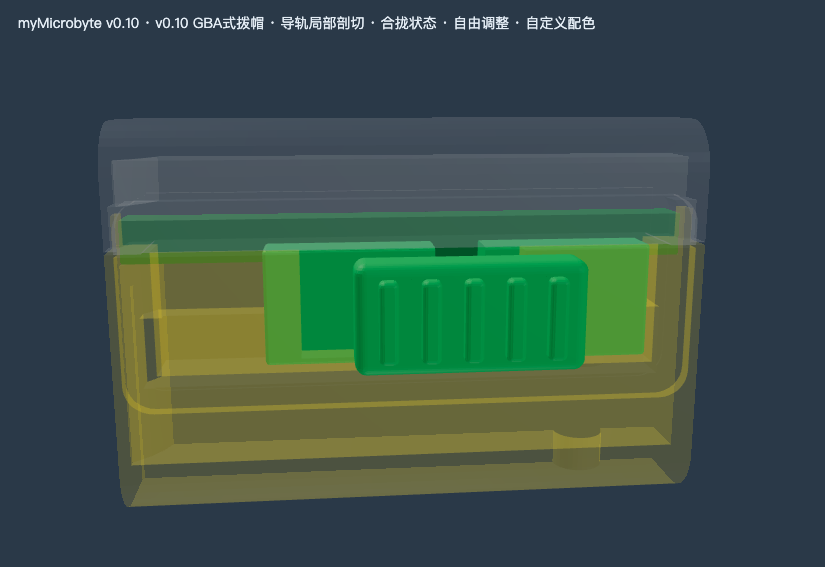
reports/v10/slider_max.png
