88431844/myMicroByte/reports/v10/slider_min.png

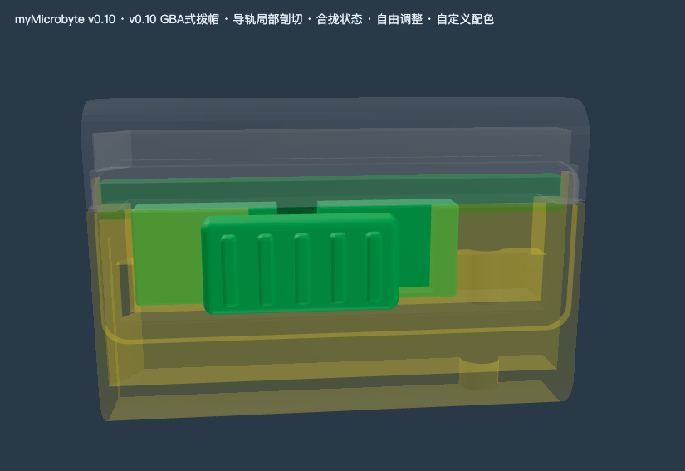
reports/v10/slider_min.png
