88431844/myMicroByte/reports/v10/slider_outer.png

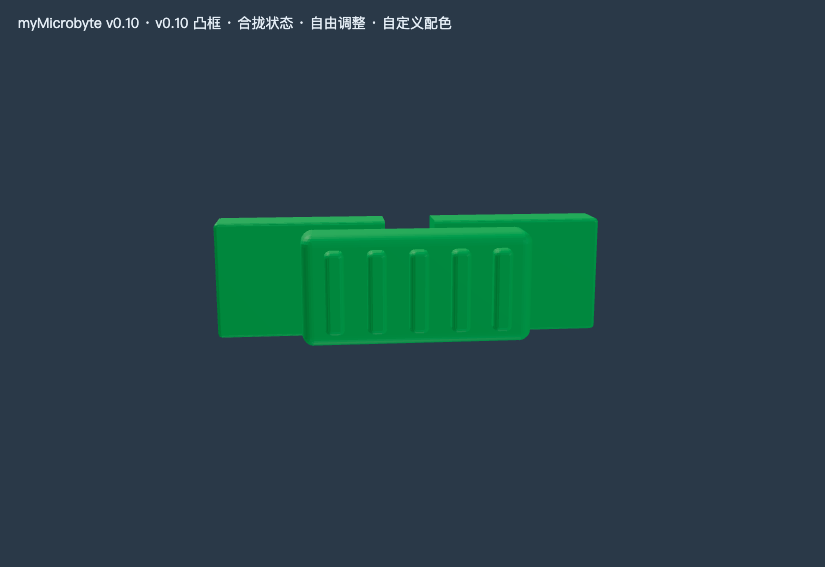
reports/v10/slider_outer.png
