88431844/myMicroByte/reports/v10/slider_seated.png

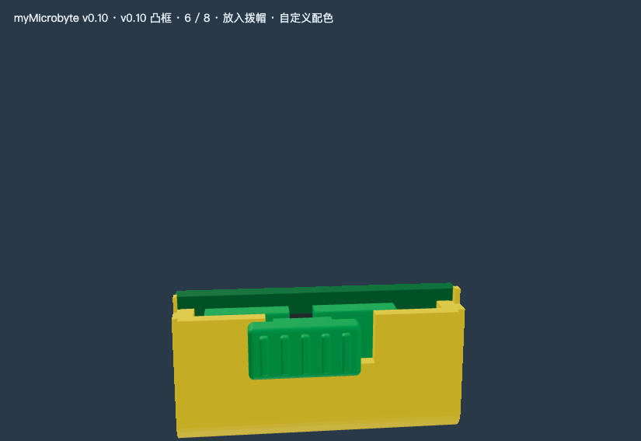
reports/v10/slider_seated.png
