88431844/myMicroByte/reports/v10/top_1.png

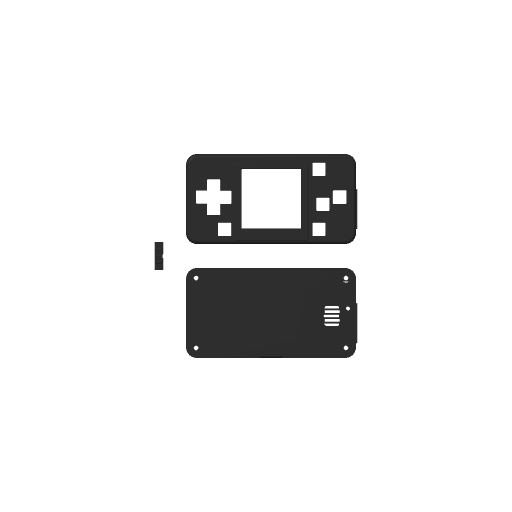
reports/v10/top_1.png
