88431844/myMicroByte/reports/v10_4sets/A1_4sets_started.png

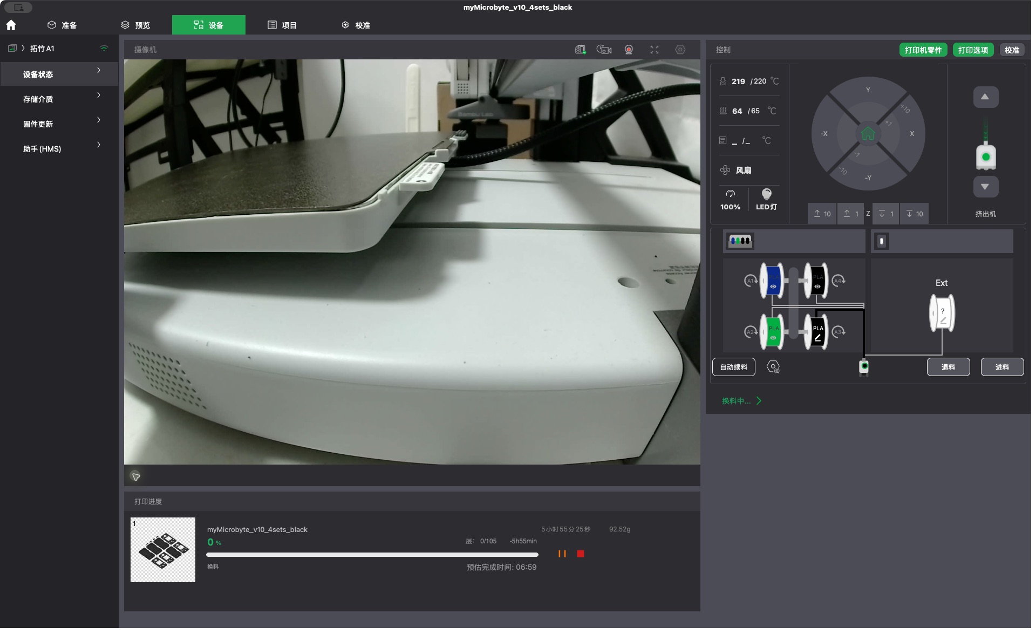
reports/v10_4sets/A1_4sets_started.png
