88431844/myMicroByte/reports/v10_4sets/ams_refill_A3_A4.png

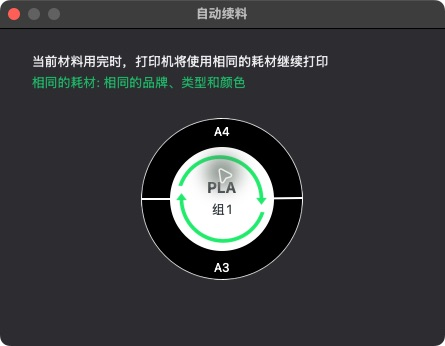
reports/v10_4sets/ams_refill_A3_A4.png
