88431844/myMicroByte/reports/v10_4sets/ams_refill_crop.png

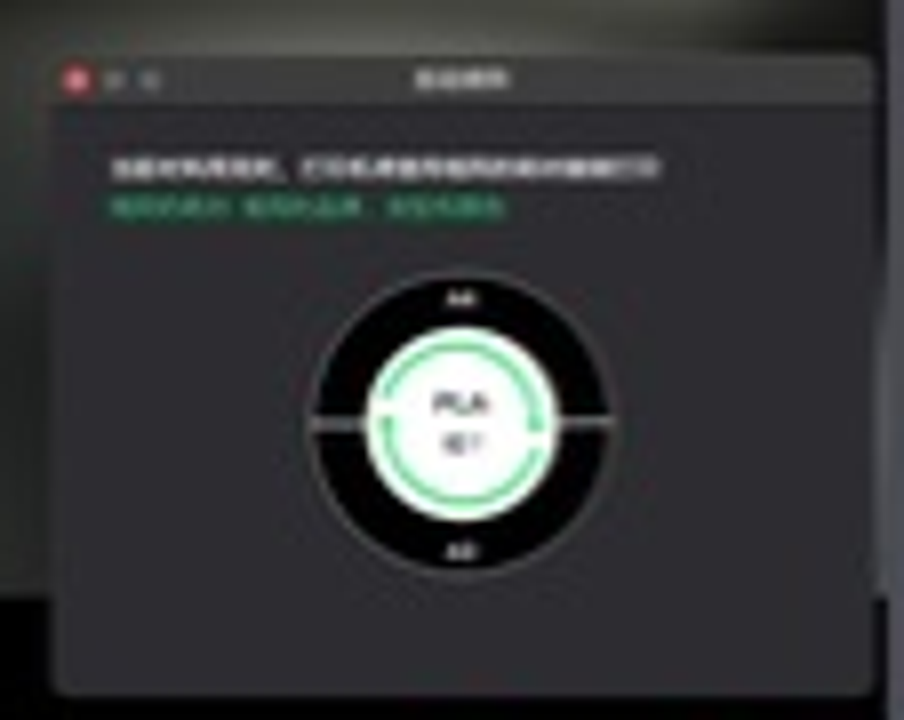
reports/v10_4sets/ams_refill_crop.png
