88431844/myMicroByte/reports/v10_4sets/ams_refill_raw.png

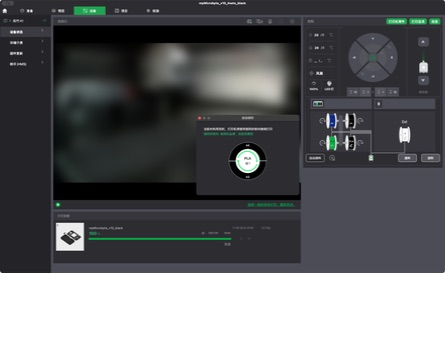
reports/v10_4sets/ams_refill_raw.png
