88431844/myMicroByte/reports/v10_4sets/plate_sliced.png

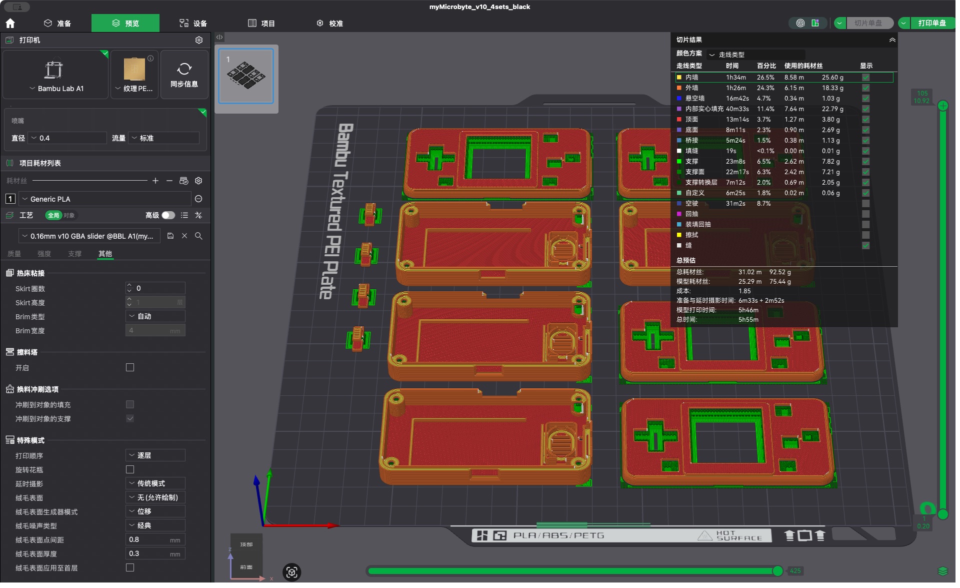
reports/v10_4sets/plate_sliced.png
