88431844/myMicroByte/reports/v10_4sets/send_mapping.png

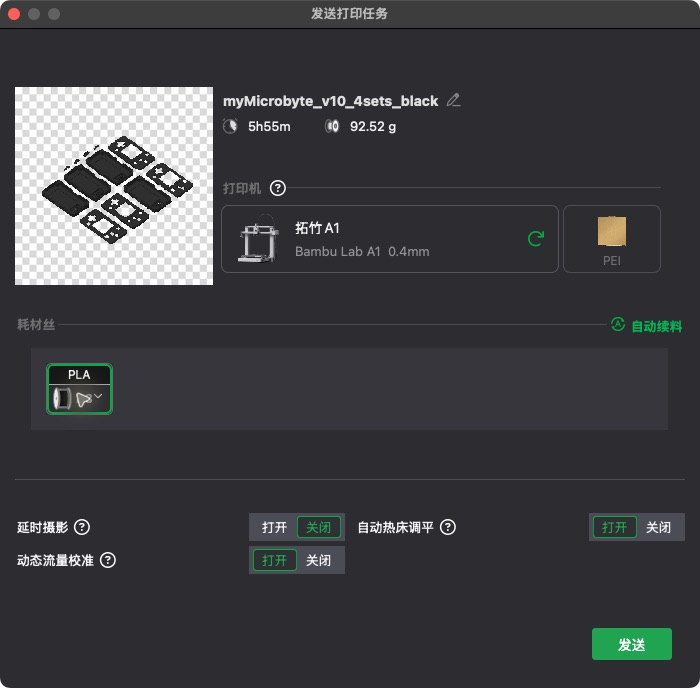
reports/v10_4sets/send_mapping.png
