88431844/myMicroByte/reports/v10_4sets/top_1.png

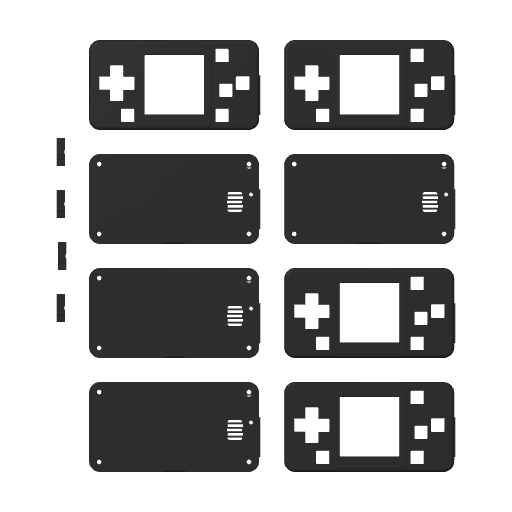
reports/v10_4sets/top_1.png
