88431844/myMicroByte/output/myMicrobyte_fit_coupons.step

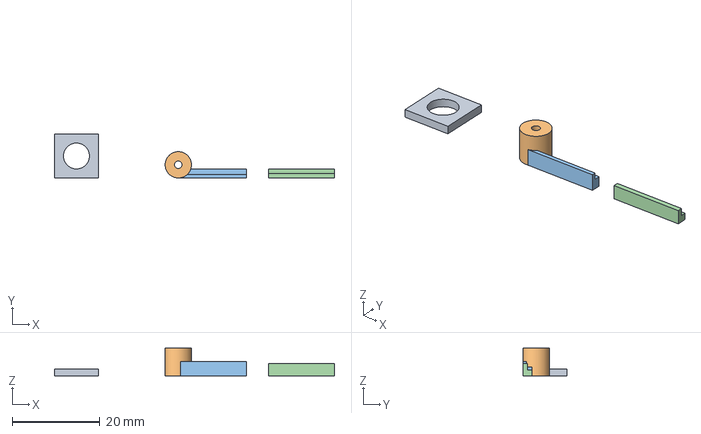
[picture p67: CAD file, 2026-10-29]
output/myMicrobyte_fit_coupons.step
63.7 x 10.0 x 6.30 mm
