88431844/myMicroByte/output/myMicrobyte_FreeCAD_v01_试装包/FrontShell_print.stl

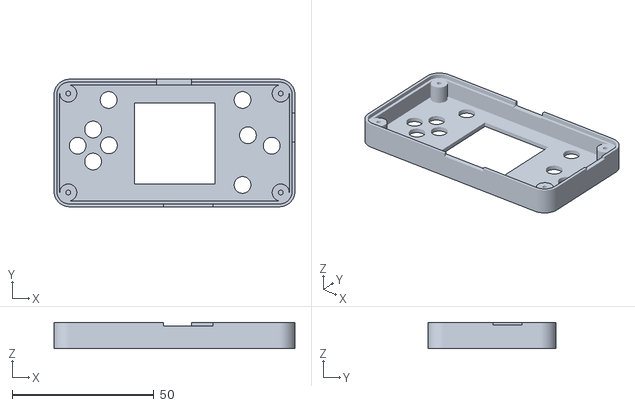
[picture p68: CAD file, 2026-10-29]
output/myMicrobyte_FreeCAD_v01_试装包/FrontShell_print.stl
85.0 x 45.0 x 9.30
