88431844/myMicroByte/output/v08_trials/R2_print.stl

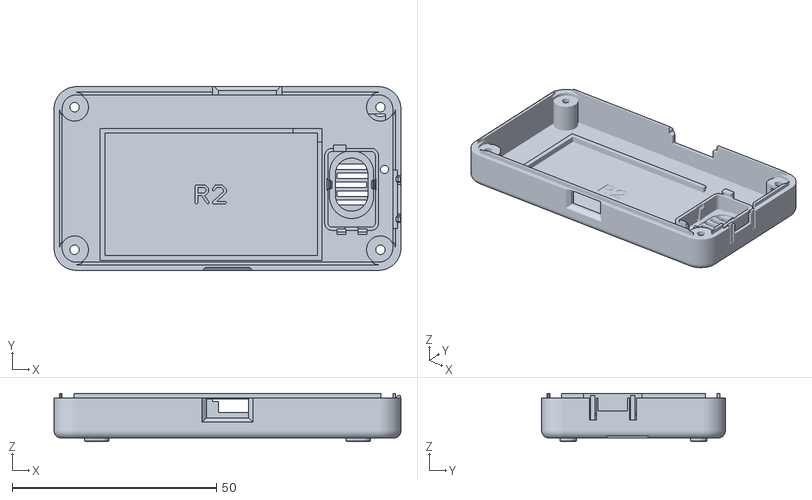
[picture p69: CAD file, 2026-10-29]
output/v08_trials/R2_print.stl
85.0 x 45.0 x 11.8
