88431844/myMicroByte/output/v10/RearShell_print.stl

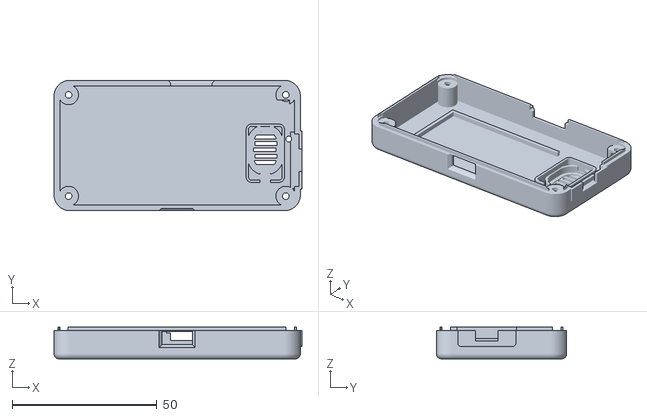
[picture p70: CAD file, 2026-10-29]
output/v10/RearShell_print.stl
85.6 x 45.0 x 10.9
