88431844/myMicroByte/printing/A1_black_green_blue_PLA_v07/AcousticLid_print.stl

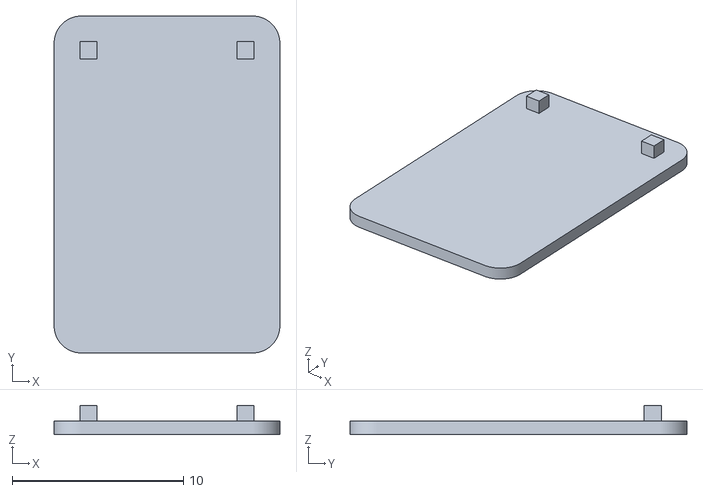
[picture p71: CAD file, 2026-10-29]
printing/A1_black_green_blue_PLA_v07/AcousticLid_print.stl
13.2 x 19.7 x 1.70
