88431844/myMicroByte/printing/A1_black_PLA/myMicrobyte_A1_black_PLA_sliced.3mf

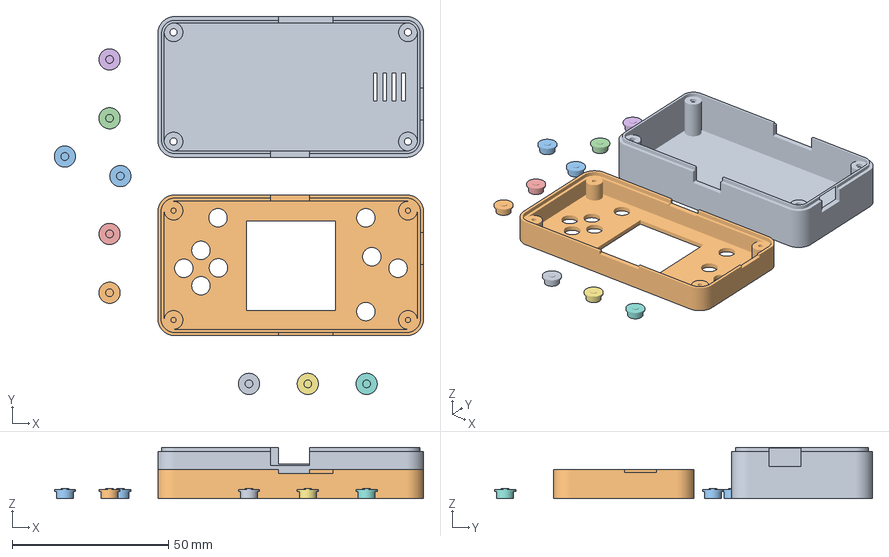
[picture p72: CAD file, 2026-10-29]
printing/A1_black_PLA/myMicrobyte_A1_black_PLA_sliced.3mf
118.1 x 120.8 x 16.3 mm
RearShell_print.stl
FrontShell_print.stl
Cap_A_print.stl
Cap_B_print.stl
Cap_DOWN_print.stl
Cap_LEFT_print.stl
Cap_MENU_print.stl
Cap_RIGHT_print.stl
Cap_SELECT_print.stl
Cap_START_print.stl
Cap_UP_print.stl
