88431844/myMicroByte/printing/A1_black_PLA_v10_4sets/myMicrobyte_v10_4sets_black.3mf

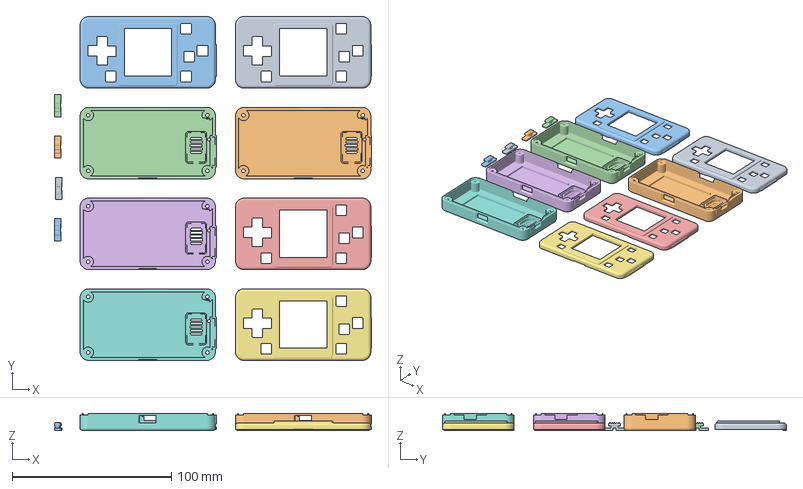
[picture p73: CAD file, 2026-10-29]
printing/A1_black_PLA_v10_4sets/myMicrobyte_v10_4sets_black.3mf
199.3 x 216.0 x 10.9 mm
FrontShell_set1.stl
RearShell_set1.stl
FrontShell_set2.stl
RearShell_set2.stl
FrontShell_set3.stl
RearShell_set3.stl
FrontShell_set4.stl
RearShell_set4.stl
PowerSlider_set1.stl
PowerSlider_set2.stl
PowerSlider_set3.stl
PowerSlider_set4.stl
