88431844/myMicroByte/reference/pcb-current.step

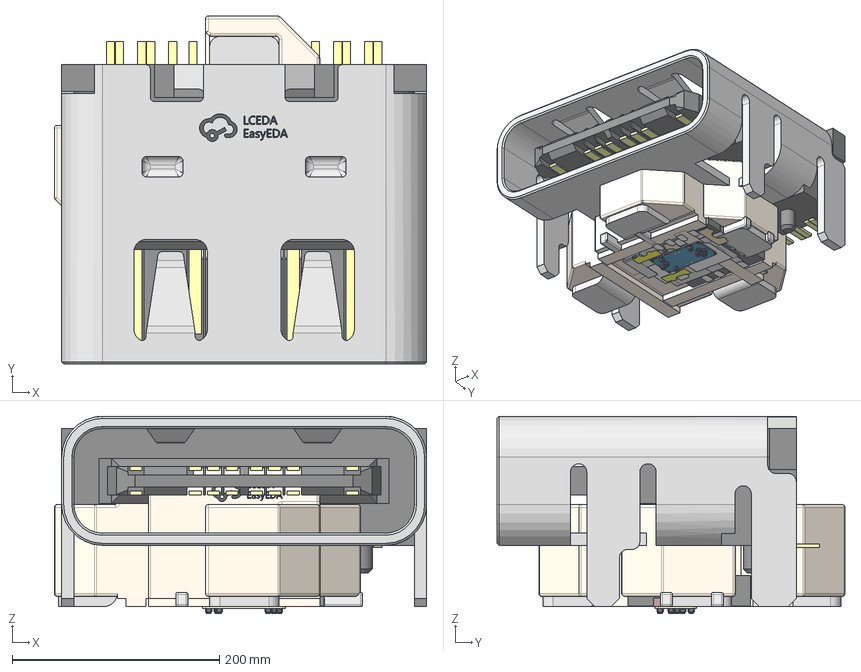
[picture p74: CAD file, 2026-10-29]
reference/pcb-current.step
359.1 x 335.6 x 190.3 mm
Board~27dd
TopCopper~27dd
BottomCopper~27dd
TopSilkscreen~27dd
BottomSilkscreen~27dd
TopFpcStiffener~27dd
BottomFpcStiffener~27dd
SOT-23-6_L2.9-W1.5-P0.95-LS2.6~SOT-23-6_L2.9-W1.6-H1.5-LS2.8-P0.95_1~27dd
SW-SMD_L6.0-W6.0-P6.00-LS6.6~SW-SMD_L6.0-W6.0-H5.0-P6.00-LS6.6~is2e x 9
TF-SMD_TF-115-BCP9~TF-SMD_TF-115-BCP9~Nvgt
C0805~C0805_L2.0-W1.3-H1.3~stp9 x 13
CONN-SMD_2P-P1.25-HC-1.25-2PWT~CONN-SMD_2P-P1.25-HC-1.25-2PWT~20Ll x 2
RES-ARRAY-SMD_0603-8P-L3.2-W1.6-BL~R0603-8P_L3.2-W1.6-H0.6~RCGt x 2
SOT-23-3_L2.9-W1.3-P1.90-LS2.4-BR~SOT-23-3L_L2.9-W1.6-H1.1-LS2.8-P0.95~7ytb x 3
LED0805-RD_RED~LED0805-RD_RED~zX9K
R0805~R0805~lwiO x 14
SW-TH_MSK12C02~SW-SMD_3P-L6.6-W2.7-LS7.8-P1.50~YVRk
SOT-23-5_L3.0-W1.7-P0.95-LS2.8-BR~SOT-23-5_L2.9-W1.6-H1.1-LS2.8-P0.95_1~oH9L
LED0805-RD_GREEN~LED0805-RD_GREEN~Mxs1
TQFN-16_L3.0-W3.0-P0.50-BL-EP1.5~TQFN-16_L3.0-W3.0-P0.50-BL-EP1.5~0Nk4
VFQFPN-24_L4.0-W4.0-P0.50-BL-EP2.8~QFN-24_L4.0-W4.0-TPMS4X41500KPAXZAXIS~orJt
WIFI-SMD_ESP32-WROVER-E-N8R2~WIFI-SMD_ESP32-WROVER-E-N8R2~n2nz
SOP-16_L10.3-W4.6-P1.27-LS6.9-BL~ESOP-16_L9.9-W3.9-P1.27-LS6.0-TR-EP4.0~91qO
USB-C-SMD_G-SWITCH_GT-USB-7010ASV~USB-C-SMD_G-SWITCH_GT-USB-7010ASV~ZtUB
