88431844/myMicroByte/reports/battery_expansion/enlarged_frame_study.FCStd

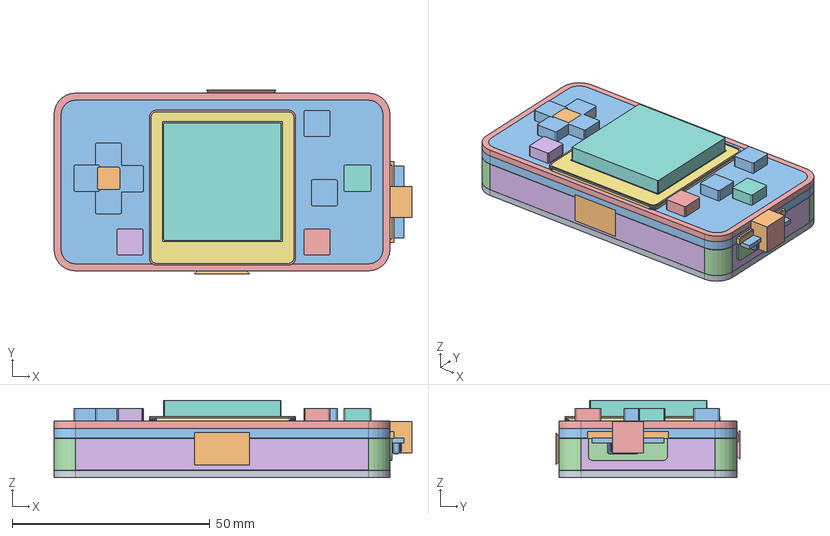
[picture p75: CAD file, 2026-10-29]
reports/battery_expansion/enlarged_frame_study.FCStd
90.5 x 46.6 x 19.6 mm
RearBlank
RearGripRound
RearCavity
RearWallsAndFloor
FrontBlank
FrontGripRound
FrontCavity
FrontWallsAndFace
RearPost0
RearPost1
RearPost2
RearPost3
FrontPost0
FrontPost1
FrontPost2
FrontPost3
TongueOuter
TongueInner
Tongue
TongueReceiver
FrontReceiver
BossTongueRelief0
BossTongueRelief1
BossTongueRelief2
BossTongueRelief3
TongueBossReliefs
TongueBossClearance
RearWithPostsAndTongue
FrontWithInsertBosses
BatteryFrameOuter
BatteryFrameInner
BatteryFrame
BatteryCableRelief
BatteryCableExit
SpeakerContinuousSeat
SpeakerOvalLocator
SpeakerTerminalNotch
SpeakerWireNotch
SpeakerTerminalAndWireNotches
SpeakerOvalWithLeadReliefs
ChamberOuterWall
ChamberWallVoid
ChamberWallRing
AcousticWireExit
ChamberWallWithWireExit
RearWithFramesAndOpenChamber
SpeakerGrille0
SpeakerGrille1
SpeakerGrille2
SpeakerGrille3
SpeakerGrille4
LCDGlassPocket
FrontLCDClearance
LCDLocatorOuter
LCDLocatorInner
LCDFullPerimeterLocator
LCDFlexExit
LCDLocatorFlexRelief
FrontWithPerimeterLCDLocator
TFFrontBrow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
