88431844/myMicroByte/output/myMicrobyte_blackPLA_preview.FCStd

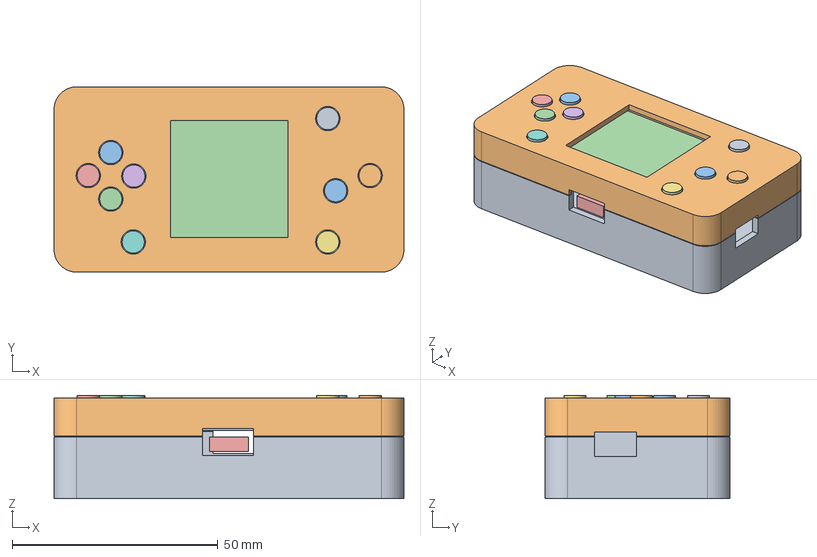
[picture p76: CAD file, 2026-10-29]
output/myMicrobyte_blackPLA_preview.FCStd
85.0 x 45.0 x 25.1 mm
后壳 / Rear shell
前壳 / Front shell
按键帽 UP
按键帽 DOWN
按键帽 LEFT
按键帽 RIGHT
按键帽 START
按键帽 SELECT
按键帽 MENU
按键帽 A
按键帽 B
屏幕占位：高度假定 5 mm
USB 保守占位（绑定模型异常）
