88431844/myMicroByte/output/myMicrobyte_FreeCAD_v01_试装包/Cap_DOWN_print.stl

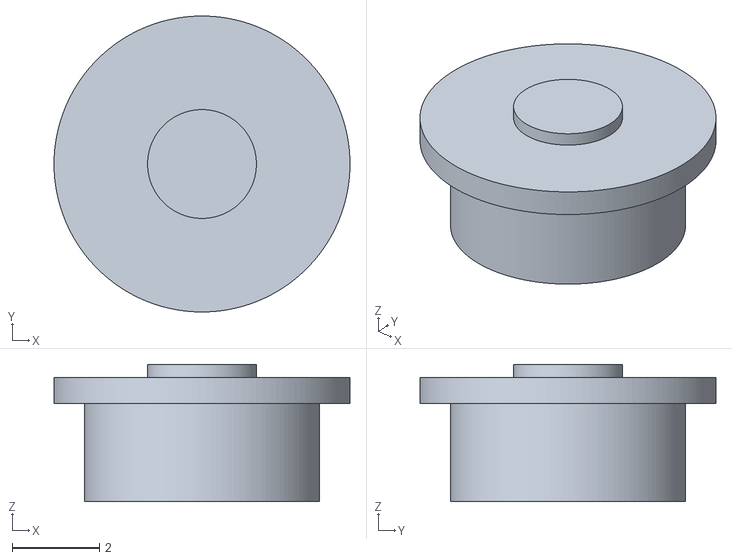
[picture p77: CAD file, 2026-10-29]
output/myMicrobyte_FreeCAD_v01_试装包/Cap_DOWN_print.stl
6.80 x 6.80 x 3.15
