88431844/myMicroByte/output/v08_trials/L1_print.stl

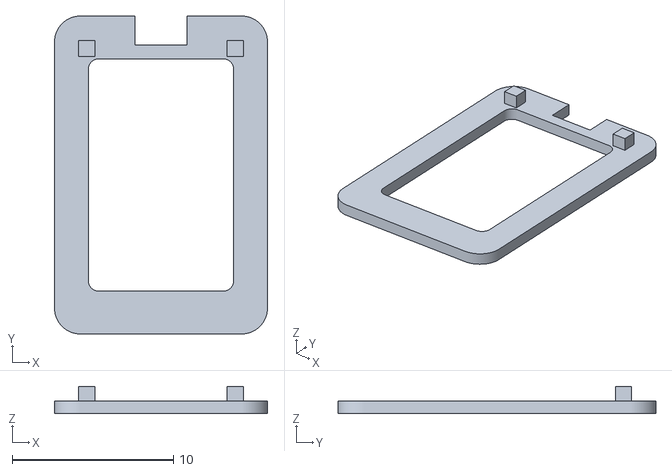
[picture p78: CAD file, 2026-10-29]
output/v08_trials/L1_print.stl
13.2 x 19.7 x 1.70
