88431844/myMicroByte/output/v10/myMicrobyte_enclosure_v10.step

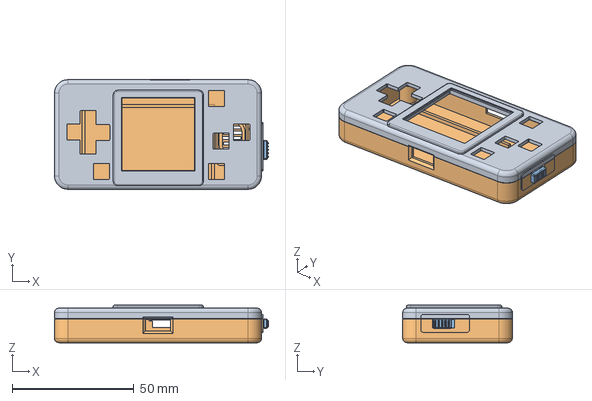
[picture p79: CAD file, 2026-10-29]
output/v10/myMicrobyte_enclosure_v10.step
87.8 x 45.0 x 15.4 mm
