88431844/myMicroByte/printing/A1_black_green_blue_PLA_v07/myMicrobyte_v07_A1_black_green_blue.3mf

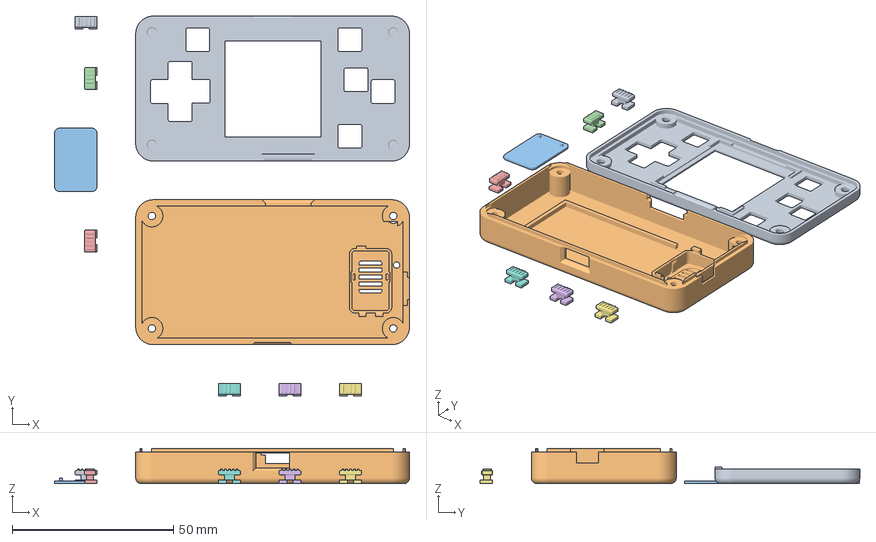
[picture p80: CAD file, 2026-10-29]
printing/A1_black_green_blue_PLA_v07/myMicrobyte_v07_A1_black_green_blue.3mf
110.2 x 117.9 x 10.9 mm
FrontShell_print.stl
RearShell_print.stl
AcousticLid_print.stl
PowerSlider_black_1.stl
PowerSlider_black_2.stl
PowerSlider_green_1.stl
PowerSlider_green_2.stl
PowerSlider_blue_1.stl
PowerSlider_blue_2.stl
