88431844/myMicroByte/printing/A1_black_PLA_v08_trials/S3_print.stl

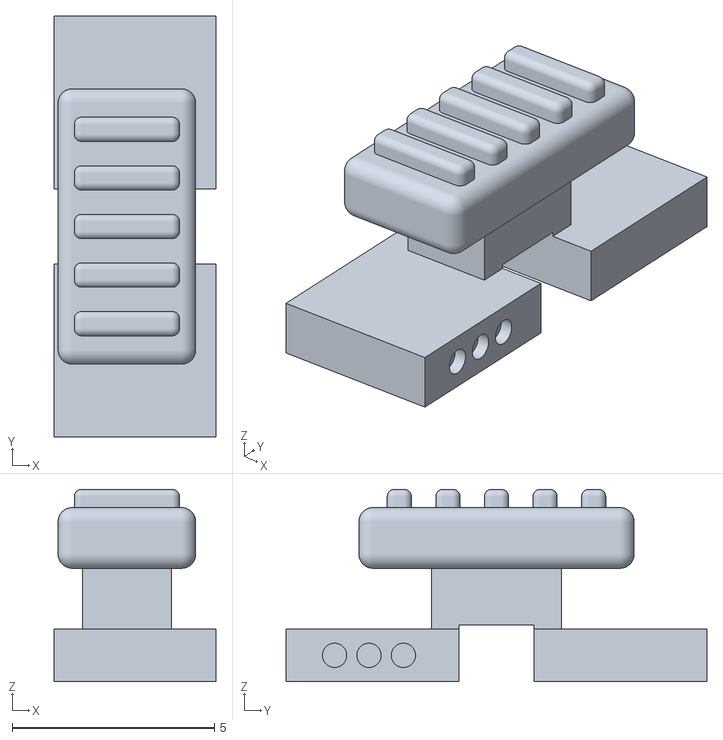
[picture p81: CAD file, 2026-10-29]
printing/A1_black_PLA_v08_trials/S3_print.stl
4.00 x 10.4 x 4.75
