88431844/myMicroByte/printing/A1_black_PLA_v10/myMicrobyte_v10_black.3mf

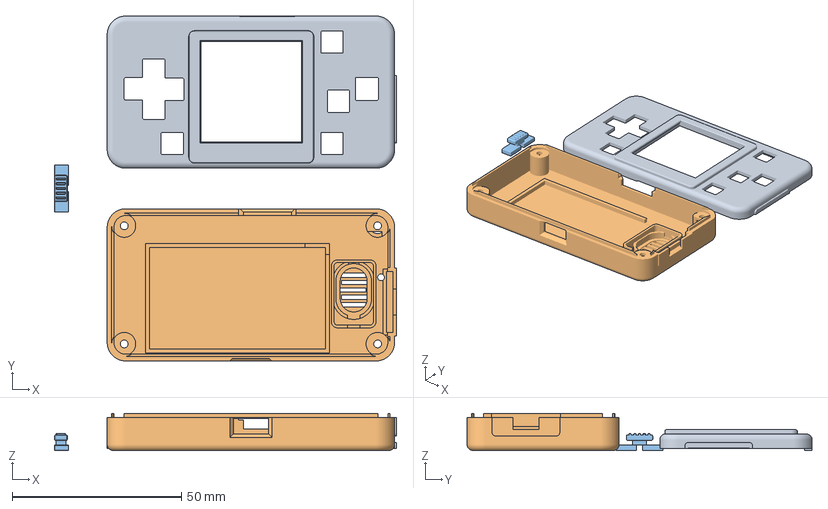
[picture p82: CAD file, 2026-10-29]
printing/A1_black_PLA_v10/myMicrobyte_v10_black.3mf
101.1 x 102.0 x 10.9 mm
FrontShell_print.stl
RearShell_print.stl
PowerSlider_print.stl
