88431844/myMicroByte/output/Fit_ButtonGuide.stl

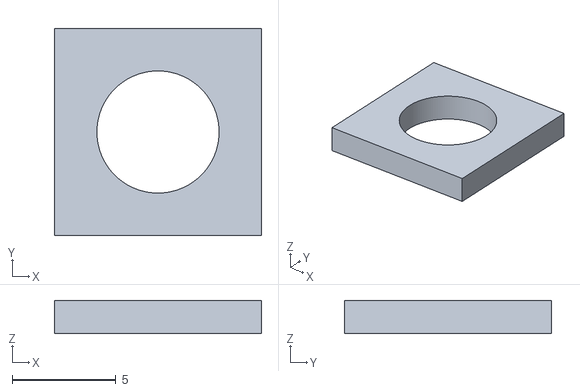
[picture p83: CAD file, 2026-10-29]
output/Fit_ButtonGuide.stl
10.0 x 10.0 x 1.60
