88431844/myMicroByte/output/v08_trials/S2_print.stl

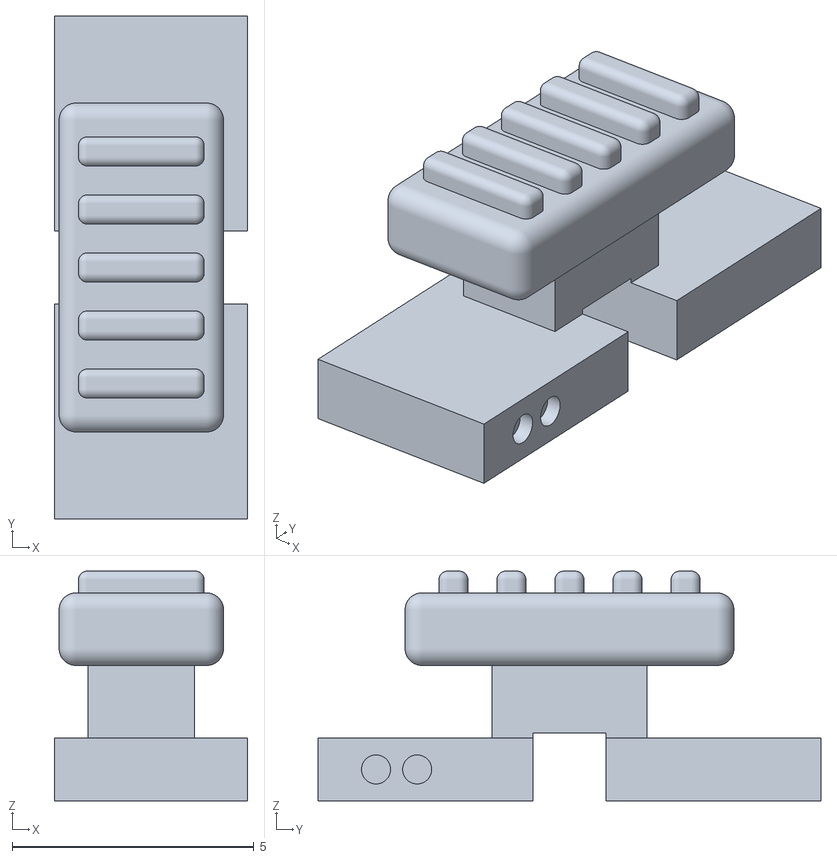
[picture p84: CAD file, 2026-10-29]
output/v08_trials/S2_print.stl
4.00 x 10.4 x 4.75
