88431844/myMicroByte/printing/A1_black_PLA_v08_trials/F3_print.stl

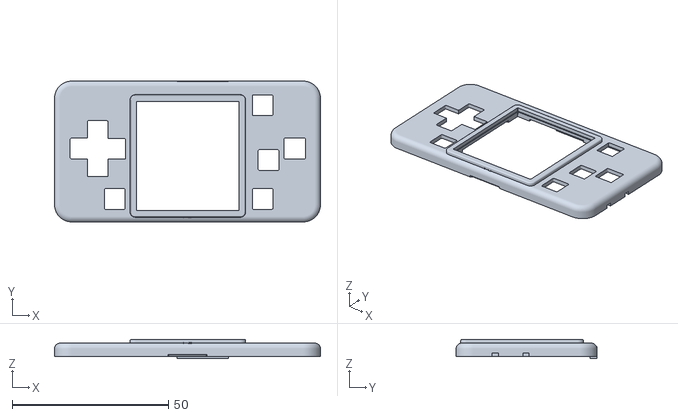
[picture p85: CAD file, 2026-10-29]
printing/A1_black_PLA_v08_trials/F3_print.stl
85.0 x 45.0 x 6.15
