88431844/myMicroByte/printing/A1_black_PLA_v10_4sets/FrontShell_set4.stl

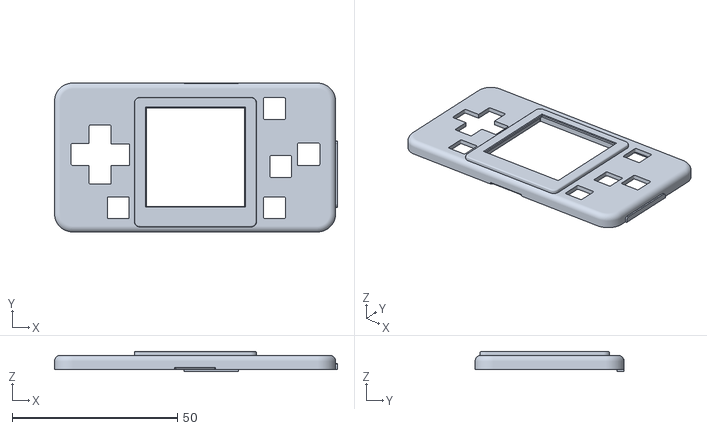
[picture p86: CAD file, 2026-10-29]
printing/A1_black_PLA_v10_4sets/FrontShell_set4.stl
85.6 x 45.0 x 6.15
