88431844/myMicroByte/printing/A1_blue_PLA_expanded_rear_2/myMicrobyte_expanded_rear_2_blue.3mf

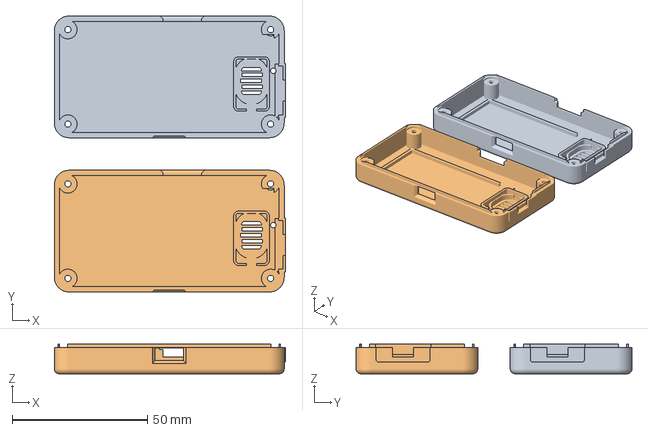
[picture p87: CAD file, 2026-10-29]
printing/A1_blue_PLA_expanded_rear_2/myMicrobyte_expanded_rear_2_blue.3mf
85.6 x 102.0 x 10.9 mm
RearExpanded_1.stl
RearExpanded_2.stl
