88431844/myMicroByte/output/Fit_FrontReceiver.stl

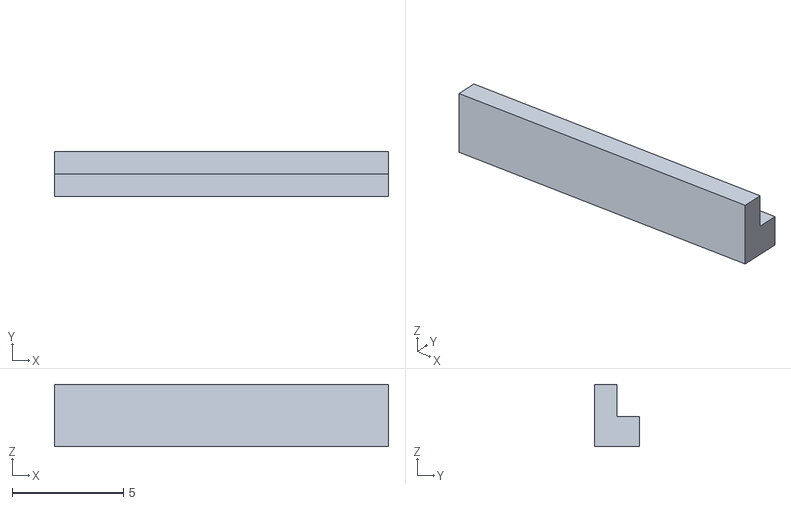
[picture p88: CAD file, 2026-10-29]
output/Fit_FrontReceiver.stl
15.0 x 2.00 x 2.80
