88431844/myMicroByte/output/v08_trials/F1_print.stl

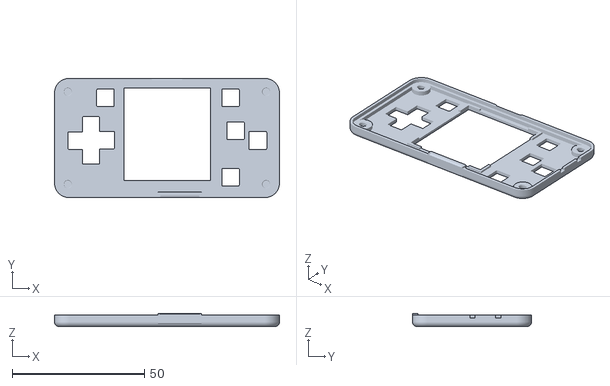
[picture p89: CAD file, 2026-10-29]
output/v08_trials/F1_print.stl
85.0 x 45.0 x 4.95
