88431844/myMicroByte/printing/A1_black_green_blue_PLA_v07/PowerSlider_blue_2.stl

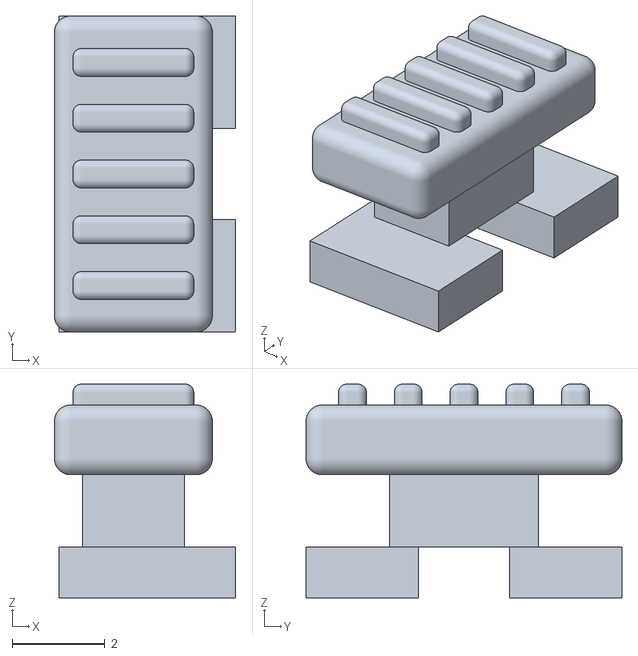
[picture p90: CAD file, 2026-10-29]
printing/A1_black_green_blue_PLA_v07/PowerSlider_blue_2.stl
3.90 x 6.80 x 4.60
