88431844/myMicroByte/printing/A1_black_PLA_v10_4sets/PowerSlider_set3.stl

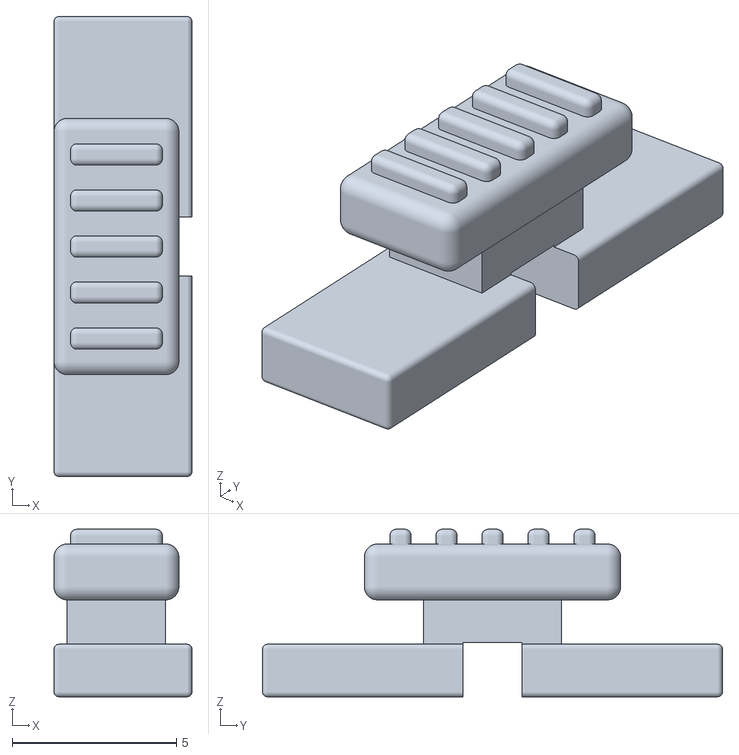
[picture p91: CAD file, 2026-10-29]
printing/A1_black_PLA_v10_4sets/PowerSlider_set3.stl
4.20 x 14.0 x 5.10
