88431844/myMicroByte/printing/A1_black_green_blue_PLA_v07/RearShell_print.stl

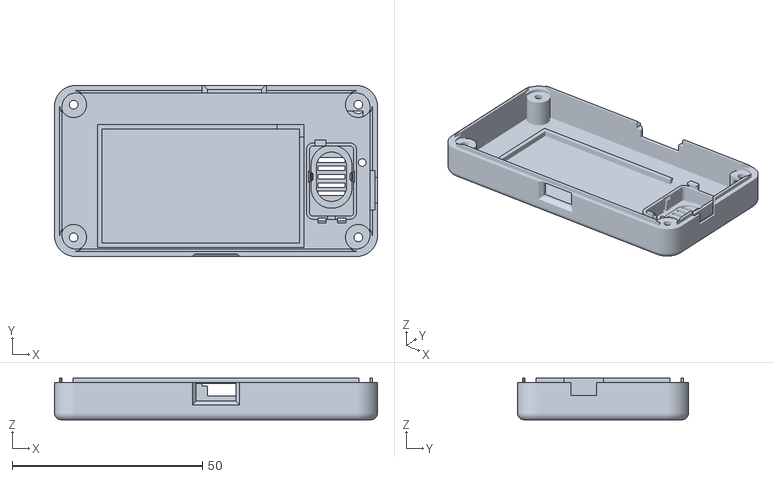
[picture p93: CAD file, 2026-10-29]
printing/A1_black_green_blue_PLA_v07/RearShell_print.stl
85.0 x 45.0 x 10.9
