88431844/myMicroByte/printing/A1_black_PLA_v08_trials/myMicrobyte_v08_trials_black.3mf

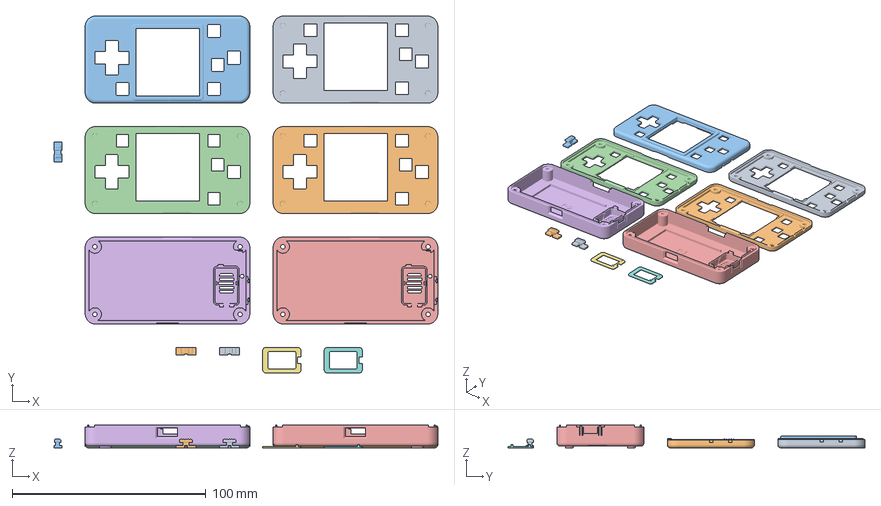
[picture p94: CAD file, 2026-10-29]
printing/A1_black_PLA_v08_trials/myMicrobyte_v08_trials_black.3mf
198.0 x 184.2 x 11.8 mm
F1_print.stl
F2_print.stl
F3_print.stl
F4_print.stl
R1_print.stl
R2_print.stl
L1_print.stl
L2_print.stl
S1_print.stl
S2_print.stl
S3_print.stl
