88431844/myMicroByte/output/myMicrobyte_FreeCAD_v01_试装包/myMicrobyte_enclosure_v01.step

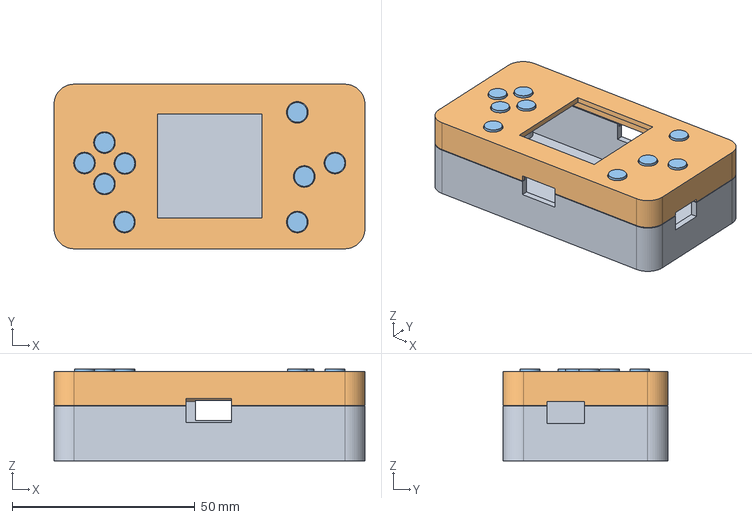
[picture p95: CAD file, 2026-10-29]
output/myMicrobyte_FreeCAD_v01_试装包/myMicrobyte_enclosure_v01.step
85.0 x 45.0 x 25.1 mm
