88431844/myMicroByte/output/RearShell_print.stl

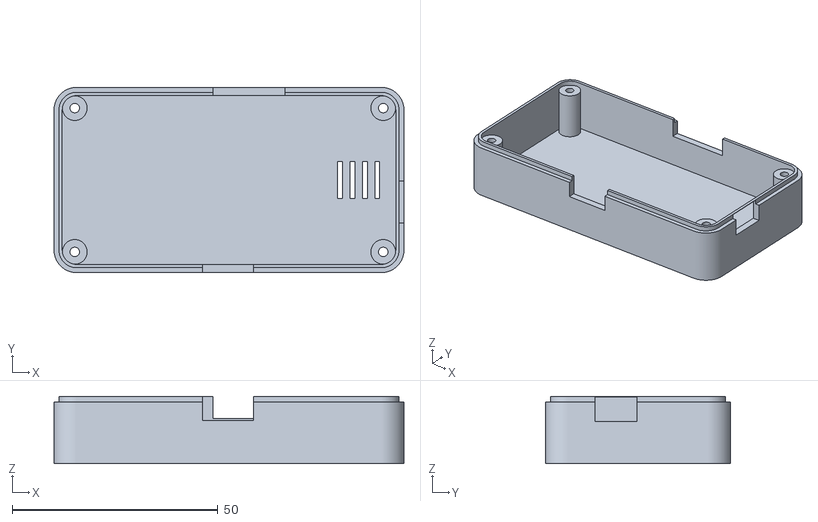
[picture p96: CAD file, 2026-10-29]
output/RearShell_print.stl
85.0 x 45.0 x 16.3
