88431844/myMicroByte/output/v08_trials/myMicrobyte_v08_trials.FCStd

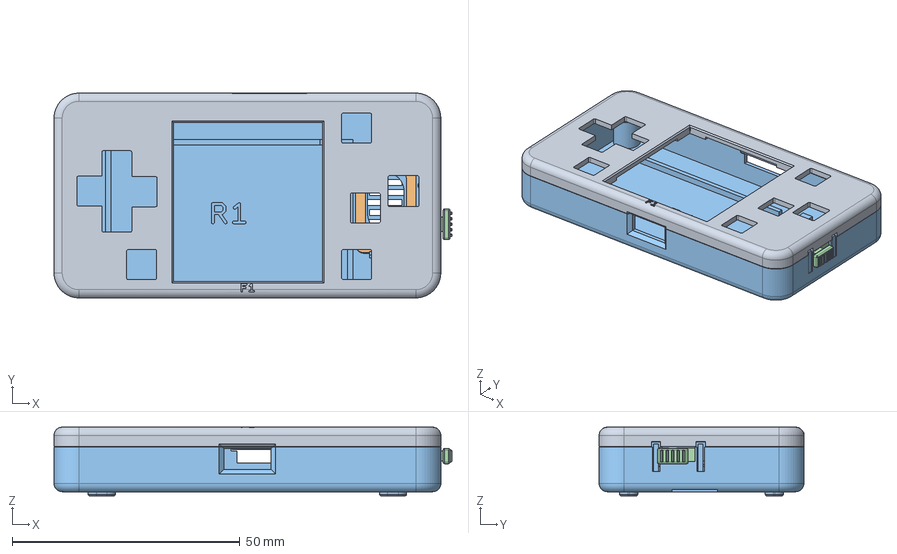
[picture p97: CAD file, 2026-10-29]
output/v08_trials/myMicrobyte_v08_trials.FCStd
87.4 x 45.0 x 15.1 mm
F1 / baseline
L1 / identical open frame
R1 / baseline
S1 / baseline
