88431844/myMicroByte/printing/A1_black_PLA_v08_trials/F2_print.stl

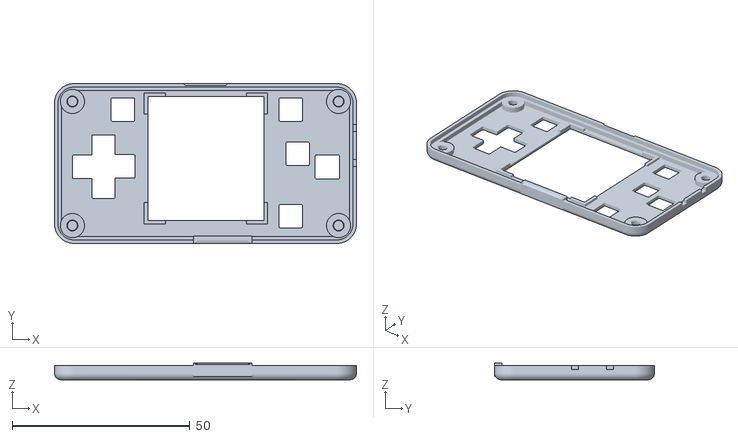
[picture p98: CAD file, 2026-10-29]
printing/A1_black_PLA_v08_trials/F2_print.stl
85.0 x 45.0 x 4.65
