88431844/myMicroByte/output/myMicrobyte_FreeCAD_v01_试装包/Fit_RearTongue.stl

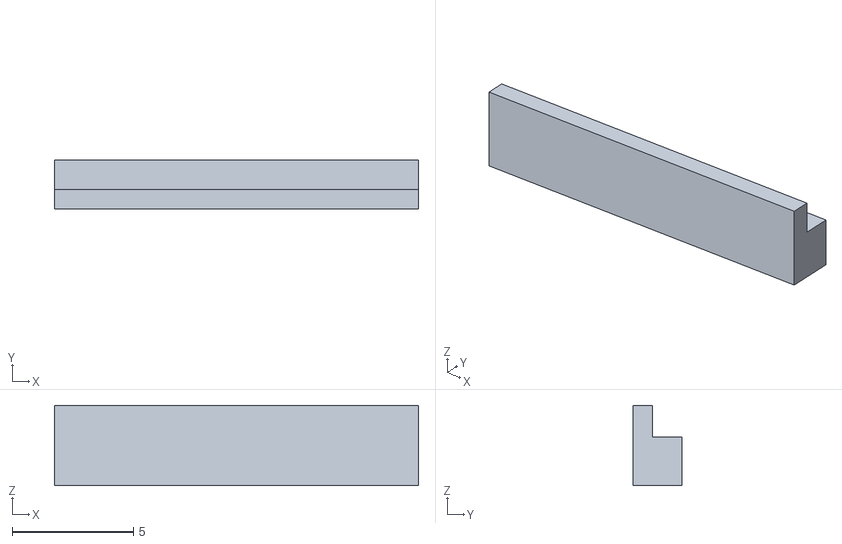
[picture p99: CAD file, 2026-10-29]
output/myMicrobyte_FreeCAD_v01_试装包/Fit_RearTongue.stl
15.0 x 2.00 x 3.30
