88431844/myMicroByte/(list of files, cad)

Other CAD files:
printing/A1_black_PLA_v08_trials/myMicrobyte_v08_trials_black.gcode.3mf
printing/A1_black_PLA_v10/myMicrobyte_v10_black.gcode.3mf
printing/A1_blue_PLA_expanded_rear_2/myMicrobyte_expanded_rear_2_blue.gcode.3mf
printing/A1_black_PLA_v10_4sets/myMicrobyte_v10_4sets_black.gcode.3mf
printing/A1_blue_PLA_expanded_rear_2/RearExpanded_2.stl
output/myMicrobyte_FreeCAD_v01_试装包/Cap_UP_print.stl
printing/A1_black_green_blue_PLA_v07/myMicrobyte_v07_A1_black_green_blue.gcode.3mf
output/myMicrobyte_FreeCAD_v01_试装包/Cap_RIGHT_print.stl
printing/A1_black_PLA_v08_trials/R1_print.stl
output/Cap_LEFT_print.stl
output/myMicrobyte_FreeCAD_v01_试装包/Cap_B_print.stl
output/myMicrobyte_FreeCAD_v01_试装包/Cap_SELECT_print.stl
printing/A1_black_PLA_v08_trials/S1_print.stl
output/myMicrobyte_FreeCAD_v01_试装包/myMicrobyte_fit_coupons.FCStd
output/myMicrobyte_FreeCAD_v01_试装包/Cap_A_print.stl
output/myMicrobyte_FreeCAD_v01_试装包/Cap_MENU_print.stl
output/myMicrobyte_FreeCAD_v01_试装包/Fit_ScrewPilot.stl
output/myMicrobyte_FreeCAD_v01_试装包/myMicrobyte_enclosure_v01.FCStd
output/v02/Cap_A_print.stl
output/v02/Cap_B_print.stl
output/v02/Cap_DOWN_print.stl
output/v02/Cap_LEFT_print.stl
output/v02/Cap_MENU_print.stl
output/v02/Cap_RIGHT_print.stl
output/v02/Cap_SELECT_print.stl
output/v02/Cap_UP_print.stl
output/v02/FrontShell_print.stl
output/v02/RearShell_print.stl
output/v02/myMicrobyte_enclosure_v02.FCStd
output/v02/myMicrobyte_enclosure_v02.step
output/v03/Cap_A_print.stl
output/v03/Cap_B_print.stl
output/v03/Cap_DOWN_print.stl
output/v03/Cap_LEFT_print.stl
output/v03/Cap_MENU_print.stl
output/v03/Cap_RIGHT_print.stl
output/v03/Cap_SELECT_print.stl
output/v03/Cap_START_print.stl
output/v03/Cap_UP_print.stl
output/v03/FrontShell_print.stl
output/v03/PowerSlider_print.stl
output/v03/RearShell_print.stl
output/v03/myMicrobyte_enclosure_v03.FCStd
output/v03/myMicrobyte_enclosure_v03.step
output/v04/FrontShell_print.stl
output/v04/PowerSlider_print.stl
output/v04/RearShell_print.stl
output/v04/myMicrobyte_enclosure_v04.FCStd
output/v04/myMicrobyte_enclosure_v04.step
output/v05/RearShell_print.stl
output/v05/myMicrobyte_enclosure_v05.FCStd
output/v05/myMicrobyte_enclosure_v05.step
output/v06/AcousticLid_print.stl
output/v06/RearShell_print.stl
output/v06/myMicrobyte_enclosure_v06.FCStd
output/v06/myMicrobyte_enclosure_v06.step
output/v07/FrontShell_print.stl
output/v07/myMicrobyte_enclosure_v07.FCStd
output/v07/myMicrobyte_enclosure_v07.step
output/v08/AcousticLid_print.stl
output/v08/FrontShell_A_raised_print.stl
output/v08/FrontShell_B_flat_print.stl
output/v08/PowerSlider_print.stl
output/v08/RearShell_print.stl
output/v08/myMicrobyte_enclosure_v08.FCStd
output/v08/myMicrobyte_v08_A_raised.step
output/v08/myMicrobyte_v08_B_flat.step
output/v09/FrontShell_print.stl
output/v09/PowerSlider_print.stl
output/v09/RearShell_print.stl
output/v09/SliderKeeper_print.stl
output/v09/myMicrobyte_enclosure_v09.FCStd
output/v09/myMicrobyte_enclosure_v09.step
output/v10/myMicrobyte_enclosure_v10.FCStd
printing/A1_black_PLA_v02/myMicrobyte_v02_A1_black_PLA_sliced.3mf
printing/A1_black_PLA_v03/myMicrobyte_v03_A1_black_PLA_sliced.3mf
printing/A1_black_PLA_v04/myMicrobyte_v04_A1_black_PLA_sliced.3mf
