88431844/myMicroByte/printing/A1_blue_PLA_expanded_rear_2/README.md

# 扩容后盖 × 2 / A1 蓝色 PLA

用户于 2026-10-22 授权打印两个后盖，槽位 1 蓝色 PLA。按当前讨论的扩容方案制作。

- 来源：reports/battery_expansion/enlarged_frame_study.FCStd，RearShell_v10 实体。
- 电池框内尺寸：57×32 mm；建议成品电池上限：56×31×3.3 mm。
- 两个同款后盖，同盘；外侧面向下，内侧朝上。
- A1 0.4 mm 喷嘴，纹理 PEI，Generic PLA，0.16 mm 层高，4 层墙，20% gyroid；仅打印板支撑。
- 预计 5883 秒（1小时38分03秒），25.35 g。
- 发送窗口已确认映射 A1 蓝色 PLA，自动热床调平开启，动态流量校准开启，延时摄影关闭。
- 摄像头已确认打印板空；先前四套黑色任务显示100%完成。
- 本任务只成功提交一次，具体运行状态见 print_followup_state.json。

模型验证：reports/expanded_rear_2/model_validation.json
切片验证：reports/expanded_rear_2/slice_validation.json
