88431844/myMicroByte/output/assembly-guide/使用说明.md

# myMicrobyte v0.3 装配工作台

用浏览器打开本目录的 `index.html`。模型和显示库均已内嵌，可离线使用，无需安装程序或运行服务器。建议使用新版 Chrome、Edge 或 Safari。

## 对照实物装配

选择“按步骤装配”，从第 1 步开始。页面按以下顺序显示有关零件，并自动切换观察角度：

清理打印件 → 热熔螺母 → 九个按键帽 → PCB → 电源拨帽 → 喇叭与电池 → 合盖 → M2×5 螺丝 → 试装检查。

点击“装入本步”演示运动，或拖动“本步装入”滑条观察中间位置。完成实物检查后可自行勾选“实物已完成本步检查”；播放动画不会自动勾选。

鼠标拖动旋转，滚轮缩放，右键拖动平移；触屏单指旋转、双指缩放和平移。上方可以切换正面、内侧、底面和开关侧视角。需要重新看到整个模型时点“居中”。

## 记录修改意见

选择“自由调整”，点击模型上的零件或用下拉框选中零件。

- “分解程度”仅展开模型；“合拢模型”收起分解，但保留你设置的零件偏移。
- “后盖内部”显示后盖、电池和喇叭；点“显示全部”恢复全部零件。
- X/Y/Z 可按 0.1 mm 步进填写位置偏移。X 为长边、Y 为短边、Z 为厚度方向。PCB、屏幕及板载元件作为一个整体移动。
- 在“试装备注”记录卡涩、孔位、接缝等问题。“还原此零件”只清除该零件的位置偏移，保留备注。
- “零件显隐”可以分别控制 17 组零件。“按键与拨帽行程”提供九键 0～0.6 mm 和拨帽 0～1.8 mm 的运动展示。
- “保存视图”下载当前 3D 模型的 PNG 图片。“导出调整记录”下载 JSON，包含位置偏移、备注、显隐和检查进度；可再通过“导入记录”恢复。

调整会自动保存在当前浏览器。更换浏览器、清除网站数据或移动 HTML 文件可能导致本地记录不可用，请用导出功能保留重要记录。

## 模型范围

本页使用已打印的 FreeCAD v0.3 实际网格：12 个打印件，加 PCB、元件、屏幕、电池、喇叭和紧固件参考模型，共 59 个实体。

网页中的位置调整用于表达修改意图，不重建 CAD、开孔、导槽或打印尺寸，也不执行干涉检测。装配步骤始终演示原始设计位置，自由调整的偏移单独保存。装配动画只表示方向，不模拟完整手部操作、螺丝旋入或热熔过程。

503550 电池标称 50 × 35 × 5 mm，定位框净空 57 × 37 mm。屏幕、电池包装、部分接口和连接器为参考包络；实际插头、走线和电气开关端点仍需实物检查。

FreeCAD 源文件：`../v03/myMicrobyte_enclosure_v03.FCStd`。

## 页面源文件

`src/page.html`、`src/style.css`、`src/app.js` 为可维护源码。修改后在项目目录运行 `python3 output/assembly-guide/build.py` 可重建单文件页面；打包时使用 `reports/v03/preview_meshes.b64`。

显示库使用 Three.js 0.160.1，MIT 许可证见 `vendor/LICENSE-three.txt`。页面不上传模型或调整记录。
