88431844/myMicroByte/printing/A1_black_green_blue_PLA_v07/打印跟进.md

# v0.7 三色同盘

已获得用户直接打印授权。共 9 件，黑前后盖及音腔盖各 1 件；黑、绿、蓝拨帽各 2 件。任务已在 A1 上开始准备。

估时 3 小时 17 分钟，41.33 g。使用 A4 黑 PLA、A2 绿 PLA、A1 蓝 PLA。模型及 G-code 已校验，热床摄像头已确认空。

当前状态记录在 `print_followup_state.json`。严禁因本地状态过时重复发送任务；后续必须先读设备实际状态。
