88431844/myMicroByte/printing/A1_black_PLA/打印说明.md

# myMicrobyte 黑色 PLA 试打印

使用 `myMicrobyte_A1_black_PLA_sliced.3mf`，包含前后壳和九个按键帽，共 11 件，已经按打印方向放置在一块板上。无需整体缩放。

- 目标打印机：Bambu Lab A1，标准流量 0.4 mm 喷嘴。
- 耗材：Generic PLA，黑色；实际品牌未确认，若使用对应品牌专用配置，需要重新切片。
- 打印板：纹理 PEI 板。
- 层高：0.20 mm；四圈外壁；20% 螺旋体（gyroid）填充。
- 普通自动支撑，仅在打印板生成；自动裙边，宽度 4 mm。
- CLI 切片预计：1 小时 4 分 11 秒，28.95 g，9.71 m；GUI 最终复核：总计约 1 小时 12 分钟（含准备/延时摄影估算），28.93 g，其中支撑约 1.00 g；实际时间会变化。

已验证项目压缩包完整、11 件均未跳过、均在打印范围内；项目在本机 Bambu Studio 重新打开后，四圈外壁、20% 螺旋体及支撑设置得到保留。项目仅在本机切片，尚未发送到打印机。

设备界面显示 A1 在线，上个任务完成，喷嘴和热床目标温度均为 0；AMS A4 显示黑色 PLA。未通过摄像头确认打印板是否清空，也未确认实际安装喷嘴，发送前须核对。打印时将项目耗材映射至实际黑色 PLA 槽位。

这是 v0.1 试装原型。电池暂按 50×30×6 mm，LCD 高度暂按 PCB 按键面上方 5 mm，扬声器无专用固定座。实测后需要修订，当前试打印主要用于检查外观、握持、板孔、止口及按键手感。

冷却后取件，先去除支撑及孔内毛边。按键帽从前壳内部装入，防脱凸缘留在壳内。先不装电池验证按键能自由回弹和 PCB 不受挤压。固定螺钉规格及装配顺序见工作区 `output/README_试装说明.md`。

`../build_a1_project.py` 可以从已有 STL 重建项目。脚本处理了 Bambu CLI 未填写预设差异列表导致 GUI 恢复系统默认参数的问题；如手工修改切片配置，修改后须重新切片。
