88431844/myMicroByte/output/assembly-guide-v10/index.html

＋

myMicrobyte / v0.10

# 装配工作台

85.55 × 45 mm · 实物反馈修订导出调整记录导入记录

视角 音腔爆炸图整机爆炸图居中后盖内部拨帽装入高度侧视平整后盖屏幕限位框合盖限位拨帽单件导轨剖视保存视图

v0.10 原始装配

正在展开 3D 模型…

拖动旋转 · 滚轮缩放 · 右键平移X 长边 / Y 短边 / Z 厚度

外壳半透明零件标注

当前零件前盖

v0.10 · 保留 F3 凸框与按键孔，整圈屏幕限位，新增 GBA 式拨帽，喇叭改用自带胶。先看图，尚未打印。

## v0.10 · GBA 式拨帽

待你审阅 · 未打印

沿用你喜欢的 F3 按键孔、凸框轮廓和正面朝上的打印方向。

拨帽挡边 | 14 × 4.2 × 1.6 mm
滑动间隙 | 单边 0.20 mm（待试装）
前盖整体限位厚度 | 1.70 mm
显示窗口 | 29.72 × 29.72 mm
屏幕框高出按键区 | 1.2 mm
按键名义露出 | 1.4 mm
玻璃侧向留空 | 每边 0.5 mm
玻璃上方名义留空 | 约 1.05 mm

内侧框围住整块玻璃，遮边悬空、不压玻璃。屏幕仍由原有胶层固定在 PCB；约 1 mm 胶层是假定值，需实物黑屏检查。

拨帽改用14 mm宽挡边，1.8 mm叉口；后盖敞口导轨配合前盖整体限位面，合盖防脱。无需独立压条。音腔后盖、三个爪和两侧弹片均取消，使用喇叭自带环形双面胶。

恢复平整背面，去掉矮脚及外侧浅槽；平放桌面仍可能遮住声孔。矩形围壁保留，但背部开放，不是密闭音腔。

## 外壳配色

所有视图通用

配色方案

前盖后盖拨帽

透明 PETG 按磨砂透光示意；照片与屏幕颜色不等同实物色差。静音开关保留原色。

现有耗材与槽位

- 银色 PLA：备用 1 卷
- 黑色 PLA：当前槽 4
- 红色 PLA：备用 1 卷
- 黄色 PLA：备用 1 卷
- 蓝色 PLA：当前槽 1
- 绿色 PLA：当前槽 2
- 白色 PETG：2 卷
- 灰色 PETG：2 卷
- 黑色 PETG：2 卷
- 透明 PETG：3 卷；当前槽 3

按步骤装配自由调整

## 跟着模型装配

装配步骤

本步装入0%

装入本步拆出

实物已完成本步检查

← 上一步下一步 →

步骤演示使用原始装配位置。自由调整中的偏移单独保留；动画表示装配方向，不模拟手部动作或热熔过程。

## 查看装配关系

合拢模型

分解程度 35%

显示全部单独查看选中件

选中零件

### 位置微调

相对原始位置 · mm

XYZ

还原此零件原始位置

试装备注

偏移用于表达调整意图，不会改动 CAD、开孔或打印尺寸，也不执行干涉检查。

电源拨帽行程

九键下压 0.0 mm电源拨帽 0.0 mm

机械活动范围 3.6 mm（相对图中位置 −0.55～+3.05 mm）。实际电气两档仍需实物确认。

零件显隐

F3 凸框基础 · 整圈限位 · 一体导轨拨帽 · 喇叭自带胶 · 本轮尚未打印调整记录保存在本机浏览器
