88431844/myMicroByte/output/assembly-guide/index.html

＋

myMicrobyte / v0.3

# 装配工作台

85 × 45 × 21.9 mm导出调整记录导入记录

视角 居中后盖内部保存视图

v0.3 原始装配

正在展开 3D 模型…

拖动旋转 · 滚轮缩放 · 右键平移X 长边 / Y 短边 / Z 厚度

外壳半透明零件标注

当前零件前盖

模型来自已打印的 FreeCAD v0.3；屏幕、电池与部分接口为参考包络。

按步骤装配自由调整

## 跟着模型装配

装配步骤

本步装入0%

装入本步拆出

实物已完成本步检查

← 上一步下一步 →

步骤演示使用原始装配位置。自由调整中的偏移单独保留；动画表示装配方向，不模拟手部动作或热熔过程。

## 查看装配关系

合拢模型

分解程度 35%

显示全部单独查看选中件

选中零件

### 位置微调

相对原始位置 · mm

XYZ

还原此零件原始位置

试装备注

偏移用于表达调整意图，不会改动 CAD、开孔或打印尺寸，也不执行干涉检查。

按键与拨帽行程

九键下压 0.0 mm电源拨帽 0.0 mm

拨帽演示 0～1.8 mm。实际两个电气档位仍需实物确认。

零件显隐

12 件打印件 · 503550 电池 · M2×5 螺丝调整记录保存在本机浏览器
