88431844/myMicroByte/printing/A1_black_PLA_v10_4sets/README.md

# v0.10 四套同盘打印

2026-10-20，按用户要求发送到拓竹 A1。前盖4件、后盖4件、拨帽4件，共12件，一盘打印；全部黑色PLA。保持v0.10模型，不改几何或缩放，前盖外表面朝上，后盖内侧朝上，拨帽纹路朝上。

0.4 mm喷嘴，0.16 mm层高，4圈墙，20%螺旋体填充，自动裙边，逐层打印，支撑仅接触热床。GUI最终切片预计5小时55分25秒，92.52 g（31.02 m）。

发送主槽A3；发送窗口自动续料图已确认A3与A4同属黑色PLA组1。开启自动调平及动态流量校准，关闭延时摄影。已在发送前通过摄像机确认热床空闲无零件。

校验：12件均未跳过，只有一盘，无超界，各物体包围框分离，全部使用工具0、黑色PLA，G-code MD5一致。最终发送切片myMicrobyte_v10_4sets_black.gcode.3mf的SHA256为eeb84d6293ef40b64297f2180368be4bf091860660d83e63fee993679a8c7652。

已发送一次，勿重复发送。实时状态见print_followup_state.json，证据图和校验见../../reports/v10_4sets/。
