88431844/myMicroByte/printing/A1_black_PLA_v02/打印说明_v02.md

# v0.2 A1 黑色 PLA 试打印

打开本目录 `myMicrobyte_v02_A1_black_PLA_sliced.3mf`，共一板：前壳、后壳、九个按键帽。请使用带 **v02** 的新版项目，包含电池矩形框、1510喇叭座、凸耳避让及低屏幕窗口内圈。

目标配置：Bambu Lab A1，标准流量0.4 mm喷嘴，Generic PLA黑色，纹理PEI板；0.20 mm层高、四圈外壁、20%螺旋体填充、普通自动支撑且仅在打印板生成、自动裙边4 mm。已安排打印方向，不要整体缩放。

本机CLI切片预计 **68分36秒、30.84克**（约31克）。设备准备、校准及延时摄影可能增加时间。前后壳内腔向上；前壳外观面向下，屏幕内圈朝上；按键帽手指面向下，凸缘下方带支撑。

项目压缩包、11件对象、打印板范围、支撑以及关键配置已核验。预设差异标记已写入项目，以保留四圈外壁、20%填充和支撑。最终发送前在GUI核对实际喷嘴、打印板、PLA品牌及耗材槽位。若改用耗材品牌专用配置，需要重新切片。

本次没有发送打印任务。确认热床清空后再打印；此前设备界面A4显示黑色PLA，但应以发送时状态为准。

冷却取件后先清除支撑与孔内毛边。先空壳装PCB和按键检查孔位、回弹及止口，再装喇叭和电池。电池成品选型包络56×36×6 mm，框净空57×37 mm；胶粘在后壳内侧，不能用螺钉或扣钩压电池。屏幕按1.9+0.1 mm胶层，喇叭按15×10×3.5 mm。

端子/插头为保守占位；胶层、公差、实物线材和小凸耳仍需试装。完整说明在工作区 `output/v02/README_v02.md`。
