88431844/myMicroByte/printing/A1_black_PLA_v03/打印跟进.md

# v0.3 打印跟进

用户已授权先看本聊天的交互装配预览，确认后打印；预览后约一小时仍未确认，则自动按上次方式用 A1 黑色 PLA 一盘打印。用户选择电池 503550。v0.3 已完成打印，设备显示 100%、122/122 层；自动跟进已暂停。不得再次发送本次作业。

唯一待发送项目：`myMicrobyte_v03_A1_black_PLA_sliced.3mf`，SHA-256 为 `afbe2021f879c4701a34e02e1c48ebed22499b2a08cef5abcc2ef4a38a7c404f`。该文件位于本目录，12 件、1 盘、A1 0.4 mm 喷嘴、0.2 mm 层高、4 圈墙、20% gyroid、普通自动支撑仅打印板、4 mm 自动裙边。切片模型时间 3892 秒，26.92 克。GUI 校准与准备时间另加。

每次行动先读取最新用户反馈和 `print_followup_state.json`、`../../reports/v03/print_project_validation_v03.json`。若用户修改或撤回，则停止发送旧文件并处理新反馈。若用户提前明确批准本版，可以立即打印；否则确认本聊天最终回复确实展示了 v0.3 交互装配预览，并等待至少 60 分钟且不早于状态文件中的时间。不得把本轮中的进度更新当成正式预览展示。

通过本机 Bambu Studio 检查 A1 空闲、当前板面清空、0.4 mm 喷嘴与黑色 PLA 映射。上次黑色 PLA 为 AMS A4，必须以本次实际状态为准。其他任务或用户正在打印时等待，不打断。板面被占用或无法看清时请用户处理，不发送。文件验证通过仅表示模型检查，不等于已经打印。

本机软件 `/Applications/BambuStudio.app`，bundle ID `com.bambulab.bambu-studio`。UI 操作使用 cua_repl，不能使用 AppleScript。选应用后先查看最新 AX 状态。打开中文路径可用 Command+O，Command+Shift+G，输入完整路径，回车，点击打开。必要时在 GUI 重新切片，核对 12 件、同一盘、A1 及上述参数。普通延时摄影不支持，发送时关闭延时摄影。

打印前先在状态文件记录 `send_attempt_started_at`，点击发送后如工具中断，恢复时必须先检查设备与打印历史，不能直接重试。只有设备页出现对应 v0.3 作业并进入准备或打印才记录 `job_sent: true`、设备名称、开始时间，更新验证报告。若发送后状态不明，保持待核对，避免重复提交。

旧版曾出现原生发送对话框截图缩放异常，图像展示的是桌面缩小版但点击仍是对话框本地坐标。不要复用旧坐标；通过当前 AX 和截图判断。上次成功后先显示上传进度，设备页随后显示正确作业名、归零和加热。

发送后继续跟进这一次作业直到完成或失败。只在有实质状态变化、完成、失败或需要用户操作时报告，等待期间保持安静。核实设备显示本次作业完成后，记录结果、完成当前目标，并暂停本跟进自动任务。一次打印失败不自动无限重打。当前自动任务的 ID 记录在状态文件。
