88431844/myMicroByte/printing/A1_black_PLA_v04/打印跟进.md

# v0.4 打印跟进

用户已确认爆炸图并明确回复“可以打印了”，30 分钟后自动打印条件已被即时批准取代。
已通过本机 Bambu Studio 发送，A1 当前作业名称 **myMicrobyte_v04_A1_black_PLA_sliced**。前盖、后盖、电源拨帽三件一盘，AMS A4 黑色 PLA，0.4 mm 喷嘴，纹理 PEI；发送前摄像机确认平台为空。
GUI 切片总估时 55m43s（含准备流程），19.91 g，87 个层事件。已核实设备显示本次作业 1%、0/87、动态流量校准，预计 2026-10-17 01:39 完成。以设备后续时间为准。

**不要再次发送。** 只观察已经开始的本次作业，更新 print_followup_state.json。出现失败不自动重打；若仍是本作业并完成，保存完成截图到 reports/v04，记录 completed_at，完成本聊天目标，暂停 v0.4 跟进自动任务。

旧 v0.3 已完成，自动任务保持 PAUSED。另一项目 esp32-remote-R2-A3-PETG 在本次发送前已完成且打印板已清空，不要操作它。

当前 GUI 会话使用 cua_repl；bambu04 绑定 Bambu Studio。第一次恢复时先 rewriteDocumentation。使用 getAXStateAndScreenshot 可可靠获取弹窗原尺寸，单独 getScreenshot 在弹窗切换时曾返回缩小的父窗口。只读观察不需要额外用户批准。若摄像机休眠可点击播放；设备状态和作业名是确认完成的主要依据。

## 已完成

2026-10-17T01:41:40.386497+08:00 已观察到 A1 对应 v0.4 作业 100%、87/87、完成。完成证据：reports/v04/A1_v04_completed_status.png。不要再次发送。
