88431844/myMicroByte/output/v10/v10_assembly_review.png

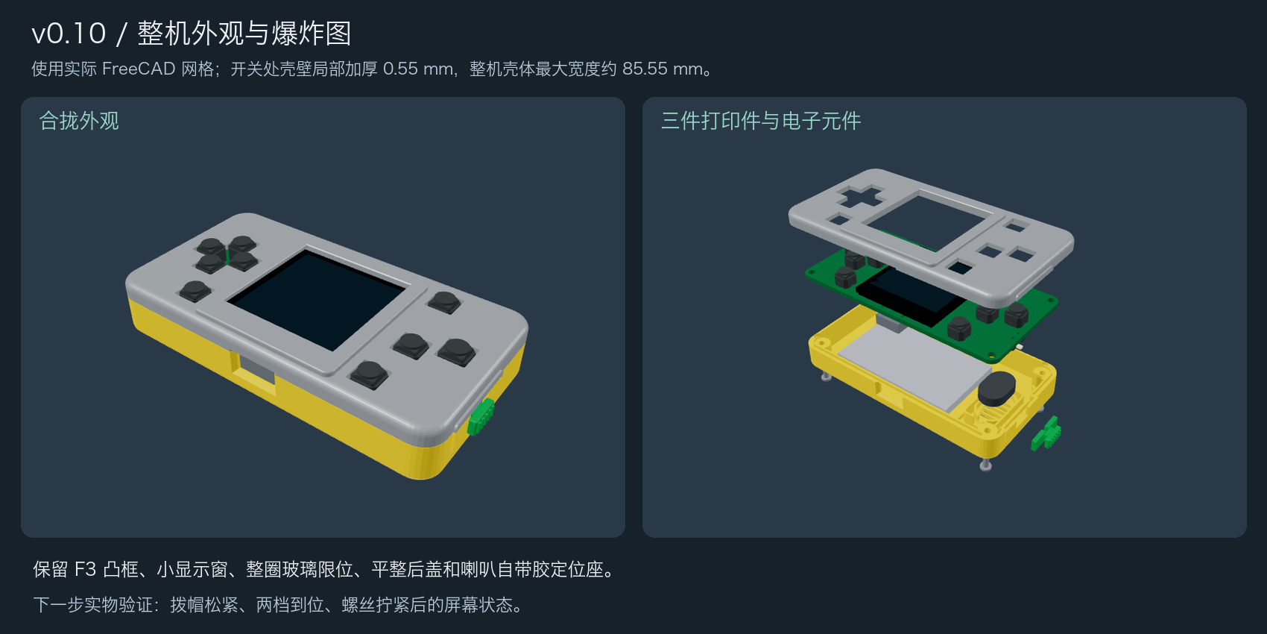
output/v10/v10_assembly_review.png
