88431844/myMicroByte/reports/assembly_exports/v10/myMicrobyte-v10-装配视图 (9).png

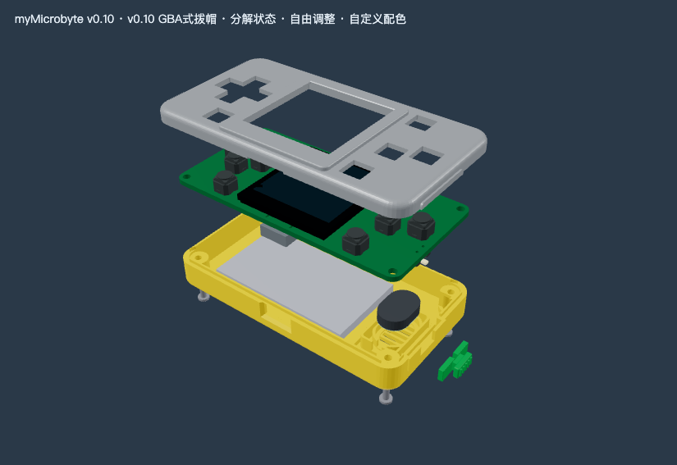
reports/assembly_exports/v10/myMicrobyte-v10-装配视图 (9).png
