88431844/myMicroByte/reports/blackPLA_assembly.png

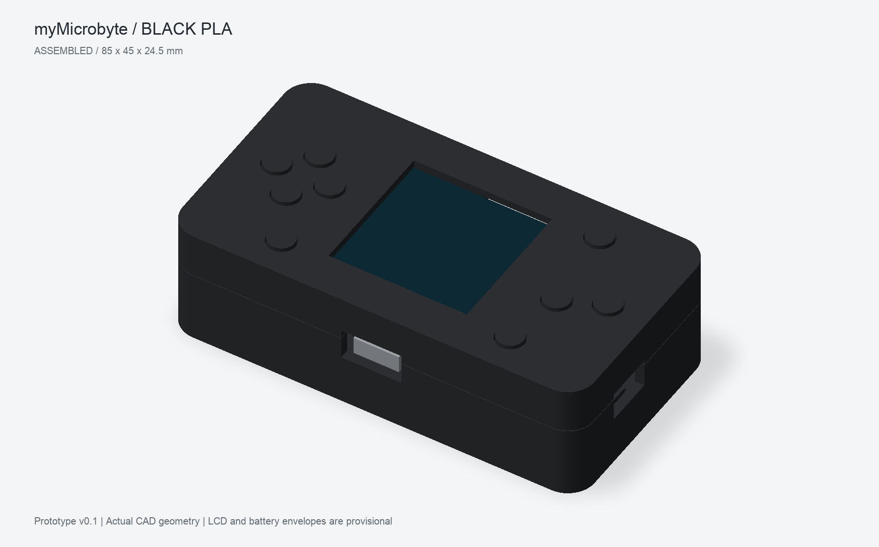
reports/blackPLA_assembly.png
