88431844/myMicroByte/reports/expanded_rear_2/print_started.png

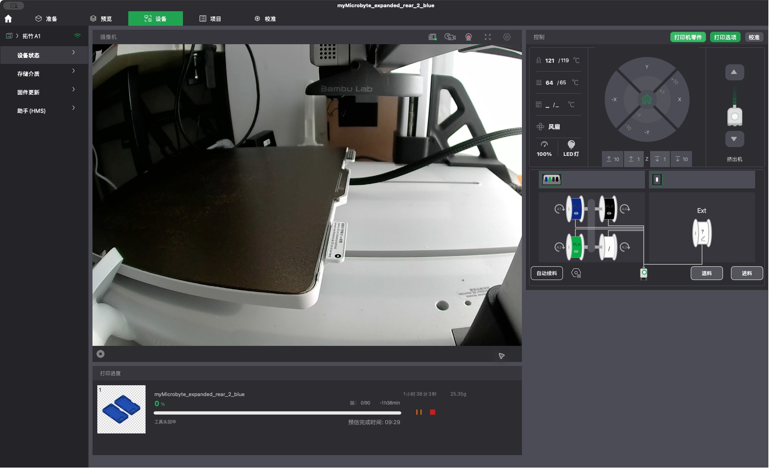
reports/expanded_rear_2/print_started.png
