88431844/myMicroByte/reports/v10/front_roof_install.png

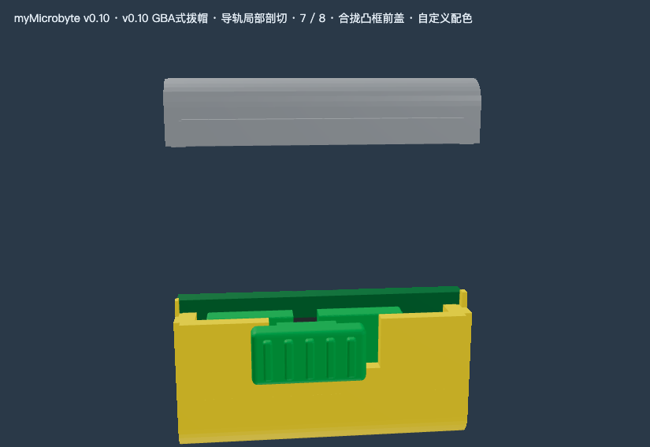
reports/v10/front_roof_install.png
