88431844/myMicroByte/reports/v10/slider_guide_section.png

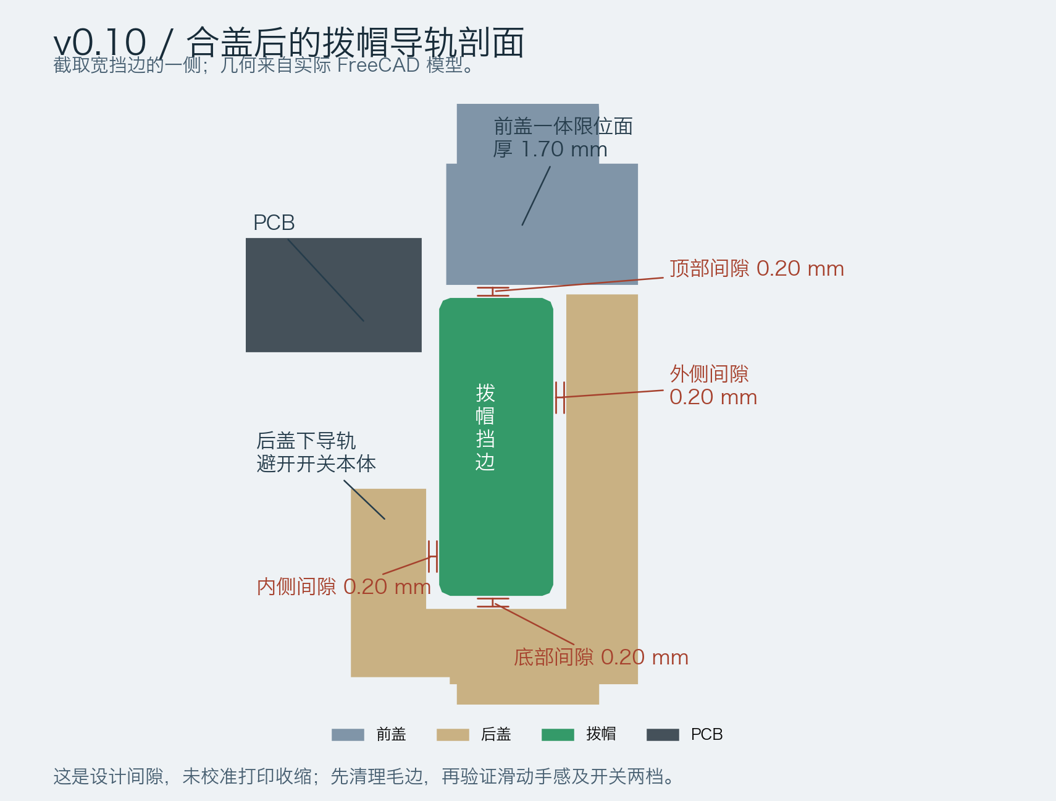
reports/v10/slider_guide_section.png
