88431844/myMicroByte/reports/v03/assembly-guide-validation.md

# v0.3 交互装配工作台验证

2026-10-16。页面：`output/assembly-guide/index.html`。

## 已验证

- 使用原始 `preview_meshes.b64`，59 个实际 CAD / 参考实体，压缩数据逐字一致。显示按 17 组组织；12 个打印件均保留。
- 单文件 1,449,868 字节；没有外链 script 或 stylesheet，Three.js、OrbitControls 和模型均内嵌。Three.js 固定为 0.160.1。
- JavaScript 语法检查通过。
- 在 Codex 内置浏览器经 `http://127.0.0.1:8766/index.html` 实际加载；无 JavaScript error，Three.js UMD 有弃用提示，不影响此固定版本运行。
- 九个步骤均切换成功，各步骤按预期显示零件；可移动步骤的可见实体数量依次为 5、14、51、52、3、55、59。
- 按键装入动画到达 100%；步骤说明与观察方向同步更新。
- 电池 X 偏移 0.5 mm 和备注写入后，刷新页面保留。
- 导出 JSON 文件实际出现在 Downloads，包含电池偏移 `[0.5,0,0]` 与对应备注；清除界面试验值后重新导入成功恢复。测试副本：`assembly-guide-test-record.json`。
- 电池单独查看为 1/59；后盖内部为 3/59；显示全部恢复 59/59。
- 九键下压至 0.6 mm、拨帽至 1.8 mm 的控件和显示值正确；外壳半透明可切换。
- 保存视图实际生成 PNG 文件。
- 320 px 窄屏下模型正常显示，页面 scrollWidth = clientWidth = 320；无水平溢出。测试后恢复默认视口。
- 交付前清除了测试用电池偏移与备注，运动归零；未把演示动画标记为实物检查完成。

## 验证边界

浏览器自动化仅允许 HTTP/HTTPS，拒绝直接导航 file: URL，因此没有通过自动化验证双击离线打开的动作。已验证页面不依赖外部页面资源，所有显示内容均在文件内；可用新版浏览器直接打开单文件。当前已打开并验证的交互入口使用本机 HTTP 服务。

此项仅为页面改进，不改动 FreeCAD、打印 STL 或已完成的打印作业；不重跑此前通过的 CAD 干涉和切片检查。

桌面截图：`assembly-guide-desktop.png`。
