88431844/myMicroByte/reports/battery_expansion/电池扩容前后对比.pdf

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

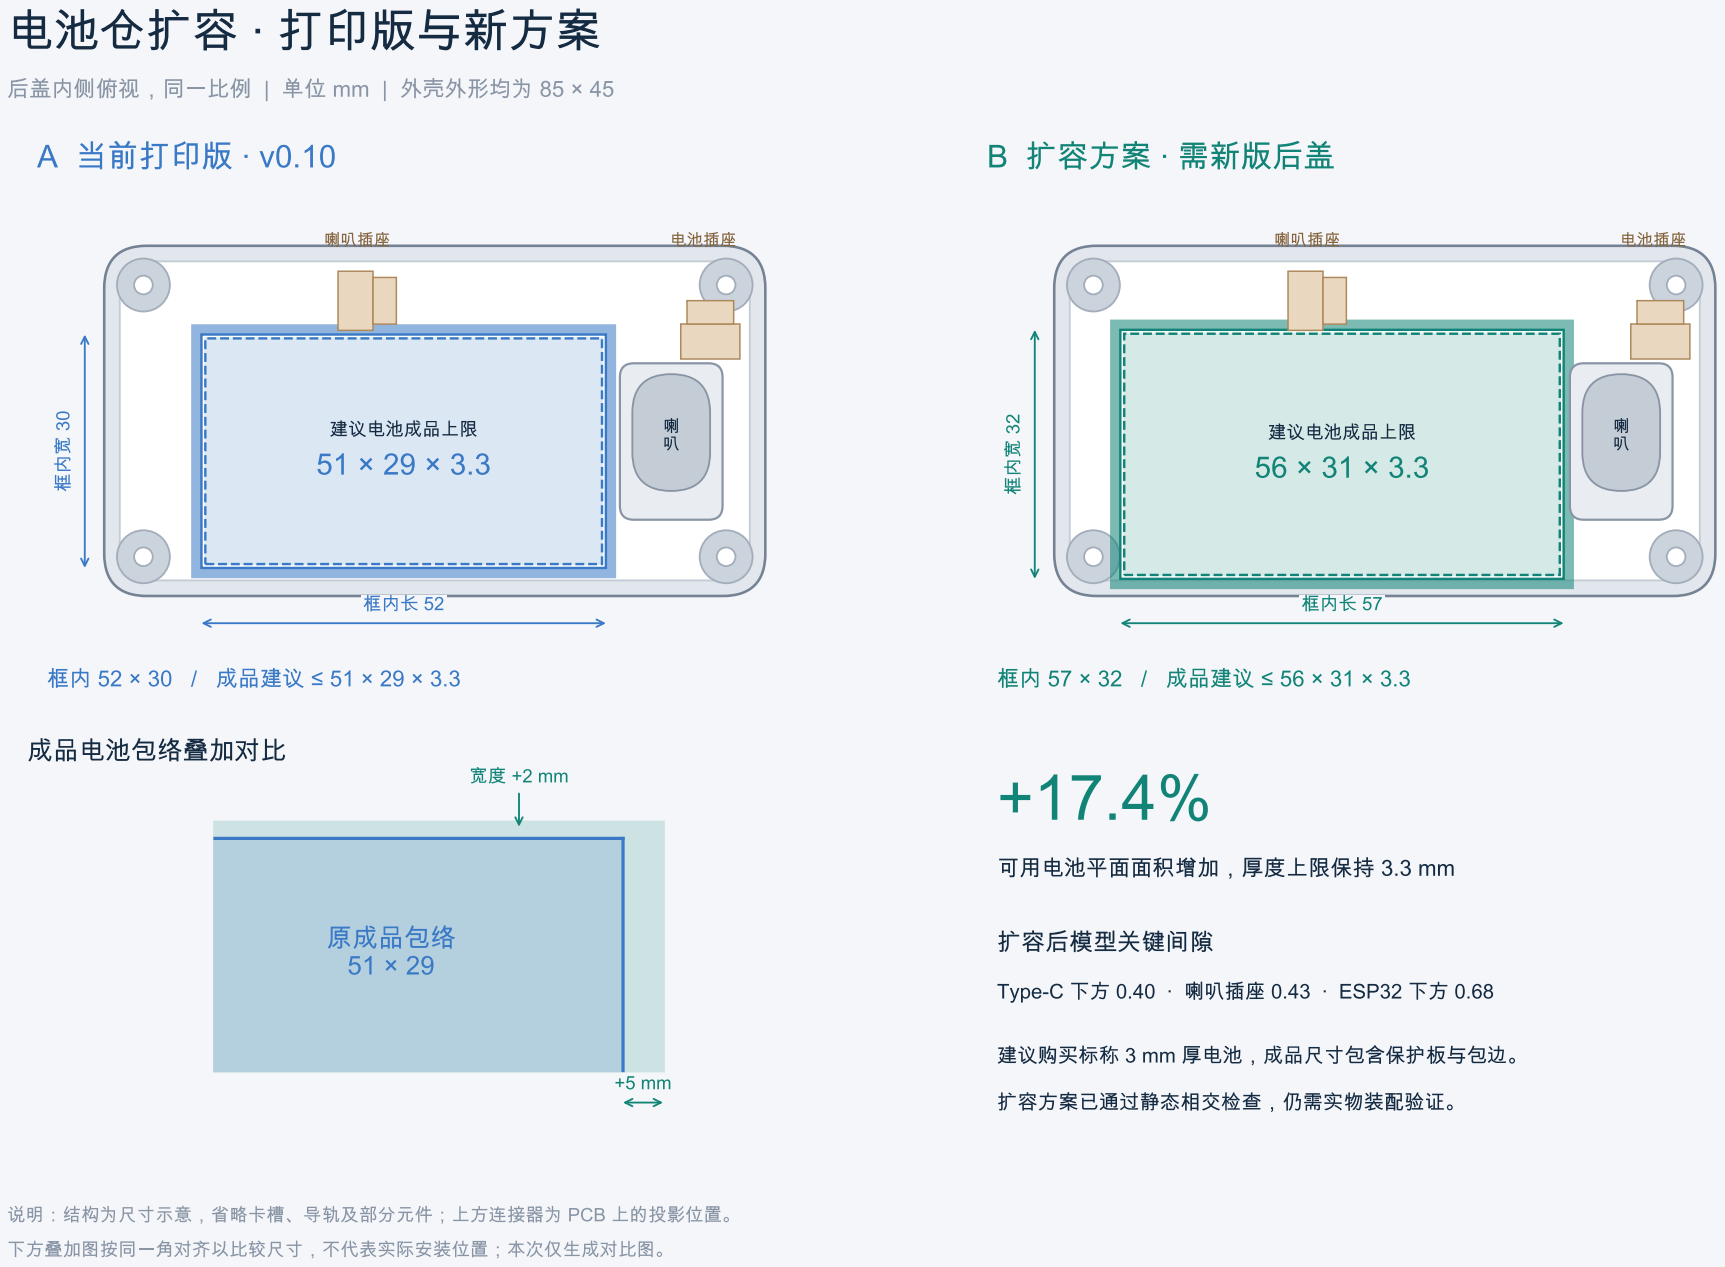
[picture p109: page 1]
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
