88431844/myMicroByte/(list of files, drawings)

Other design files:
reference/pcb-current-parsed.json
