88431844/myMicroByte/reference/filaments_20261017/loaded_slots.jpg

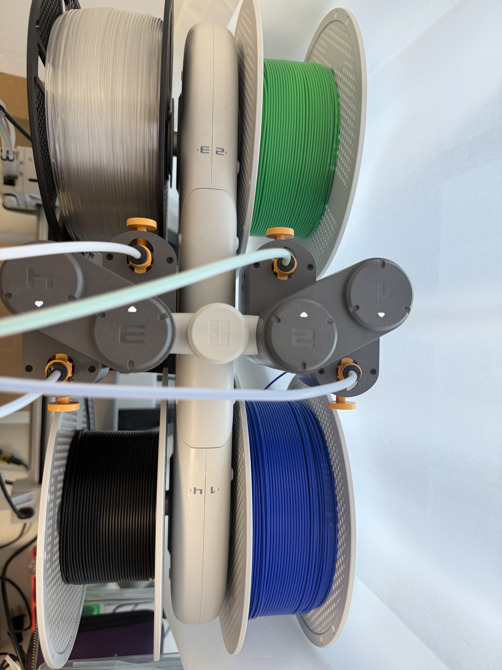
reference/filaments_20261017/loaded_slots.jpg
