88431844/myMicroByte/reference/filaments_20261017/stock.jpg

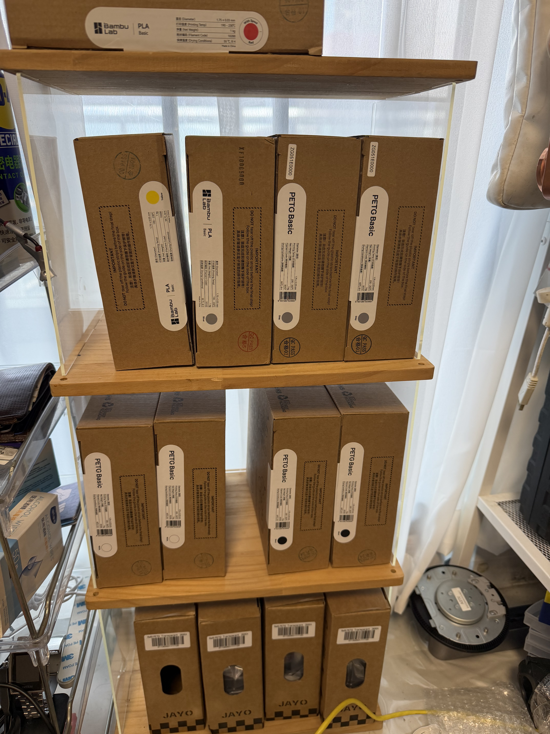
reference/filaments_20261017/stock.jpg
