88431844/myMicroByte/reference/v09_feedback/IMG_8480.jpg

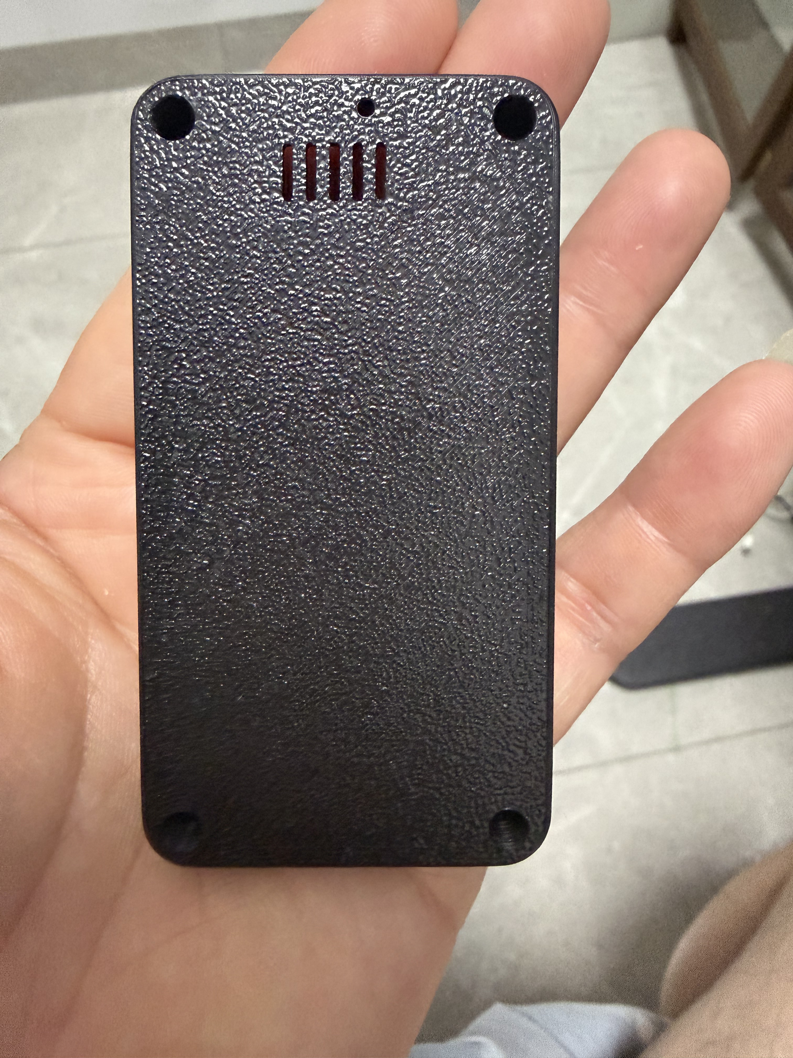
reference/v09_feedback/IMG_8480.jpg
